noahbachmann/buddy/parts/dispenser/side.png

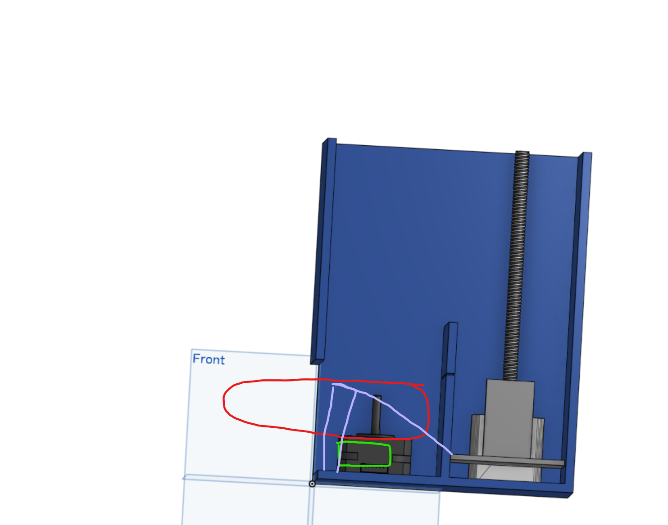
parts/dispenser/side.png
