noahbachmann/buddy/parts/dispenser/up.png

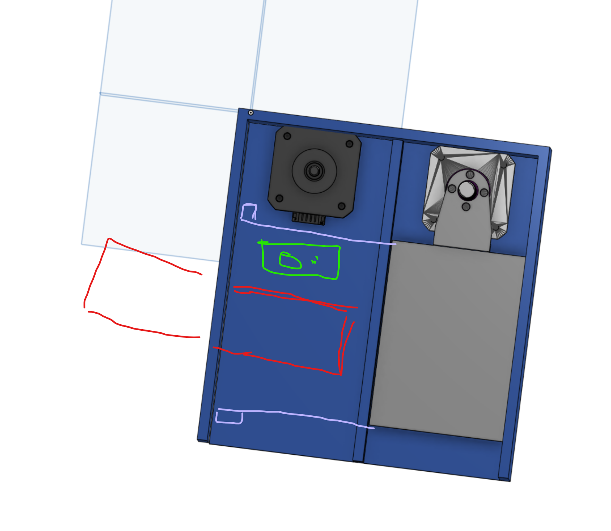
parts/dispenser/up.png
