noahbachmann/buddy/parts/arm/stl/shoulder-mount.stl

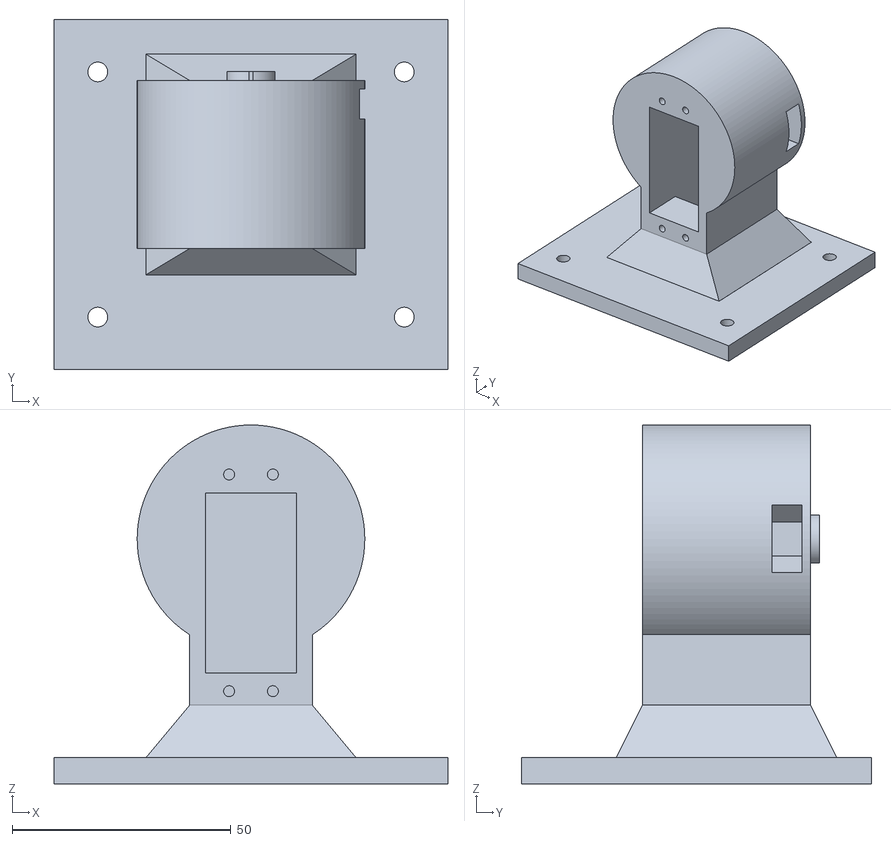
[picture p3: CAD file, 2026-11-06]
parts/arm/stl/shoulder-mount.stl
90.0 x 80.0 x 82.0
