noahbachmann/buddy/parts/dispenser/dispenser-roller.stl

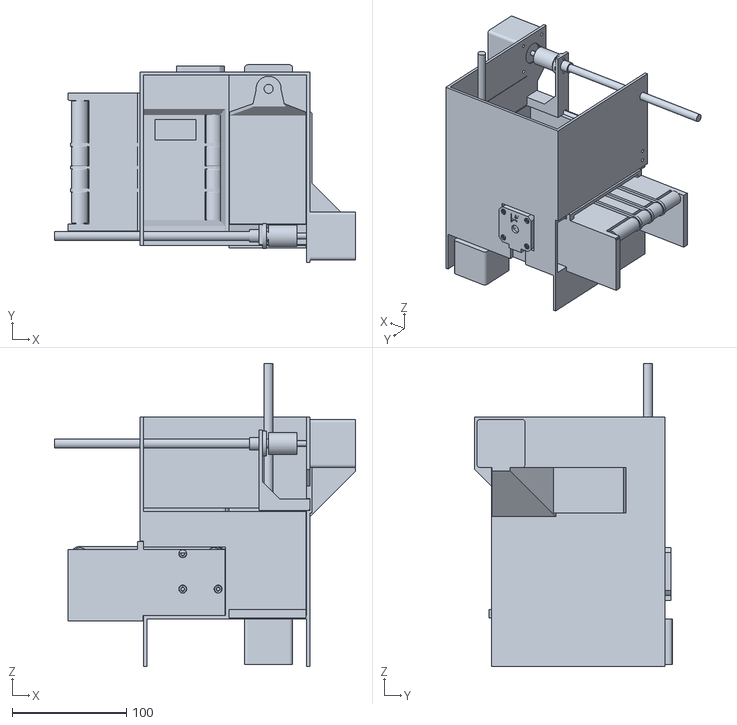
[picture p4: CAD file, 2026-11-11]
parts/dispenser/dispenser-roller.stl
264.0 x 173.3 x 266.0
