noahbachmann/buddy/parts/dispenser/plates/2-petg.stl

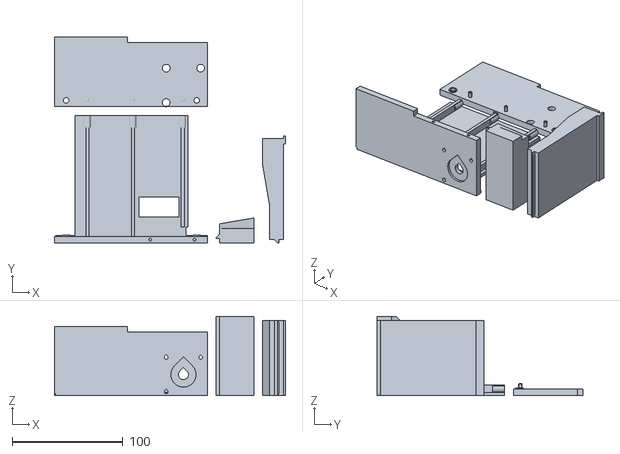
[picture p5: CAD file, 2026-11-11]
parts/dispenser/plates/2-petg.stl
208.1 x 185.5 x 71.6
