noahbachmann/buddy/parts/dispenser/ref/lift.stl

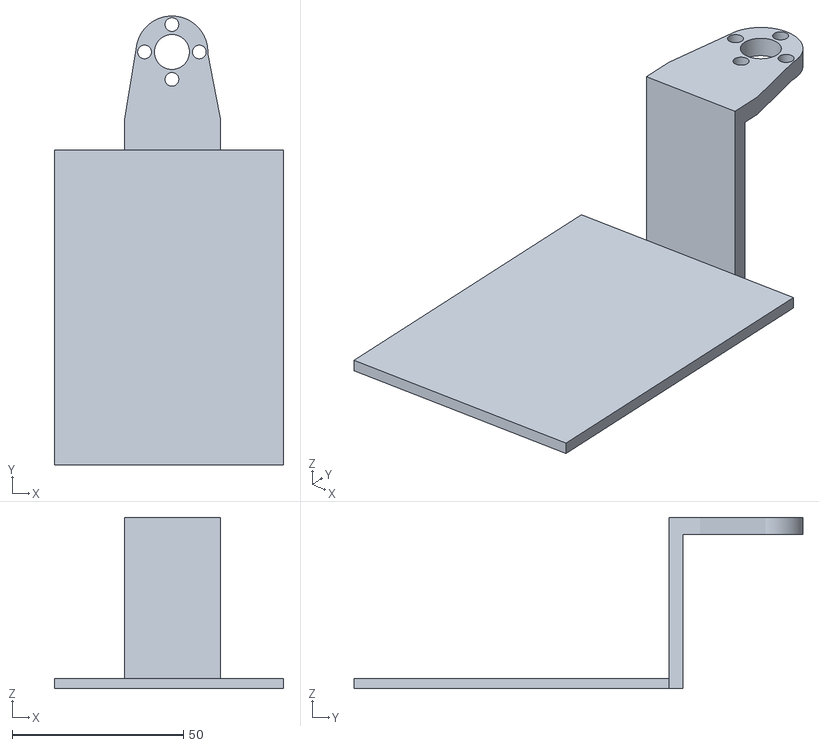
[picture p6: CAD file, 2026-11-07]
parts/dispenser/ref/lift.stl
67.0 x 131.1 x 50.0
