noahbachmann/buddy/parts/dispenser/stl/pusher.stl

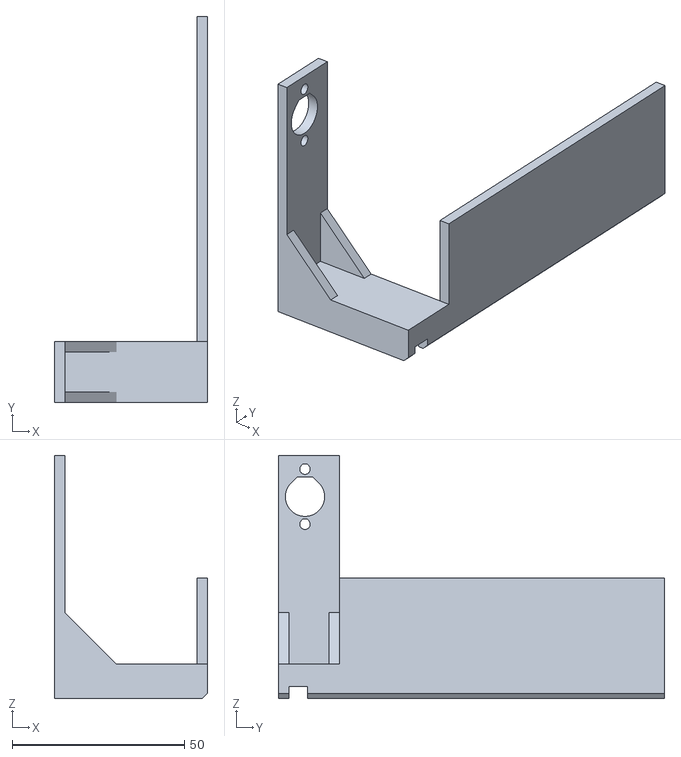
[picture p7: CAD file, 2026-11-11]
parts/dispenser/stl/pusher.stl
44.5 x 112.2 x 70.7
