noahbachmann/buddy/parts/tray/tray.3mf

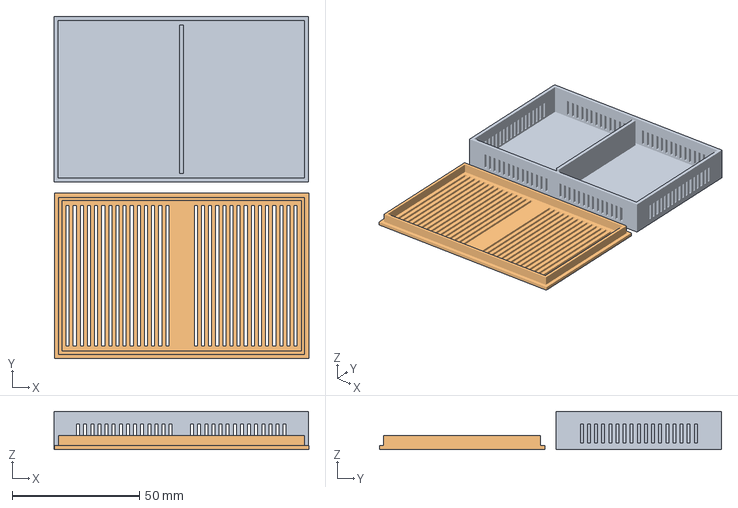
[picture p8: CAD file, 2026-11-09]
parts/tray/tray.3mf
100.1 x 134.4 x 15.0 mm
tray-box.stl
tray-lid.stl
