noahbachmann/buddy/parts/arm/stl/upper-arm-top.stl

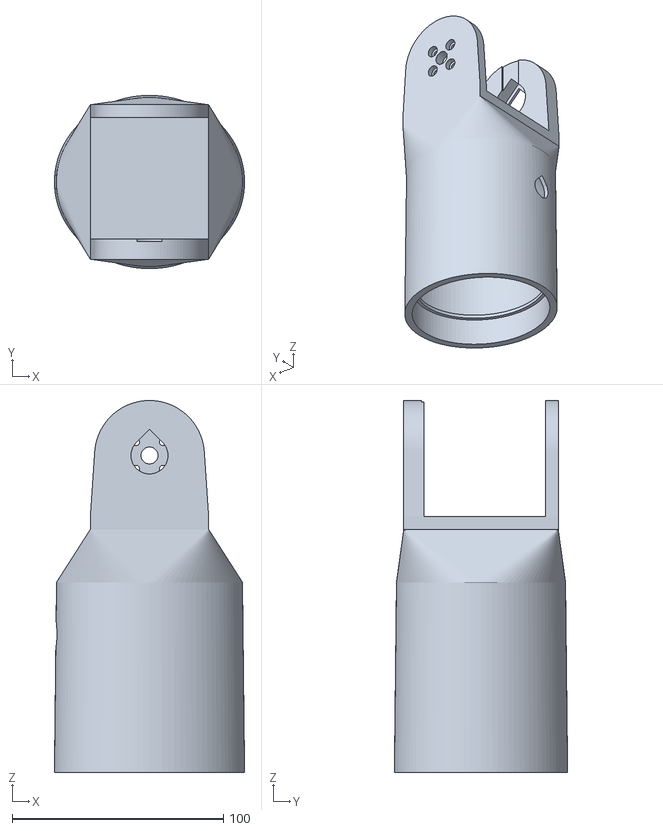
[picture p9: CAD file, 2026-11-06]
parts/arm/stl/upper-arm-top.stl
90.0 x 82.0 x 176.0
