noahbachmann/buddy/parts/dispenser/dispenser.stl

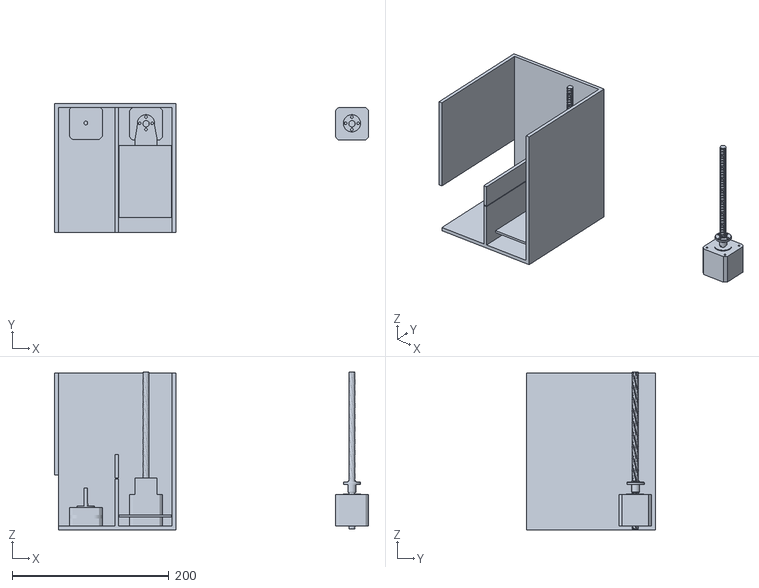
[picture p10: CAD file, 2026-11-07]
parts/dispenser/dispenser.stl
401.0 x 165.0 x 201.2
