noahbachmann/buddy/parts/dispenser/plates/3-pla.stl

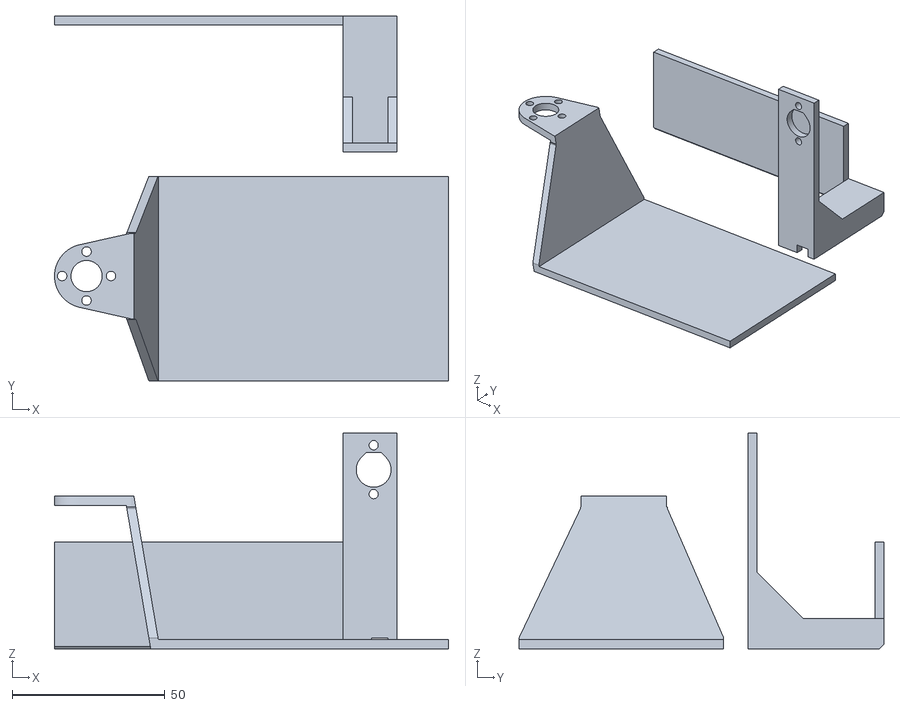
[picture p11: CAD file, 2026-11-10]
parts/dispenser/plates/3-pla.stl
129.0 x 119.5 x 70.7
