noahbachmann/buddy/parts/dispenser/ref/box.stl

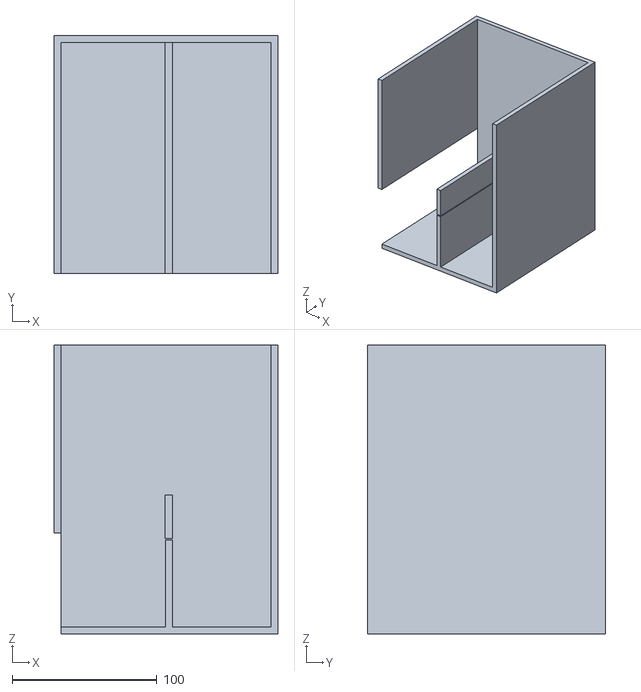
[picture p12: CAD file, 2026-11-07]
parts/dispenser/ref/box.stl
155.0 x 165.0 x 200.0
