noahbachmann/buddy/parts/dispenser/stl/border-h.stl

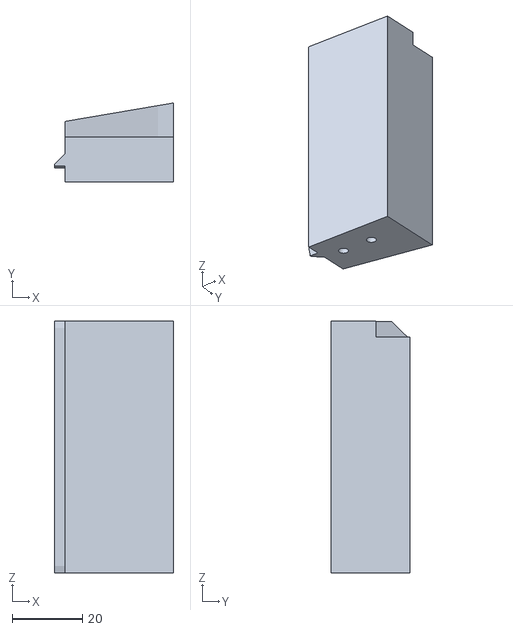
[picture p13: CAD file, 2026-11-11]
parts/dispenser/stl/border-h.stl
34.0 x 22.5 x 71.6
