noahbachmann/buddy/parts/tray/tray-lid.stl

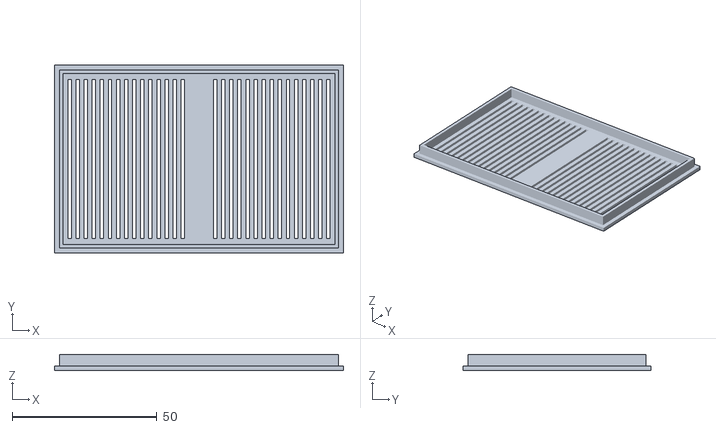
[picture p14: CAD file, 2026-11-07]
parts/tray/tray-lid.stl
100.0 x 65.0 x 5.60
