noahbachmann/buddy/parts/arm/stl/forearm-bottom.stl

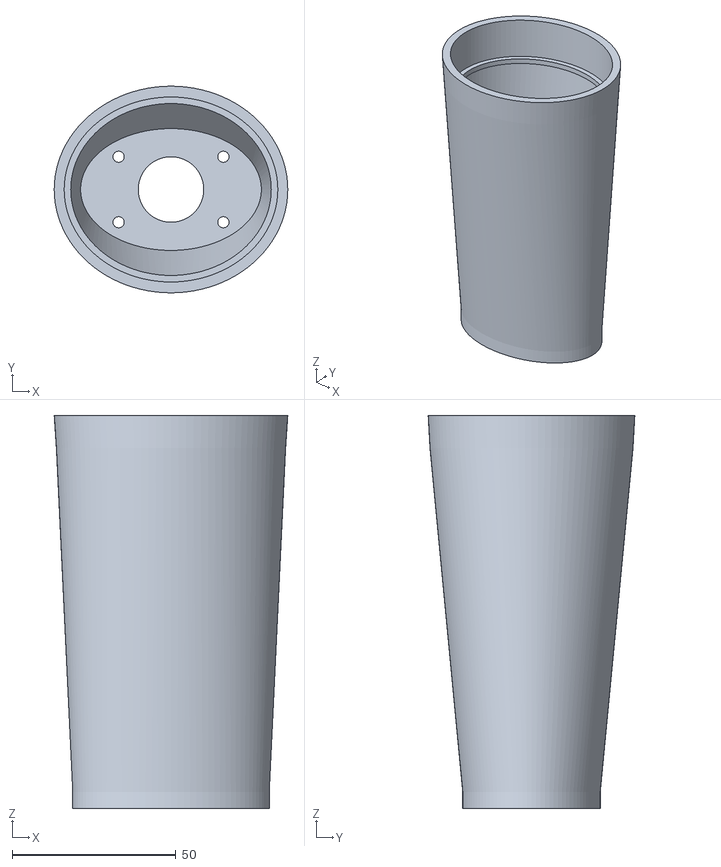
[picture p15: CAD file, 2026-11-06]
parts/arm/stl/forearm-bottom.stl
71.3 x 63.1 x 120.0
