noahbachmann/buddy/parts/dispenser/plates/1-petg-fine.stl

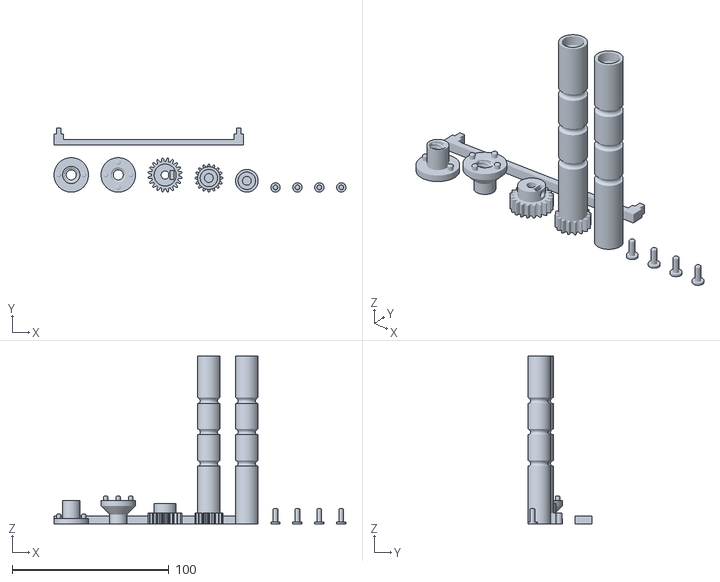
[picture p16: CAD file, 2026-11-09]
parts/dispenser/plates/1-petg-fine.stl
186.3 x 41.0 x 106.9
