noahbachmann/buddy/parts/dispenser/ref/m4023.stl

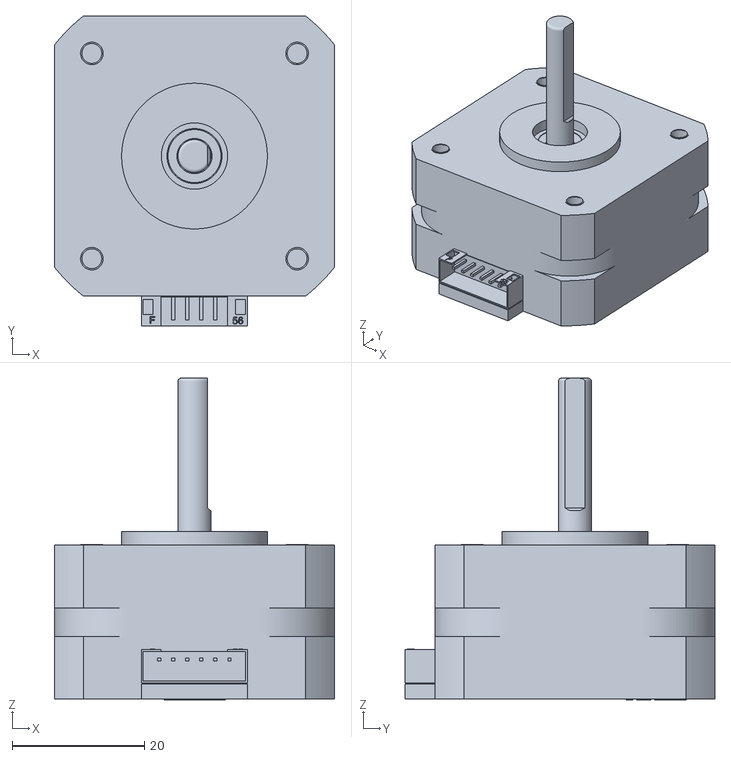
[picture p17: CAD file, 2026-11-07]
parts/dispenser/ref/m4023.stl
42.3 x 46.8 x 48.6
