noahbachmann/buddy/parts/dispenser/stl/roller-frame.stl

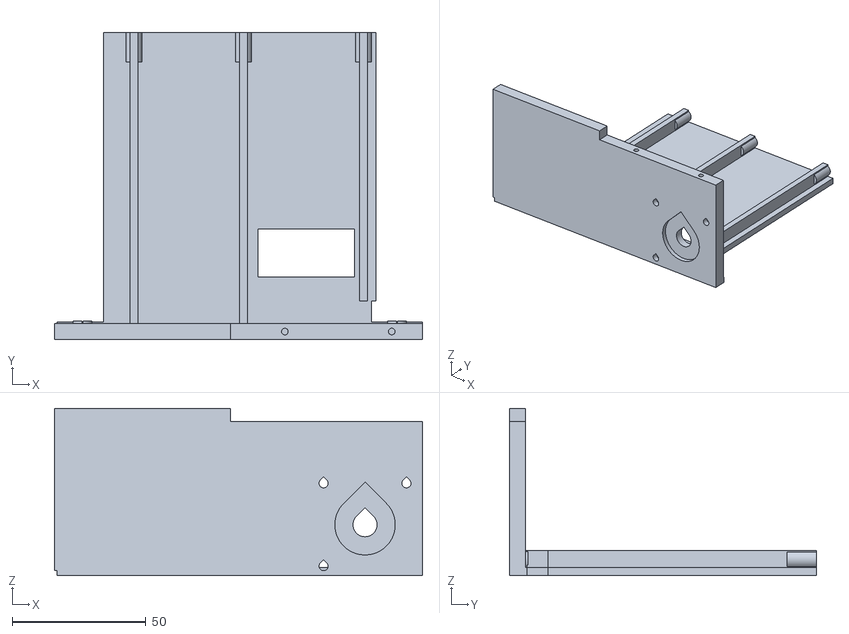
[picture p18: CAD file, 2026-11-11]
parts/dispenser/stl/roller-frame.stl
137.7 x 114.9 x 62.6
