noahbachmann/buddy/parts/tray/tray-box.stl

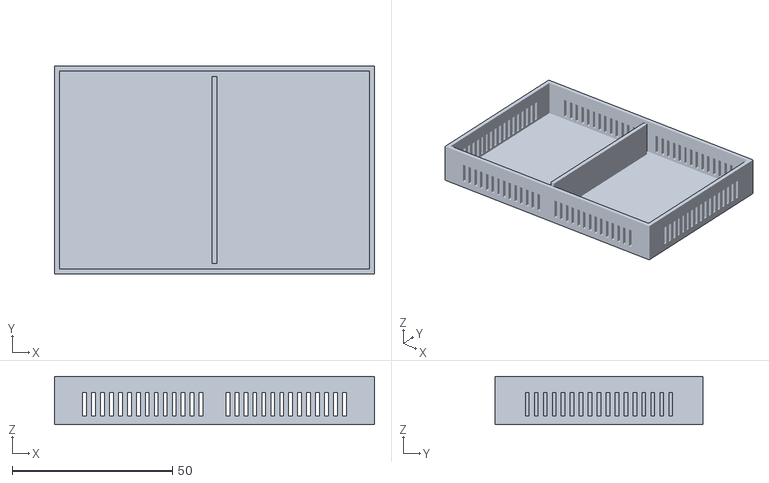
[picture p19: CAD file, 2026-11-06]
parts/tray/tray-box.stl
100.0 x 65.0 x 15.0
