noahbachmann/buddy/parts/arm/stl/forearm-top.stl

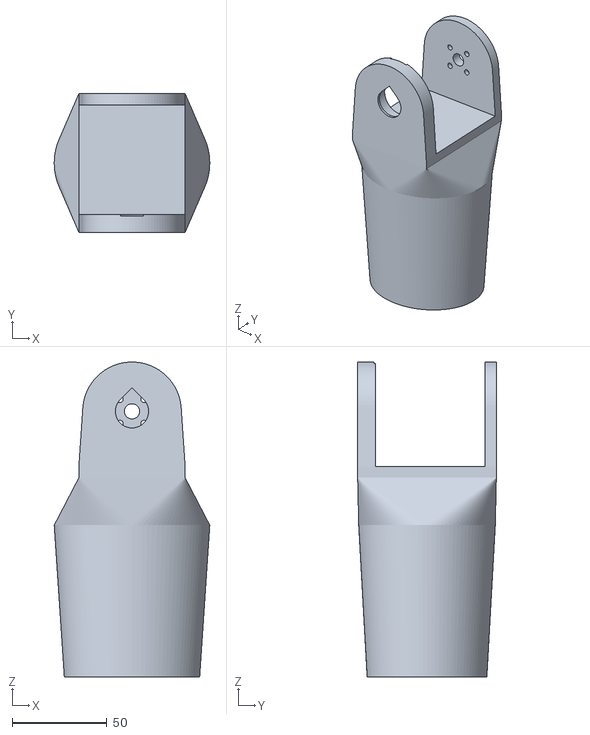
[picture p20: CAD file, 2026-11-06]
parts/arm/stl/forearm-top.stl
82.0 x 73.1 x 166.0
