noahbachmann/buddy/parts/dispenser/plates/0-fit-test.stl

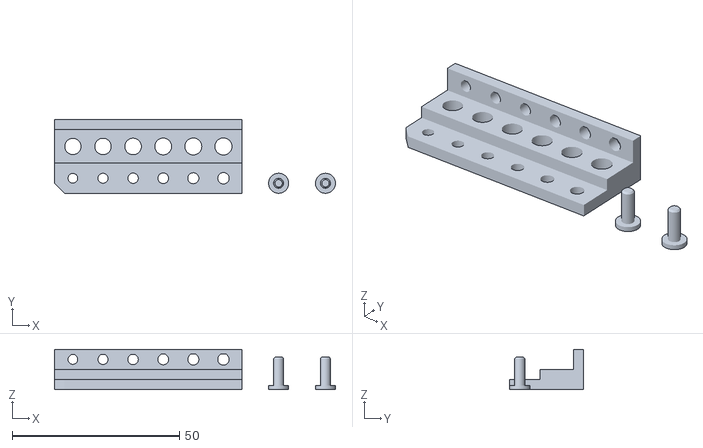
[picture p21: CAD file, 2026-11-09]
parts/dispenser/plates/0-fit-test.stl
84.0 x 22.0 x 12.0
