noahbachmann/buddy/parts/dispenser/stl/border-b.stl

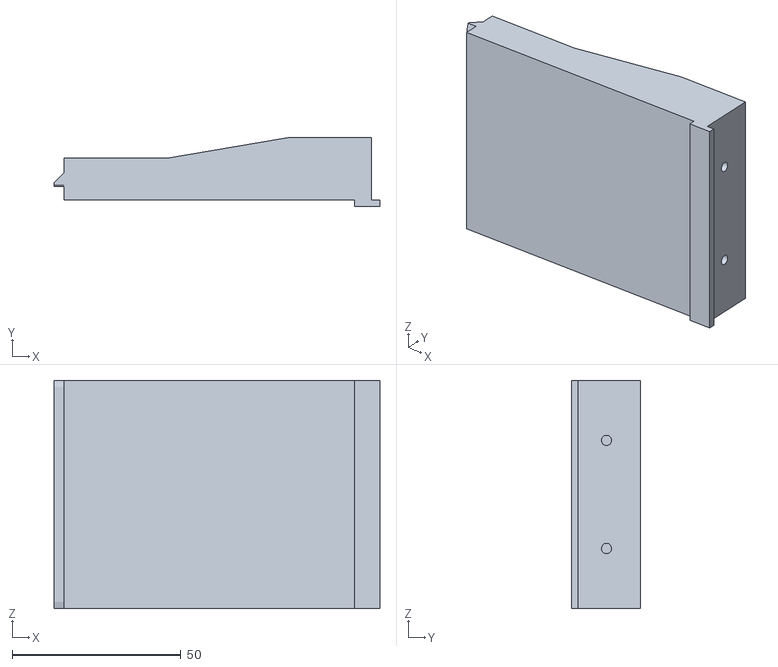
[picture p22: CAD file, 2026-11-11]
parts/dispenser/stl/border-b.stl
96.5 x 20.5 x 67.6
