noahbachmann/buddy/parts/arm/stl/couplers.stl

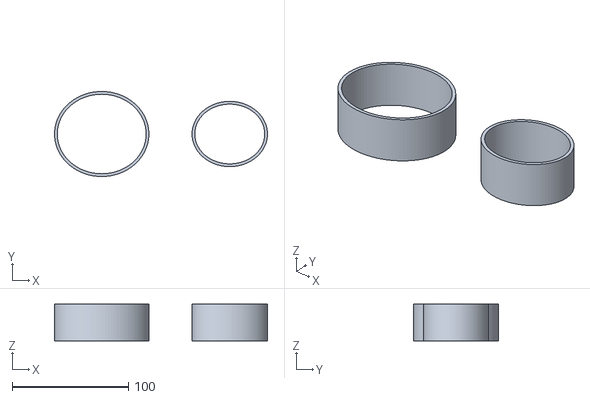
[picture p23: CAD file, 2026-11-06]
parts/arm/stl/couplers.stl
183.0 x 73.1 x 31.5
