noahbachmann/buddy/parts/dispenser/stl/case-spares.stl

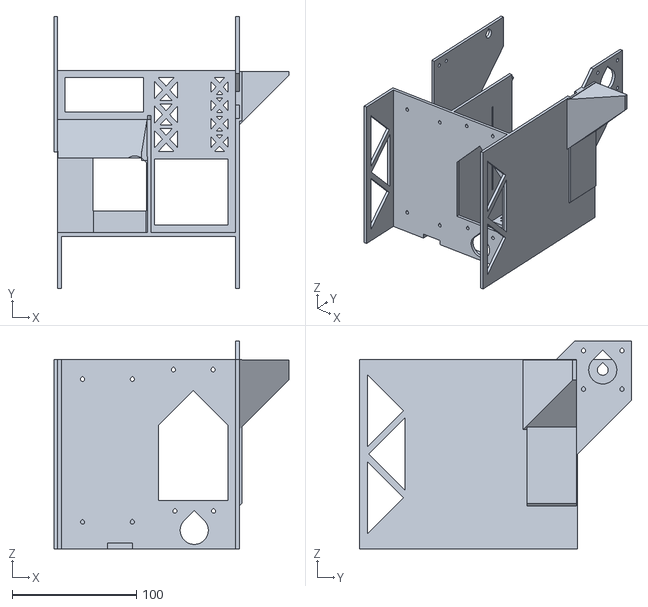
[picture p24: CAD file, 2026-11-10]
parts/dispenser/stl/case-spares.stl
189.0 x 218.8 x 167.1
