noahbachmann/buddy/parts/arm/stl/upper-arm-bottom.stl

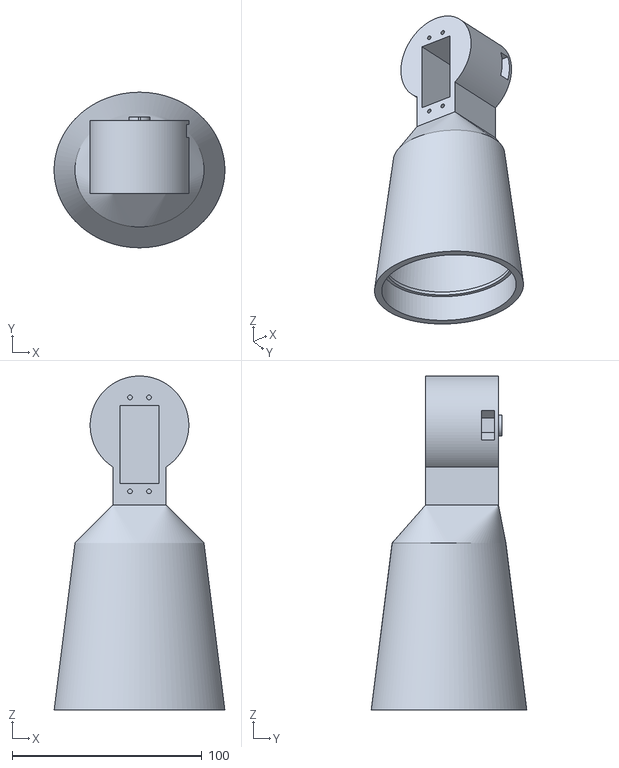
[picture p25: CAD file, 2026-11-06]
parts/arm/stl/upper-arm-bottom.stl
90.0 x 82.0 x 176.0
