noahbachmann/buddy/parts/dispenser/stl/lift.stl

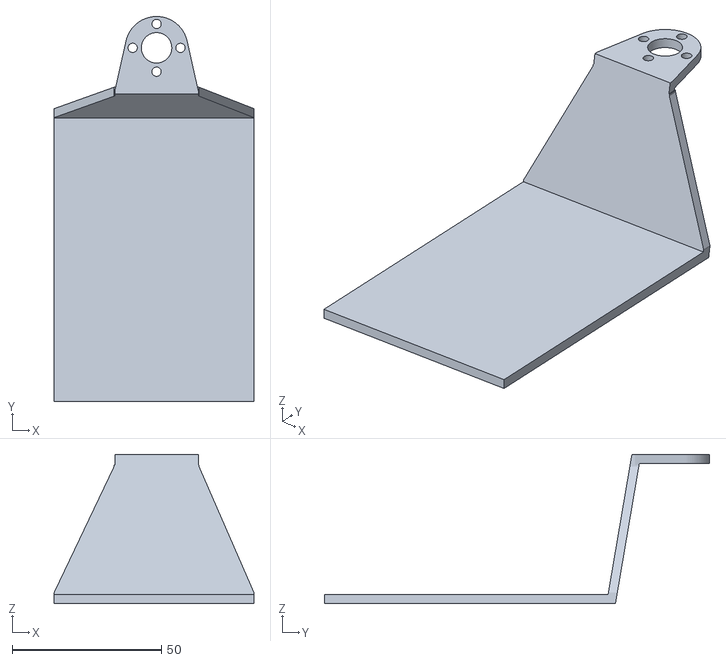
[picture p26: CAD file, 2026-11-10]
parts/dispenser/stl/lift.stl
67.0 x 129.0 x 50.0
