noahbachmann/buddy/parts/dispenser/stl/case.stl

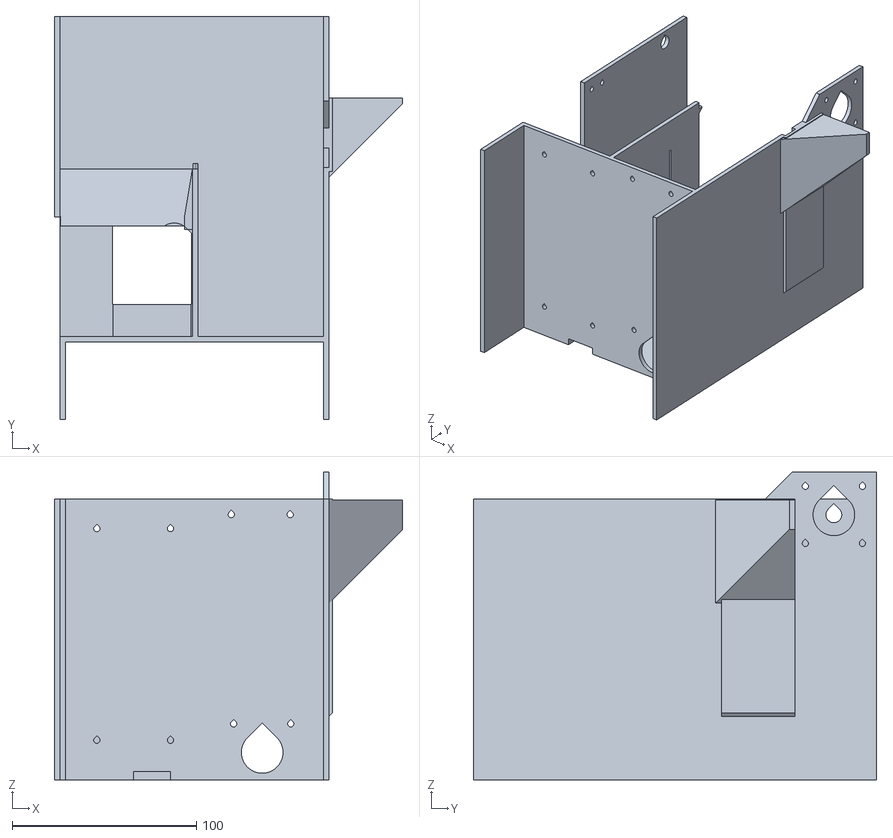
[picture p27: CAD file, 2026-11-09]
parts/dispenser/stl/case.stl
189.0 x 218.8 x 167.1
