noahbachmann/buddy/parts/dispenser/stl/front-plate.stl

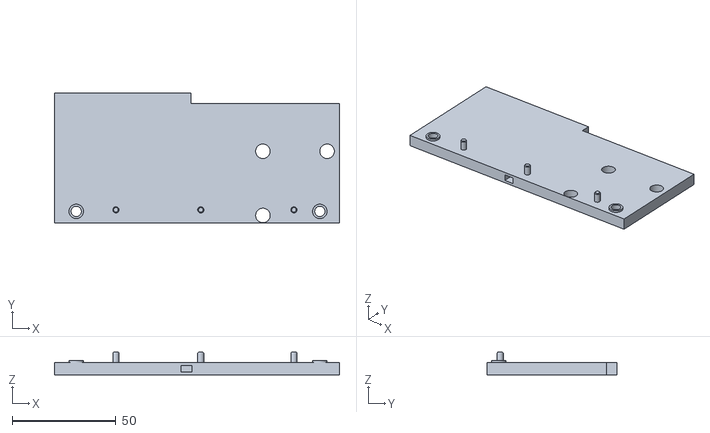
[picture p28: CAD file, 2026-11-09]
parts/dispenser/stl/front-plate.stl
137.7 x 62.6 x 11.0
