noahbachmann/buddy/parts/dispenser/stl/fit-test.stl

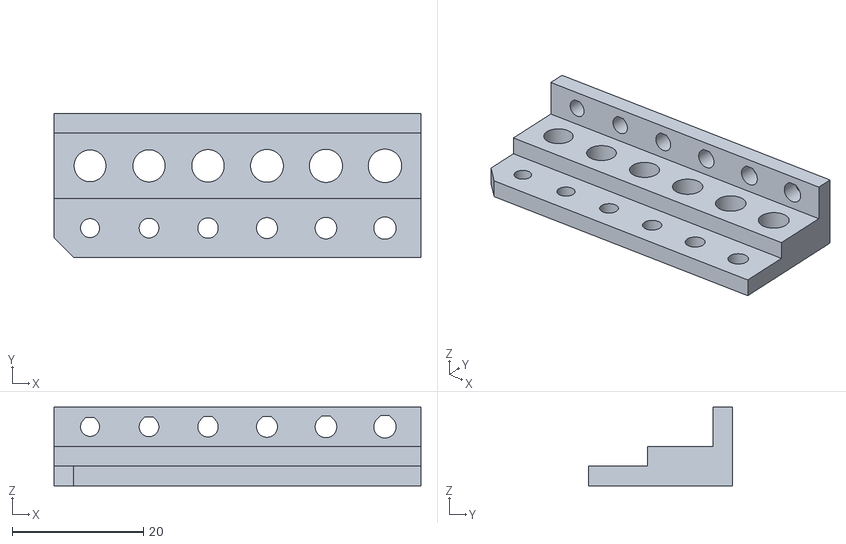
[picture p29: CAD file, 2026-11-09]
parts/dispenser/stl/fit-test.stl
56.0 x 22.0 x 12.0
