noahbachmann/buddy/parts/dispenser/stl/border-pin.stl

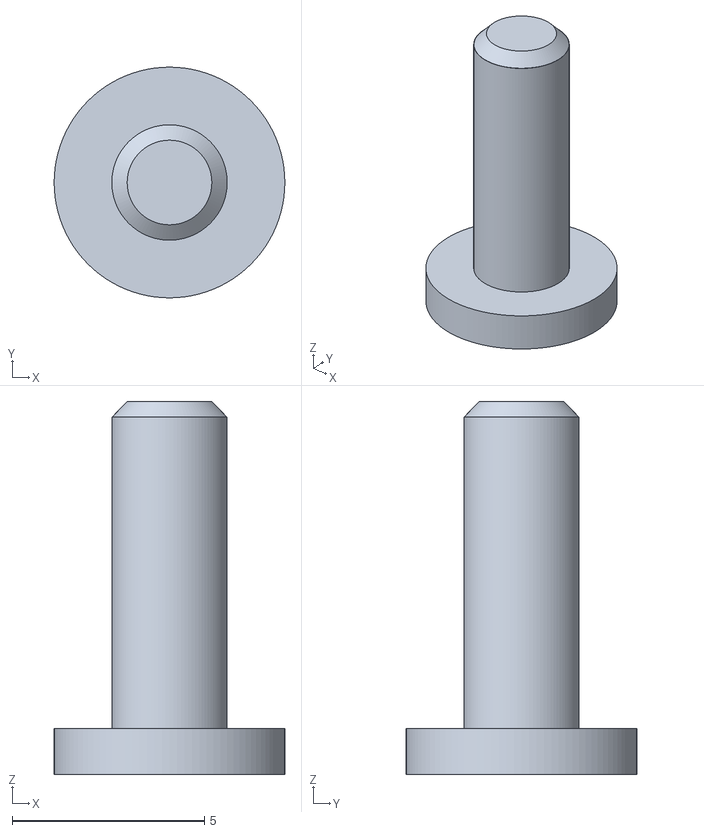
[picture p30: CAD file, 2026-11-09]
parts/dispenser/stl/border-pin.stl
6.00 x 6.00 x 9.70
