noahbachmann/buddy/parts/dispenser/stl/drive-drum.stl

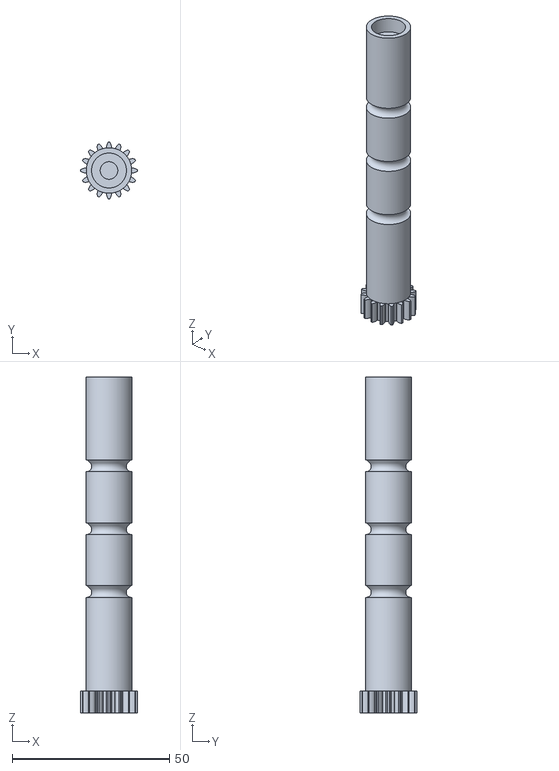
[picture p31: CAD file, 2026-11-09]
parts/dispenser/stl/drive-drum.stl
18.0 x 18.0 x 106.9
