noahbachmann/buddy/parts/dispenser/stl/idler-drum.stl

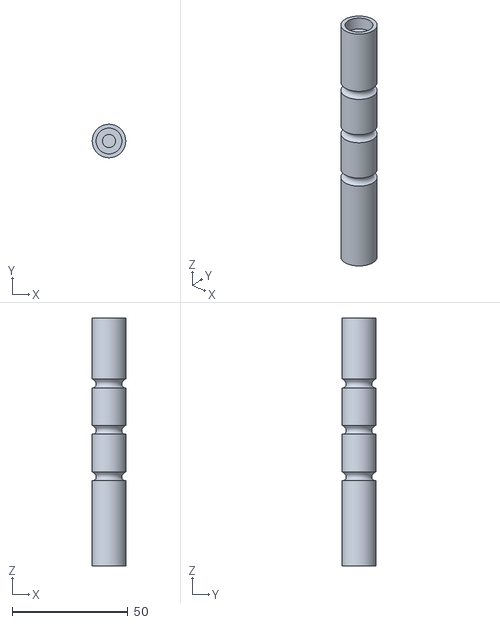
[picture p32: CAD file, 2026-11-09]
parts/dispenser/stl/idler-drum.stl
14.5 x 14.5 x 106.9
