noahbachmann/buddy/parts/dispenser/stl/gate-left.stl

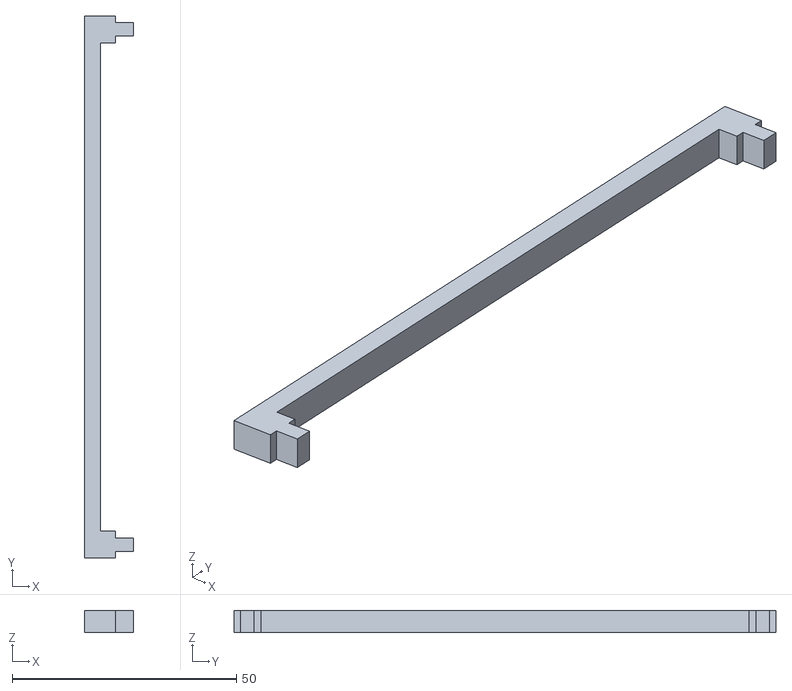
[picture p33: CAD file, 2026-11-09]
parts/dispenser/stl/gate-left.stl
11.0 x 120.9 x 5.00
