noahbachmann/buddy/parts/dispenser/stl/motor-gear.stl

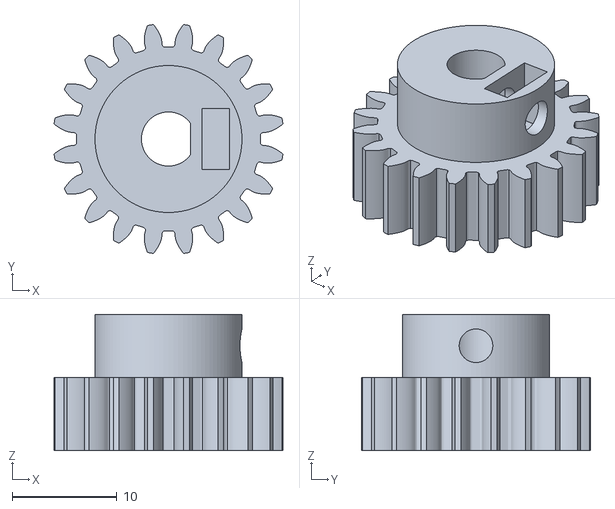
[picture p34: CAD file, 2026-11-07]
parts/dispenser/stl/motor-gear.stl
21.8 x 21.8 x 13.0
