noahbachmann/buddy/parts/dispenser/border-pin.scad

// Printed pin for the borders (4×: 2 through the left wall into border H, 2 from below into border B). Head down.
include <lib.scad>
border_pin();
