noahbachmann/buddy/parts/dispenser/drive-drum.scad

// Drive drum: 16T gear + 3 O-ring grooves, 2x 685ZZ pressed into the ends. Print gear down.
include <lib.scad>
drum(true);
