noahbachmann/buddy/parts/dispenser/motor-gear.scad

// 20T gear on the 4023's D-shaft, M3 set screw onto the flat. Print gear down.
include <lib.scad>
translate([0, 0, -gear_z0]) motor_gear();
