noahbachmann/buddy/parts/dispenser/assembly.scad

// Roller + pusher in the case (Dev's box + changes). Preview only (F5). part = one placed piece for make_copy.py and the checks.
// Poses: push = 0 (home) .. 1 (end of stroke), lift_top = lift plate top (push_lift while pushing).
include <lib.scad>

part = "all";
push = 0;
lift_top = lift_min;

module piece(name) {
  if (name == "frame")           frame();
  else if (name == "front-plate") front_plate();
  else if (name == "drive-drum") drum_tf(drive_x) drum(true);
  else if (name == "idler-drum") drum_tf(idler_x) drum(false);
  else if (name == "motor-gear") motor_tf() motor_gear();
  else if (name == "gate-left")  gate_placed();
  else if (name == "motor")      motor_4023();
  else if (name == "pins")       pins();
  else if (name == "belts")      belts();
  else if (name == "pusher")     pusher(push);
  else if (name == "case-add")   difference() { case_add(); box_cuts(); }
  else if (name == "pusher-motor") m4401();
  else if (name == "pusher-coupling") pu_coupling();
  else if (name == "pusher-screw") pu_screw();
  else if (name == "lift-motor") lift_motor();
  else if (name == "lift-coupling") lift_coupling();
  else if (name == "lift-screw") lift_screw();
  else if (name == "pusher-nut") pu_nut(push);
  else if (name == "case")       case();
  else if (name == "border-h")   h_insert();
  else if (name == "border-b")   b_insert();
  else if (name == "lift")       lift_part(lift_top);
  else if (name == "lift-nut")   lift_nut(lift_top);
}

if (part != "all") piece(part);
else {
  %piece("case");
  color("lightsteelblue") { piece("border-h"); piece("border-b"); }
  color("plum") piece("lift");
  color("goldenrod") piece("lift-nut");
  color("orange") { piece("frame"); piece("front-plate"); }
  color("teal") { piece("drive-drum"); piece("idler-drum"); piece("motor-gear"); }
  color("gold") piece("gate-left");
  color("dimgray") piece("motor");
  color("silver") piece("pins");
  color("black") piece("belts");
  color("tomato") piece("pusher");
  color("lightsteelblue") piece("case-add");   // changes to Dev's box
  color("dimgray") piece("pusher-motor");
  color("silver") { piece("pusher-screw"); piece("pusher-coupling"); piece("lift-screw"); piece("lift-coupling"); }
  color("dimgray") piece("lift-motor");
  color("goldenrod") piece("pusher-nut");
  // card on the belts, centred between the gates
  color("white", 0.6) translate([card_x0, card_yc - card[1] / 2, belt_top]) cube([card[0], card[1], card_t]);
  // pile B on the lift, squared against the right wall, full height
  color("white", 0.6) translate([right_wall[0] - card[0], card_yc - card[1] / 2, lift_top]) cube([card[0], card[1], pile_max]);
}
