noahbachmann/buddy/parts/dispenser/idler-drum.scad

// Idler drum: same grooves as the drive drum, no gear, 2x 685ZZ. Print standing.
include <lib.scad>
drum(false);
