noahbachmann/buddy/parts/dispenser/lift-nut.scad

// TR8x8 nut of the lift, printed. PETG, body down, flange on top (45° cone under it); its 4 pegs press into the tab.
include <lib.scad>
lift_nut_part();
