noahbachmann/buddy/parts/dispenser/pusher-nut.scad

// TR8x8 nut of the pusher, printed (replaces the brass nut). PETG, flange down; its 2 pegs press into the pusher's tab.
include <lib.scad>
pusher_nut();
