noahbachmann/buddy/parts/dispenser/pusher.scad

// Pusher carriage: plate (in the right wall at home) + bar along the front + nut tab. Prints as placed, bottom down.
include <lib.scad>
translate([0, 0, -push_lift]) pusher();
