noahbachmann/buddy/parts/dispenser/fit-test.scad

// Fit test for the printed joints (plate 0): peg holes vertical and horizontal, holes for the Ø5 steel pin.
// Steps in params.scad (fit_steps, pin_steps); step 1 at the chamfered corner.
include <lib.scad>
fit_test();
