noahbachmann/buddy/parts/tools/tests/fixtures/warns.scad

cube(nope);
