noahbachmann/buddy/(list of files, cad)

Other CAD files:
parts/arm/upper-arm-top.scad
parts/dispenser/stl/lift-nut.stl
parts/dispenser/stl/pusher-nut.stl
