noahbachmann/buddy/docs/pico-setup.html

Buddy · Phase 2 · Step 2.2 motion controller

# Pico 2 H servo controller

The Pi 5 sends text commands over USB to a Raspberry Pi Pico 2 H. The Pico drives the servos from its own hardware PWM, keeps every servo inside its limits, and lets go of all of them when the Pi goes quiet. The servos run from a separate 5 V supply.

Firmware flashed, wiring in progress Decision D17 Protocol v1 · /dev/buddy-pico

## Breadboard layout

Top view of a 400-hole half-size breadboard, 30 columns. The Pico takes columns 1–20; resistors, servo headers and the capacitor fit into columns 21–30. Only the bottom rails are used: that is the Pico's pin 1–20 side, which has no power pins. VBUS and VSYS sit on the other side, so servo 5 V never runs near them.

Pico pin / header pin signal jumper 5 V jumper / red lead GND jumper / black lead 330 Ω resistor ✕ leave empty (VBUS, VSYS)

Row letters and the rail order differ between brands. Go by the Pico's pin numbers (pin 1 is next to the USB connector, pins 1–20 face the rails you use) and the rails' printed colours. Each column's holes f–j are one connection, so the resistor end in i25 reaches the header pin in f25. Rail holes don't line up exactly with the columns on every board: "below column 23" means roughly there.

Part | From | To | Note
Pico 2 H | h1–h20 (pins 1–20) | c1–c20 (pins 40–21) | Straddles the gap, USB pointing off the left end
Jumper, black | j3 (pin 3 GND) | bottom − rail | Shared ground
Jumper, orange | j4 (pin 4 GP2) | j21 | ch0 signal
Jumper, orange | j5 (pin 5 GP3) | j22 | ch1 signal
Resistor 330 Ω | i21 | i25 | ch0. 1 %: orange, orange, black, black, brown (5 %: orange, orange, brown). Either way round
Resistor 330 Ω | h22 | h28 | ch1. Lies next to the ch0 resistor; touching is harmless
3-pin header | f25–f27 | f28–f30 | One piece each, broken off the 1 × 40 strip
Jumper, red | j26 · j29 | bottom + rail | Servo 5 V
Jumper, black | j27 · j30 | bottom − rail | Servo GND
Capacitor 1000 µF | − leg (stripe): − rail, below col 21 | + leg: + rail, below col 22 | Reversed it heats up and can burst
DC socket leads (22 AWG) | black: − rail, below col 23 | red: + rail, below col 24 | Supply unplugged while wiring
Servo plugs | ch0 (pan) on f25–f27 | ch1 (tilt) on f28–f30 | Orange on col 25/28, brown on col 27/30
Top rails, a1/b1, a2/b2 | Stay empty. Nothing connects to VBUS (pin 40) or VSYS (pin 39).

Before the first power-up, with the supply unplugged: continuity between the − rail (both ends: some half-size boards split their rails in the middle) and Pico pin 3; no continuity between the + rail and Pico pins 39/40, nor between the + and − rails.

## Circuit

USB signal 3.3 V (orange lead) servo 5 V (red lead) ground (brown lead) must stay unconnected

## Electrical rules

Servo 5 V never meets the Pi

Nothing from the servo rail goes to Pico pin 39 or 40. Two servos starting together pull ~1.5 A, which would brown out the Pi's 1.6 A USB budget.

Grounds are shared

Supply −, servo GND and Pico pin 3 meet on one rail. Without a common reference the servos jitter or ignore the signal.

Capacitor at the servos

1000 µF covers the current spikes the long supply lead can't. It is polarised: the stripe leg goes to GND.

Power order

On: Pico USB first, then the servo supply. Off: servo supply first. Check polarity with the multimeter before the first connect.

## Pinout

Pico pin | Signal | Goes to
3 | GND | Ground rail (shared ground)
4 · GP2 | Servo ch0, head pan | 330 Ω → servo 0 signal
5 · GP3 | Servo ch1, head tilt | 330 Ω → servo 1 signal
6–12 · GP4–GP9 | Servo ch2–ch7 | Reserved for the hand (Phase 3)
14–17, 19–20 · GP10–GP15 | SPI1 | Reserved for the round display (2.4)
39 VSYS · 40 VBUS | — | Nothing. Never servo 5 V.
USB | Power + data | Pi 5, the Pico's only power source

## Firmware behaviour

C++ on Pico SDK 2.3.1 in skeleton/firmware/pico-motion/, a separate CMake project built on the Pi. The protocol header shared/include/buddy/motion_protocol.hpp is shared with the motion service.

Topic | Behaviour
PWM | 150 MHz / 150 = 1 µs tick, wrap 19 999 → 50 Hz. The compare value is the pulse width in µs.
Boot | All channels off. A channel needs LIMIT before it accepts MOVE.
Limits | Per channel, inside a hard 500–2500 µs. Moves outside are clamped and the reply says so.
Ramps | Linear to the target over ms, updated every 20 ms.
Link watchdog | No line for 2 s → all servos relaxed (limp), * RELAXED link.
HW watchdog | 500 ms. A firmware hang reboots the Pico with all channels off.

## Protocol v1

ASCII lines over USB CDC. Every request starts with an id (1–65535) that the reply echoes. Lines starting with * are unsolicited events.

Request | Reply
id HELLO | OK buddy-motion <fw> 1
id LIMIT ch min max | OK, enables, doesn't move
id MOVE ch us ms | OK / OK clamped us
id RELAX ch|* | OK
id PING | OK, every 500 ms from the service
errors | ERR bad-channel|no-limit|bad-args|unknown
events | * DONE ch us · * RELAXED link · * BOOT fw

# ssh -t buddy picocom --echo --omap crlf /dev/buddy-pico
1 HELLO
1 OK buddy-motion 0.1.0 1
2 LIMIT 0 1000 2000
2 OK                 # no movement yet
3 MOVE 0 1500 0
3 OK                 # jumps to centre
4 MOVE 0 1000 1000
4 OK
* DONE 0 1000        # after a 1 s ramp
5 MOVE 0 2400 500
5 OK clamped 2000
# … 2 s silence …
* RELAXED link

## Build order

1. Check the supply
  Multimeter on V⎓: 5.0–5.3 V between the socket's + and − wires. −5 V means swapped polarity.
2. Wire the breadboard
  As in the diagram. Before power: continuity check that servo + and Pico 39/40 are not connected, rail − and Pico pin 3 are.
3. Set up the Pi
  setup.sh pico: arm-none-eabi GCC, picotool 2.3.1 in /opt/picotool, picocom, udev rule for /dev/buddy-pico.
4. Build and flash
  deploy/deploy.sh --firmware. First flash: hold BOOTSEL while plugging in. Later flashes reboot the Pico via picotool load -x -f.
5. Test by hand
  picocom session above, then the load test with vcgencmd get_throttled and the multimeter on the servo rail.

## Done when

- MOVE sweeps a servo, and a move past its limit is clamped, not executed.
- With no input for 2 s, every servo goes limp.
- While both servos move under load, vcgencmd get_throttled stays 0x0 and the servo rail stays ≥ 4.8 V.
- deploy/test.sh --pi -R MotionProtocol passes.

Source: docs/guides/02-02-motion-controller.md. That guide wins if this page and it disagree.
