noahbachmann/buddy/skeleton/services/brain/main.cpp

// brain: transcript → intent → skill command.
//
//   buddy-brain                  live: buddy/ears/transcript in, buddy/<skill>/cmd + buddy/brain/intent out
//   buddy-brain --test "text"…   offline: prints the intent for each argument (no MQTT)
//
// Routing: an intent's skill names the service; the command goes to buddy/<skill>/cmd as
// {"action": <intent>[, "query": …][, "device": …][, "fallback": {"action": …[, "query": …]}]}.
// Not understood → buddy/voice/say "Sorry, …".
#include <chrono>
#include <cstring>
#include <iostream>
#include <optional>
#include <string>

#include <nlohmann/json.hpp>

#include "buddy/config.hpp"
#include "buddy/lifecycle.hpp"
#include "buddy/mqtt.hpp"
#include "buddy/systemd.hpp"
#include "buddy/topics.hpp"
#include "rules.hpp"

namespace {

using namespace buddy;
using namespace buddy::brain;
using json = nlohmann::json;

const char* kNotUnderstood = "Sorry, I didn't catch that.";

std::string_view command_topic(const std::string& skill) {
    if (skill == "spotify") return topic::spotify_cmd;
    if (skill == "hue") return topic::hue_cmd;
    if (skill == "motion") return topic::motion_cmd;
    return {};
}

// query, device and fallback of a command, the fields that skill command and intent event share
void add_arguments(json& msg, const Intent& intent) {
    if (!intent.query.empty()) msg["query"] = intent.query;
    if (!intent.device.empty()) msg["device"] = intent.device;
    if (!intent.fallback_name.empty()) {
        msg["fallback"] = {{"action", intent.fallback_name}};
        if (!intent.fallback_query.empty()) msg["fallback"]["query"] = intent.fallback_query;
    }
}

json intent_event(const std::optional<Intent>& intent, const std::string& text) {
    json msg = {{"intent", intent ? intent->name : "unknown"}, {"text", text}};
    if (intent) msg["skill"] = intent->skill;
    if (intent) add_arguments(msg, *intent);
    return msg;
}

int test(const IntentParser& parser, int argc, char** argv) {
    for (int i = 2; i < argc; ++i) {
        const auto intent = parser.parse(argv[i]);
        std::cout << "\"" << argv[i] << "\" → " << intent_event(intent, argv[i]).dump() << std::endl;
    }
    return 0;
}

} // namespace

int main(int argc, char** argv) {
    install_signal_handlers();
    const RuleParser parser;

    if (argc >= 2 && std::strcmp(argv[1], "--test") == 0) return test(parser, argc, argv);
    if (argc != 1) {
        std::cerr << "usage: " << argv[0] << " [--test \"text\" …]" << std::endl;
        return 2;
    }

    Mqtt mqtt("brain", mqtt_config_from_env());

    mqtt.subscribe(topic::ears_transcript, [&](const std::string&, const std::string& payload) {
        const auto msg = json::parse(payload, nullptr, /*allow_exceptions=*/false);
        if (msg.is_discarded() || !msg.contains("text") || !msg["text"].is_string()) {
            std::cout << "[brain] bad transcript: " << payload << std::endl;
            return;
        }
        const std::string text = msg["text"];
        const auto intent = parser.parse(text);
        const json event = intent_event(intent, text);
        std::cout << "[brain] \"" << text << "\" → " << event["intent"].get<std::string>()
                  << (intent && !intent->query.empty() ? " \"" + intent->query + "\"" : "")
                  << (intent && !intent->device.empty() ? " on \"" + intent->device + "\"" : "") << std::endl;
        mqtt.publish(topic::brain_intent, event.dump());

        if (!intent) {
            mqtt.publish(topic::voice_say, json{{"text", kNotUnderstood}}.dump(), 1);
            return;
        }
        const auto cmd_topic = command_topic(intent->skill);
        if (cmd_topic.empty()) {
            std::cout << "[brain] no route for skill " << intent->skill << std::endl;
            return;
        }
        json cmd = {{"action", intent->name}};
        add_arguments(cmd, *intent);
        mqtt.publish(cmd_topic, cmd.dump(), 1);
    });

    if (!mqtt.start()) return 0;
    while (running()) {
        systemd::notify_watchdog();
        sleep(std::chrono::seconds(5));  // pings go out every WatchdogSec / 4 at most
    }

    mqtt.stop();
    return 0;
}
