noahbachmann/buddy/skeleton/services/brain/rules.cpp

#include "rules.hpp"

#include <cctype>
#include <map>
#include <sstream>

namespace buddy::brain {

namespace {

// Applied to the normalized text, in order.
const std::vector<std::pair<std::regex, std::string>>& rewrites() {
    static const std::vector<std::pair<std::regex, std::string>> r = {
        // whisper spellings of "Spotify"
        {std::regex(R"(\bspot+(y|i)? ?(f(y|i|ie|ai))\b)"), "spotify"},
        {std::regex(R"(\bspot (to|the|a|of) ?(find|fine|fly|five)\b)"), "spotify"},  // seen 2026-10-23: "Play spot to find"
        // politeness and addressing, at either end
        {std::regex(R"(^(hey |ok |okay )?(buddy |jarvis )?(please |can you |could you |would you |will you )*)"), ""},
        {std::regex(R"(( please| for me| buddy| thanks| thank you| right now| now)+$)"), ""},
        // whisper sometimes hears "play" as past tense or third person
        {std::regex(R"(^(played|plays|playing) )"), "play "},
        // ... and "my" as "mode", "ma", "me", … in "play my playlist"
        {std::regex(R"(^play (from )?(mode|ma|mai|me|mi|mine|mike) (playlist|list)\b)"), "play $1my $3"},
        // "put on X" = "play X"
        {std::regex(R"(^put on )"), "play "},
        {std::regex(R"( percent\b)"), ""},
        // Spotify is the only music app: never a speaker name
        {std::regex(R"( on spotify$)"), ""},
    };
    return r;
}

// "fifty" → "50", "twenty five" → "25" (whisper writes most numbers as digits, but not always)
std::string number_words_to_digits(const std::string& text) {
    static const std::map<std::string, int> units = {
        {"zero", 0}, {"one", 1}, {"two", 2}, {"three", 3}, {"four", 4}, {"five", 5}, {"six", 6}, {"seven", 7},
        {"eight", 8}, {"nine", 9}, {"ten", 10}, {"eleven", 11}, {"twelve", 12}, {"thirteen", 13}, {"fourteen", 14},
        {"fifteen", 15}, {"sixteen", 16}, {"seventeen", 17}, {"eighteen", 18}, {"nineteen", 19}};
    static const std::map<std::string, int> tens = {{"twenty", 20}, {"thirty", 30}, {"forty", 40}, {"fifty", 50},
                                                    {"sixty", 60}, {"seventy", 70}, {"eighty", 80}, {"ninety", 90}};
    std::istringstream in(text);
    std::vector<std::string> words;
    for (std::string w; in >> w;) words.push_back(w);
    std::string out;
    for (std::size_t i = 0; i < words.size(); ++i) {
        std::string w = words[i];
        if (const auto t = tens.find(w); t != tens.end()) {
            int n = t->second;
            if (i + 1 < words.size()) {
                if (const auto u = units.find(words[i + 1]); u != units.end() && u->second < 10) {
                    n += u->second;
                    ++i;
                }
            }
            w = std::to_string(n);
        } else if (w == "hundred" || (w == "a" && i + 1 < words.size() && words[i + 1] == "hundred")) {
            if (w == "a") ++i;
            w = "100";
        } else if (const auto u = units.find(w); u != units.end() && u->second >= 10) {
            w = std::to_string(u->second);  // "one", "two" stay words: "skip this one", "bound two"
        }
        out += (out.empty() ? "" : " ") + w;
    }
    return out;
}

// Speaker names: "desktop one" → "desktop 1", "pixel eight" → "pixel 8". Only here: elsewhere "one" stays a word.
std::string device_digits(const std::string& device) {
    static const std::map<std::string, std::string> digits = {{"one", "1"}, {"two", "2"},   {"three", "3"},
                                                              {"four", "4"}, {"five", "5"}, {"six", "6"},
                                                              {"seven", "7"}, {"eight", "8"}, {"nine", "9"}};
    std::istringstream in(device);
    std::string out;
    for (std::string w; in >> w;) {
        if (const auto d = digits.find(w); d != digits.end()) w = d->second;
        out += (out.empty() ? "" : " ") + w;
    }
    return out;
}

// What a light rule's subject names: "the kitchen lights" → "kitchen", "desk lamp" → "desk lamp", "the lights" →
// "" (the default room), "all the lights" → "all", "everything" → "everything" (hue: every light).
std::string light_device(std::string s) {
    for (const char* lead : {"the ", "my "})
        if (s.starts_with(lead)) s.erase(0, std::string(lead).size());
    if (s.starts_with("all ")) return "all";
    for (const char* tail : {"lights", "light"}) {
        const std::string t = tail;
        if (s == t) return "";
        if (s.ends_with(" " + t)) return s.substr(0, s.size() - t.size() - 1);
    }
    if (s.ends_with("lamps")) s.pop_back();
    return s;
}

// "play music" / "play spotify" carry no query: resume instead of searching.
bool generic_query(const std::string& q) {
    static const std::regex generic(R"((some |my |the )?(music|spotify|something|songs?|tunes)( on spotify)?|it|this( song)?)");
    return std::regex_match(q, generic);
}

// Filler that can't be part of a name: "songs by taylor swift" → "taylor swift", "the song party by daughter" →
// "party by daughter", "bound 2 from kanye west" → "bound 2 by kanye west" (spotify searches "<title> by
// <artist>" with field filters). "some strokes" stays: "Some Nights" is a song; spotify ignores the "some".
std::string canonical_query(std::string q) {
    static const std::regex filler(R"(^((songs|music|something|anything|stuff|tracks) by|the song|the track|a song by) )");
    q = std::regex_replace(q, filler, "");
    if (const auto from = q.rfind(" from "); from != std::string::npos && from > 0) q.replace(from, 6, " by ");
    return q;
}

} // namespace

std::string normalize(std::string_view text) {
    std::string out;
    bool space = true;  // drops leading spaces and collapses runs
    for (const char c : text) {
        const auto u = static_cast<unsigned char>(c);
        if (std::isalnum(u)) {
            out += static_cast<char>(std::tolower(u));
            space = false;
        } else if (c != '\'' && !space) {  // "don't" → "dont"
            out += ' ';
            space = true;
        }
    }
    if (!out.empty() && out.back() == ' ') out.pop_back();
    out = number_words_to_digits(out);
    for (const auto& [pattern, replacement] : rewrites()) out = std::regex_replace(out, pattern, replacement);
    return out;
}

RuleParser::RuleParser() {
    // Lights first: they need a light word, so they never take a music phrasing. {L} = what is switched: "(the)
    // (kitchen) lights", "desk lamp", "all the lights", "everything" (one capture group); {R} = a bare room ("dim
    // bedroom to 20"); {N} = a percentage.
    auto light = [this](std::string pattern, const char* name, int device_group, int query_group = 0) {
        static const std::vector<std::pair<std::string, std::string>> parts = {
            {"{L}", R"(((?!play |on |off )(?:the |my |all |all the )?(?:[a-z0-9 ]+? )?(?:lights?|lamps?)|everything))"},
            {"{R}", R"(((?:the |my )?(?!the |my )[a-z0-9 ]+?))"},
            {"{N}", R"(([0-9]{1,3}))"},
        };
        for (const auto& [key, value] : parts)
            for (auto at = pattern.find(key); at != std::string::npos; at = pattern.find(key)) pattern.replace(at, key.size(), value);
        rules_.push_back({std::regex("(?:good night |good morning )?(?:" + pattern + ")"), name, "hue", query_group, "", device_group});
    };
    // groups: the prefix above has none, so {L} in "turn on {L}" is 1
    light(R"((?:are|is) {L} (?:still )?(?:on|off))", "status", 1);
    light(R"((?:activate|start|set|turn on|switch to|use) (?:the )?scene ([a-z0-9 ]+))", "scene", 0, 1);
    light(R"((?:(?:activate|start|set|turn on|switch to|use) )?(?:the )?(?!play )([a-z0-9 ]+?) scene)", "scene", 0, 1);
    light(R"((?:turn|switch|put) on {L}|(?:turn|switch|put) {L} on|{L} on)", "on", 0);  // device: first group that matched
    light(R"((?:turn|switch|put) off {L}|(?:turn|switch|put) {L} off|{L} off)", "off", 0);
    light(R"((?:set|dim|turn|put|change|bring) {L} (?:to|at) {N})", "brightness", 1, 2);
    light(R"({L} (?:to|at) {N})", "brightness", 1, 2);
    light(R"(dim {R} (?:to|at) {N})", "brightness", 1, 2);
    light(R"((?:make )?(?:{L}|it|them) brighter|brighter)", "brighter", 1);
    light(R"(turn up {L}|turn {L} up|brighten (?:up )?{L})", "brighter", 0);
    light(R"((?:make )?(?:{L}|it|them) darker|darker)", "darker", 1);
    light(R"(turn down {L}|turn {L} down|dim {L}|dim {R})", "darker", 0);
    light(R"((?:turn|make|set|change|switch) {L} (?:to )?(?!(?:up|down|on|off)\b)([a-z ]+))", "color", 1, 2);

    // Demo gesture for friends (motion "shake" on the demo servo). Whisper doesn't know "Andi's": live 2026-10-29 it
    // heard "on these", "undies", "undistballs", so any ≤ 2 words (or one glued to "balls") count. Remove in 2.5.
    rules_.push_back({std::regex(R"(cut (off|of) ([a-z]+ ){0,2}[a-z]*balls)"), "gesture", "motion", 0, "shake"});

    auto add = [this](const char* pattern, const char* name, int query_group = 0, const char* fixed_query = "") {
        rules_.push_back({std::regex(pattern), name, "spotify", query_group, fixed_query});
    };
    const char* amount = R"(( (a )?(little|bit|lot)( bit)?)?)";  // "turn it down a little bit"
    // A command word that already decides the intent takes a short tail of words: "next tune", "go back a song",
    // "turn it down a notch", "a lot louder". No digits ("turn it down to 30" isn't a step) and no "to" (a speaker).
    const std::string tail = R"(( (?!to\b)[a-z]+))";

    // Order matters: "play the next song" is "next", not a search for "the next song".
    add(R"((pause|stop)( the)?( music| song| spotify| playback| it| playing| this)?|pause( the| this| my)? [a-z]+)",
        "pause");
    add(R"((stop shuffling|shuffle off|turn off shuffle|turn shuffle off|no shuffle))", "shuffle", 0, "off");
    add(R"((shuffle( on| the music| it| this)?|turn on shuffle|turn shuffle on))", "shuffle", 0, "on");
    add(R"((stop repeating|repeat off|turn off repeat|turn repeat off|no repeat))", "repeat", 0, "off");
    add(R"((repeat( this| the)?( song| track)|(play|put) (this|the) (song|track) on repeat))", "repeat", 0, "track");
    add(R"((repeat( on)?|turn on repeat))", "repeat", 0, "context");
    add(R"((whats|what is) (playing|this song|this|the song|that song|that)|(what|which) song is (this|that|playing))",
        "now_playing");
    add((std::string(R"(((play|go to) )?(the )?(next|skip)( (song|track|it|one|(this|the|that)( song| track| one)?))?)") +
         "|next" + tail)
            .c_str(),
        "next");
    add((std::string(R"(((play|go to) )?(the )?(previous|last) (song|track|one)|previous|go back)") + tail + "{0,2}|back")
            .c_str(),
        "previous");
    add(R"((set |turn )?(the )?(volume|it|the music) (to |at )?([0-9]{1,3}))", "set_volume", 5);
    add((std::string(R"((turn (it|the music|the volume|this) up|turn up (the )?(music|volume|it)))") + tail + "{0,3}|" +
         R"((([a-z]+ ){0,3}louder|volume up))" + amount)
            .c_str(),
        "volume_up");
    add((std::string(R"((turn (it|the music|the volume|this) down|turn down (the )?(music|volume|it)))") + tail +
         "{0,3}|" + R"((([a-z]+ ){0,3}(quieter|softer)|volume down))" + amount)
            .c_str(),
        "volume_down");
    add(R"(shuffle (my )?(liked|favorite|favourite|saved) (songs|tracks|music))", "play_liked", 0, "shuffle");
    add(R"(play (my )?(liked|favorite|favourite|saved) (songs|tracks|music))", "play_liked");
    add(R"((resume|continue|unpause|keep playing)( (the )?(music|spotify|playing|playback|song))?)", "play");
    // Own playlists: "play my playlist chill vibes", "play my chill vibes playlist", "play the focus playlist"
    add(R"(play (from )?my (playlist|list)( on spotify)?)", "play_playlist");
    add(R"(play (from )?my (playlist|list) (.+?)( on spotify)?)", "play_playlist", 3);
    add(R"(play (my|the) (.+?) (playlist|list)( on spotify)?)", "play_playlist", 2);
    add(R"(play (.+?)( on spotify)?)", "play", 1);
    add(R"(play|music)", "play");
}

std::optional<Intent> RuleParser::parse(std::string_view text) const {
    const std::string t = normalize(text);
    if (auto intent = parse_device(t)) return intent;
    if (auto intent = parse_core(t)) return intent;
    return parse_room(t);
}

// "turn on the lights in the kitchen", "lights off in my bedroom": a light command plus where.
std::optional<Intent> RuleParser::parse_room(const std::string& t) const {
    static const std::regex room(R"((.+) in (the |my )?([a-z0-9 ]+))");
    std::smatch m;
    if (!std::regex_match(t, m, room)) return std::nullopt;
    auto intent = parse_core(m[1].str());
    if (!intent || intent->skill != "hue" || !intent->device.empty()) return std::nullopt;
    intent->device = light_device(m[3].str());
    return intent;
}

// "move the music to the tv", "play daft punk on the bathroom speaker", "play my liked songs in the kitchen".
// Splits at the last "on"/"in the"/"in my", or a bare "in" before "… speaker"; the skill matches the name itself.
std::optional<Intent> RuleParser::parse_device(const std::string& t) const {
    static const std::regex transfer(
        R"((move|switch|transfer|send|put)( the music| it| this| the song| playback| the playback| spotify)?( back)? to (the |my )?(.+))");
    static const std::regex suffix(R"((.+) (on|in the|in my|in(?= [a-z0-9 ]*speaker$)) (the |my )?(.+))");  // bare "in": live 2026-11-08
    static const std::regex not_a_device(R"(spotify|repeat|shuffle|loop)");
    std::smatch m;
    if (std::regex_match(t, m, transfer)) {
        Intent intent;
        intent.name = "play";  // empty query + device: keep playing, there
        intent.skill = "spotify";
        intent.device = device_digits(m[5].str());
        return intent;
    }
    if (!std::regex_match(t, m, suffix) || std::regex_match(m[4].str(), not_a_device)) return std::nullopt;
    auto intent = parse_core(m[1].str());
    if (!intent || (intent->name != "play" && intent->name != "play_playlist" && intent->name != "play_liked"))
        return std::nullopt;
    intent->device = device_digits(m[4].str());
    // "play shine" + "on you crazy diamond": maybe a title. "play (it) on X", playlists, liked songs: a speaker.
    if (intent->name == "play" && !intent->query.empty()) {
        if (const auto whole = parse_core(t)) {
            intent->fallback_name = whole->name;
            intent->fallback_query = whole->query;
        }
    }
    return intent;
}

std::optional<Intent> RuleParser::parse_core(const std::string& t) const {
    std::smatch m;
    for (const auto& rule : rules_) {
        if (!std::regex_match(t, m, rule.pattern)) continue;
        Intent intent;
        intent.name = rule.name;
        intent.skill = rule.skill;
        intent.query = rule.fixed_query;
        if (rule.query_group > 0) {
            std::string q = m[rule.query_group].str();
            if (rule.name == "play") q = canonical_query(q);
            if (rule.skill == "hue" || !generic_query(q)) intent.query = q;
        }
        if (rule.skill == "hue") {
            // device_group 0: alternatives, each with its own {L}; the one that matched
            std::size_t g = rule.device_group;
            for (std::size_t i = 1; g == 0 && i < m.size(); ++i)
                if (m[i].matched) g = i;
            if (g > 0 && static_cast<int>(g) != rule.query_group) intent.device = light_device(m[g].str());
        }
        return intent;
    }
    return std::nullopt;
}

} // namespace buddy::brain
