noahbachmann/buddy/skeleton/services/game/riftbound/engine.cpp

#include "engine.hpp"

#include <algorithm>

#include "actions.hpp"
#include "pay.hpp"
#include "rules.hpp"

namespace buddy::riftbound {

namespace {

bool is_basic_rune(const Card& card) {
    if (card.type != CardType::Rune) return false;
    for (const char* name : {"Fury Rune", "Calm Rune", "Mind Rune", "Body Rune", "Chaos Rune", "Order Rune"}) {
        if (card.name == name) return true;
    }
    return false;
}

void check_implemented(const Deck& seat0, const Deck& seat1) {
    std::vector<std::string> missing;
    const auto need = [&](const Card* c) {
        if (!is_implemented(*c) && std::find(missing.begin(), missing.end(), c->name) == missing.end()) {
            missing.push_back(c->name);
        }
    };
    for (const Deck* d : {&seat0, &seat1}) {
        need(d->legend);
        need(d->champion);
        for (const auto& e : d->main) need(e.card);
        for (const auto& e : d->runes) need(e.card);
        for (const Card* b : d->battlefields) need(b);
    }
    if (missing.empty()) return;
    std::string list;
    for (const auto& name : missing) list += (list.empty() ? "" : ", ") + name;
    throw std::runtime_error(std::to_string(missing.size()) + " cards not implemented (D21; vanilla mode is for " +
                             "tests): " + list);
}

// 110–114 + 487.5 for one player.
void setup_player(GameState& s, PlayerId p, const Deck& deck) {
    if (deck.legend == nullptr || deck.champion == nullptr || deck.battlefields.empty()) {
        throw std::invalid_argument("deck without legend, chosen champion or battlefields");
    }
    create(s, deck.legend, p, Zone::LegendZone);       // 111
    create(s, deck.champion, p, Zone::ChampionZone);   // 112
    // 114: shuffled before the objects exist, so ids follow deck order and an id tells nothing about its card (128)
    for (const auto* entries : {&deck.main, &deck.runes}) {
        std::vector<const Card*> cards;
        for (const auto& e : *entries) cards.insert(cards.end(), e.count, e.card);
        s.rng.shuffle(cards);
        const Zone zone = entries == &deck.main ? Zone::MainDeck : Zone::RuneDeck;
        for (const Card* c : cards) create(s, c, p, zone);
    }

    // 113 + 487.5: one battlefield at random, the others leave the game
    const auto chosen = s.rng.below(deck.battlefields.size());
    for (std::size_t i = 0; i < deck.battlefields.size(); ++i) {
        if (i != chosen) {
            create(s, deck.battlefields[i], p, Zone::Removed);
            continue;
        }
        const auto where = static_cast<std::uint8_t>(s.battlefields.size());
        s.battlefields.emplace_back().card = create(s, deck.battlefields[i], p, Zone::Battlefield, where);
    }
}

void push_tasks(GameState& s, std::initializer_list<Task> in_order) {
    for (auto it = std::rbegin(in_order); it != std::rend(in_order); ++it) s.tasks.push_back(*it);
}

void start_turn(GameState& s) {
    const PlayerId p = s.turn_player;
    push_tasks(s, {{TaskKind::Awaken, p}, {TaskKind::Beginning, p}, {TaskKind::Hold, p}, {TaskKind::Channel, p},
                   {TaskKind::Draw, p}, {TaskKind::Main, p}});
}

void enter_phase(GameState& s, Phase phase) {
    s.phase = phase;
    s.cleanup_due = true;  // 319.2
}

void empty_pools(GameState& s) {  // 167
    for (Player& pl : s.players) pl.pool = {};
}

void ask(GameState& s, PlayerId player, Purpose purpose, std::vector<Action> options, int min, int max) {
    s.decision = {};
    s.decision.kind = DecisionKind::Choose;
    s.decision.player = player;
    s.decision.purpose = purpose;
    s.decision.options = std::move(options);
    s.decision.min = static_cast<std::uint8_t>(min);
    s.decision.max = static_cast<std::uint8_t>(max);
}

std::vector<Action> take_answer(GameState& s) {
    auto a = std::move(*s.answer);
    s.answer.reset();
    return a;
}

// ---- Showdowns and combat (341–348, 461–468) ----

bool showdown_at(const GameState& s, std::size_t b) { return s.showdown && s.showdown->where == b; }

// 323.7: a showdown is staged where Contested was applied and the contester still has units; derived, not stored.
bool showdown_staged(const GameState& s, std::uint8_t b) {
    const auto& by = s.battlefields[b].contested;
    return by && !showdown_at(s, b) && has_units_at(s, b, *by);
}

// 323.8–323.9: a combat is staged where Contested was applied and both players have units.
bool combat_staged(const GameState& s, std::uint8_t b) {
    if (!s.battlefields[b].contested || (showdown_at(s, b) && s.showdown->combat)) return false;
    return has_units_at(s, b, 0) && has_units_at(s, b, 1);
}

// 323.11–323.12: where the turn player may begin one: staged showdowns without a combat, else staged combats.
std::vector<std::uint8_t> stage_options(const GameState& s) {
    std::vector<std::uint8_t> showdowns, combats;
    for (std::size_t i = 0; i < s.battlefields.size(); ++i) {
        const auto b = static_cast<std::uint8_t>(i);
        if (combat_staged(s, b)) combats.push_back(b);
        else if (showdown_staged(s, b)) showdowns.push_back(b);
    }
    return showdowns.empty() ? combats : showdowns;
}

std::vector<Action> battlefield_options(const GameState& s, const std::vector<std::uint8_t>& where) {
    std::vector<Action> out;
    for (const std::uint8_t b : where) out.push_back({ActionKind::Pick, s.battlefields[b].card, b});
    return out;
}

// 344–345 and 466: a showdown at `b`, focus to the contester; with `combat` a combat showdown (or the running
// showdown becomes one, focus kept: 466.2.c.1.b), attacker and defender designated, start-of-combat events.
void begin(GameState& s, std::uint8_t b, bool combat) {
    const PlayerId contester = *s.battlefields[b].contested;
    if (!s.showdown) {
        s.showdown = Showdown{};
        s.showdown->where = b;
        s.showdown->focus = contester;
    }
    s.cleanup_due = true;
    if (!combat) return;
    Showdown& sd = *s.showdown;
    sd.combat = true;
    sd.attacker = contester;
    Event start = make_event(EventKind::CombatStart, s.obj(s.battlefields[b].card).ref(s.battlefields[b].card), contester);
    std::vector<Event> events{start};
    for (const ObjId id : s.battlefields[b].here) {
        Object& o = s.obj(id);
        if (o.card->type != CardType::Unit) continue;
        const bool attacks = o.controller == contester;
        o.designation = attacks ? Designation::Attacker : Designation::Defender;
        events.push_back(make_event(attacks ? EventKind::Attack : EventKind::Defend, o.ref(id), o.controller));
    }
    for (const Event& e : events) emit(s, e);
}

// 473: `p` scores battlefield `b` once per turn (472). The final point by Conquer needs every battlefield scored this
// turn, else a card instead (473.1.b); Hold isn't restricted (473.1.a.1).
void score(GameState& s, PlayerId p, std::uint8_t b, EventKind how, int excess = 0) {
    Player& pl = s.player(p);
    const auto bit = static_cast<std::uint8_t>(1u << b);
    if (pl.scored & bit) return;
    pl.scored = static_cast<std::uint8_t>(pl.scored | bit);
    const auto all = static_cast<std::uint8_t>((1u << s.battlefields.size()) - 1);
    if (how == EventKind::Conquer && pl.points >= victory_score - 1 && (pl.scored & all) != all) {
        draw(s, p, 1);
    } else {
        ++pl.points;
    }
    s.cleanup_due = true;
    const ObjId card = s.battlefields[b].card;
    Event e = make_event(how, s.obj(card).ref(card), p);
    e.amount = static_cast<std::int16_t>(excess);
    emit(s, e);
}

// 188, 348.2.a, 468.5: `p` establishes control of `b`; gaining it conquers (471.1).
void establish_control(GameState& s, std::uint8_t b, PlayerId p, int excess) {
    Battlefield& bf = s.battlefields[b];
    bf.contested.reset();
    s.cleanup_due = true;
    if (bf.controller == p) return;
    bf.controller = p;
    score(s, p, b, EventKind::Conquer, excess);
}

// The players with units at `b`, in id order.
std::vector<PlayerId> present(const GameState& s, std::uint8_t b) {
    std::vector<PlayerId> out;
    for (PlayerId p = 0; p < player_count; ++p) {
        if (has_units_at(s, b, p)) out.push_back(p);
    }
    return out;
}

// 347.2: the player with focus passes. Everyone in sequence: the showdown closes and its end runs as tasks (348).
void pass_focus(GameState& s) {
    Showdown& sd = *s.showdown;
    if (++sd.passes < player_count) {
        sd.focus = opponent(sd.focus);
        return;
    }
    sd.window = false;
    const PlayerId p = s.turn_player;
    if (sd.combat) {
        push_tasks(s, {{TaskKind::CombatDamage, p}, {TaskKind::CombatResult, p}, {TaskKind::CombatEnd, p}});
    } else {
        s.tasks.push_back({TaskKind::ShowdownEnd, p});
    }
}

// A play or activation in a showdown's window: the passes in sequence start over, and a chain it opens passes focus
// once it closes (346, 347.1.b). Add abilities don't (346.1).
void note_play(GameState& s, bool add) {
    if (!s.showdown || !s.showdown->window) return;
    s.showdown->passes = 0;
    if (s.chain.empty() && !add) s.showdown->pass_focus = true;
}

// ---- Combat damage (467.2) ----

bool designated(const GameState& s, ObjId id, Designation d) {
    const Object& o = s.obj(id);
    return o.card->type == CardType::Unit && o.designation == d;
}

std::vector<ObjId> combatants(const GameState& s, Designation d) {
    std::vector<ObjId> out;
    for (const ObjId id : s.battlefields[s.showdown->where].here) {
        if (designated(s, id, d)) out.push_back(id);
    }
    return out;
}

Designation side(const Showdown& sd, PlayerId p) {
    return p == sd.attacker ? Designation::Attacker : Designation::Defender;
}

// 467.2.a–b: a player's damage: their designated units' Might (negative counts as 0, 143.2.c); stunned units add
// nothing (424.1.b).
int combat_damage(const GameState& s, PlayerId p) {
    int total = 0;
    for (const ObjId id : combatants(s, side(*s.showdown, p))) {
        if (!s.obj(id).stunned) total += std::max(0, might(s, id));
    }
    return total;
}

// What makes the damage marked on `id` lethal (142.4.b): non-zero, at least its Might.
int lethal_need(const GameState& s, ObjId id) { return std::max(1, std::max(0, might(s, id)) - s.obj(id).damage); }

// Assignment order: Tank units first (815.1.c.2), then by id.
int assign_key(const GameState& s, ObjId id) { return (has(s, id, Keyword::Tank) ? 0 : 0x10000) + id; }

struct Candidate {
    ObjId id;
    int need;
    int key;
    bool tank;
};

// Can `rem` damage still be assigned to `rest` under the canonical order below without getting stuck?
bool assignable(int rem, int last, const std::vector<Candidate>& rest) {
    if (rem == 0 || rest.empty()) return true;
    const bool tanks = std::any_of(rest.begin(), rest.end(), [](const Candidate& c) { return c.tank; });
    for (std::size_t i = 0; i < rest.size(); ++i) {
        const Candidate& c = rest[i];
        if (tanks && !c.tank) continue;
        if (c.need > rem) return true;  // takes the rest, not lethal
        if (c.key > last) {
            std::vector<Candidate> after = rest;
            after.erase(after.begin() + static_cast<std::ptrdiff_t>(i));
            if (assignable(rem - c.need, c.key, after)) return true;
        }
    }
    return false;
}

// The units `p` may assign damage to next (467.2.c.3–4, 815). Every unit gets lethal damage in full before the next
// one, the last gets what's left. Only the set of lethal units and the one left short change the outcome, so picks
// of lethal units go in ascending assign_key order (one path per outcome), and only picks that never get stuck.
std::vector<Action> assign_options(const GameState& s, PlayerId p) {
    const Showdown& sd = *s.showdown;
    int last = -1;
    std::vector<ObjId> done;
    for (const Assigned& a : sd.assigned) {
        if (s.obj(a.unit).controller == p) continue;  // the other player's assignment
        done.push_back(a.unit);
        last = assign_key(s, a.unit);
    }
    std::vector<Candidate> rest;
    for (const ObjId id : combatants(s, side(sd, opponent(p)))) {
        if (std::find(done.begin(), done.end(), id) == done.end()) {
            rest.push_back({id, lethal_need(s, id), assign_key(s, id), has(s, id, Keyword::Tank)});
        }
    }
    const bool tanks = std::any_of(rest.begin(), rest.end(), [](const Candidate& c) { return c.tank; });
    std::vector<Action> out;
    for (std::size_t i = 0; i < rest.size(); ++i) {
        const Candidate& c = rest[i];
        if (tanks && !c.tank) continue;
        bool ok = c.need > sd.left;
        if (!ok && c.key > last) {
            std::vector<Candidate> after = rest;
            after.erase(after.begin() + static_cast<std::ptrdiff_t>(i));
            ok = assignable(sd.left - c.need, c.key, after);
        }
        if (ok) out.push_back({ActionKind::Pick, c.id});
    }
    std::sort(out.begin(), out.end(), [](const Action& a, const Action& b) { return a.obj < b.obj; });
    return out;
}

void assign_to(GameState& s, ObjId id) {
    Showdown& sd = *s.showdown;
    const int amount = std::min<int>(lethal_need(s, id), sd.left);
    sd.assigned.push_back({id, static_cast<std::int16_t>(amount)});
    sd.left = static_cast<std::int16_t>(sd.left - amount);
}

// ---- Movement (144) ----

// `id` can make a Standard Move to `where` for `p` (144.4): ready, base → battlefield, battlefield → base, and with
// Ganking battlefield → battlefield (810).
bool can_move(const GameState& s, PlayerId p, ObjId id, std::uint8_t where) {
    const Object& o = s.obj(id);
    if (o.card->type != CardType::Unit || !on_board(o.zone) || o.controller != p || o.exhausted) return false;
    if (o.zone == Zone::Base) return where != to_base;
    if (o.zone != Zone::Battlefield) return false;
    return where == to_base || (where != o.where && has(s, id, Keyword::Ganking));
}

std::vector<Action> movers(const GameState& s, PlayerId p, std::uint8_t where) {
    std::vector<Action> out;
    for (const ObjId id : s.active) {
        if (can_move(s, p, id, where)) out.push_back({ActionKind::Pick, id});
    }
    return out;
}

enum class CleanupKind : std::uint8_t {
    Normal,
    Ending,  // 317.2: + heal, "this turn" expiry, stuns, pools
    Combat,  // 468.1.a: + heal, recall the attackers if defenders remain
};

// A cleanup (323), in the rule's order, with the Ending and Combat Special Cleanups' steps (317.2, 468.1). Whatever
// changes re-arms cleanup_due (322; move_to does so for cards leaving the board), so the engine repeats cleanups
// until one changes nothing.
void cleanup(GameState& s, CleanupKind kind = CleanupKind::Normal) {
    s.cleanup_due = false;
    for (PlayerId p = 0; p < player_count; ++p) {  // 323.1
        const int points = s.player(p).points;
        if (points >= victory_score && points > s.player(opponent(p)).points) {  // 194.2
            s.winner = p;
            return;
        }
    }
    if (s.showdown && s.showdown->combat) {  // 323.2: designations follow who is at the combat's battlefield
        const Showdown& sd = *s.showdown;
        for (const ObjId id : s.active) {
            Object& o = s.obj(id);
            if (o.card->type != CardType::Unit || !on_board(o.zone)) continue;
            const bool here = o.zone == Zone::Battlefield && o.where == sd.where;
            const Designation want = here ? side(sd, o.controller) : Designation::None;
            if (o.designation != want) {
                o.designation = want;
                s.cleanup_due = true;
            }
        }
    }

    // 323.4 (3a): lethal damage kills (429.1.a.2), simultaneously; death triggers queue
    std::vector<ObjId> dead;
    for (const ObjId id : s.active) {
        const Object& o = s.obj(id);
        if (on_board(o.zone) && o.card->type == CardType::Unit && lethal_damage(s, id)) dead.push_back(id);
    }
    if (!dead.empty()) kill_all(s, dead, {});
    if (kind != CleanupKind::Normal) {
        for (Object& o : s.objects) {
            if (on_board(o.zone)) o.damage = 0;  // 317.2.b, 468.1.a.1 (3c): heal all units
        }
    }
    if (kind == CleanupKind::Ending) {
        expire(s, Duration::Turn);  // 317.2.c (3d)
        for (Object& o : s.objects) o.stunned = false;  // 424.1.a.2
        for (Player& pl : s.players) pl.scored = 0;
        empty_pools(s);  // 317.2.d (3e)
    }
    if (kind == CleanupKind::Combat) {  // 468.1.a.2 (3d): attackers go home if defenders held
        const auto attackers = combatants(s, Designation::Attacker);
        if (!combatants(s, Designation::Defender).empty()) {
            for (const ObjId id : attackers) recall(s, id);
        }
    }
    prune(s);  // effects and delayed abilities whose objects are gone

    // 323.5 (4): a controlled battlefield without its controller's units, in an open state without a showdown there
    if (!closed(s)) {
        for (std::size_t b = 0; b < s.battlefields.size(); ++b) {
            Battlefield& bf = s.battlefields[b];
            if (!bf.controller || showdown_at(s, b)) continue;
            const bool held = std::any_of(bf.here.begin(), bf.here.end(), [&](ObjId id) {
                return s.obj(id).controller == *bf.controller && s.obj(id).card->type == CardType::Unit;
            });
            if (!held) {
                bf.controller.reset();
                s.cleanup_due = true;  // 319.7
            }
        }
    }
    // 323.6 (5): recall gear and runes at battlefields, not attached gear (719.3). A card in another player's base
    // can't happen here: a base list is its controller's.
    for (std::size_t b = 0; b < s.battlefields.size(); ++b) {
        const std::vector<ObjId> here = s.battlefields[b].here;
        for (const ObjId id : here) {
            const Object& o = s.obj(id);
            if (o.card->type == CardType::Unit || o.attached != no_obj) continue;
            move_to(s, id, Zone::Base, o.controller);
            s.cleanup_due = true;  // 319.8
        }
        // 323.6.a: hidden cards at a battlefield their controller doesn't control
        const std::vector<ObjId> facedown = s.battlefields[b].facedown;
        for (const ObjId id : facedown) {
            if (s.battlefields[b].controller != s.obj(id).controller) move_to(s, id, Zone::Trash, s.obj(id).owner);
        }
    }
    // 323.10 (8): Contested ends without the contester's units and without a showdown there; 323.10.a: units at a
    // battlefield their controller doesn't control contest it (turn player first). Staging (323.7–323.9) follows
    // from Contested: showdown_staged, combat_staged.
    for (std::size_t i = 0; i < s.battlefields.size(); ++i) {
        const auto b = static_cast<std::uint8_t>(i);
        Battlefield& bf = s.battlefields[b];
        if (showdown_at(s, b)) continue;
        if (bf.contested && !has_units_at(s, b, *bf.contested)) {
            bf.contested.reset();
            s.cleanup_due = true;
        }
        for (int k = 0; k < player_count && !bf.contested; ++k) {
            const auto p = static_cast<PlayerId>((s.turn_player + k) % player_count);
            if (has_units_at(s, b, p)) contest(s, b, p);
        }
    }
    if (closed(s)) return;
    if (!s.showdown) {  // 323.11–323.12 (9–10): Neutral Open
        const auto where = stage_options(s);
        if (where.size() == 1) {
            begin(s, where.front(), combat_staged(s, where.front()));
        } else if (where.size() > 1 && (s.tasks.empty() || s.tasks.back().kind != TaskKind::Stage)) {
            s.tasks.push_back({TaskKind::Stage, s.turn_player});
        }
    } else if (!s.showdown->combat && s.showdown->window && combat_staged(s, s.showdown->where)) {
        begin(s, s.showdown->where, true);  // 323.13 (10a)
    }
}

void phase_start(GameState& s, Phase phase) {  // "at the start of …" (315.2.a, 316) and "at end of turn" (317.1.a)
    Event e = make_event(EventKind::PhaseStart, {}, s.turn_player);
    e.amount = static_cast<std::int16_t>(phase);
    emit(s, e);
}

void run_task(GameState& s, const Task& task) {
    const PlayerId p = task.player;
    switch (task.kind) {
        case TaskKind::Mulligan:  // 117
            s.decision = decide(DecisionKind::Mulligan, p);
            return;
        case TaskKind::Awaken:  // 315.1.b: ready every object p controls (416.3.a), the legend too (191.1)
            ++s.turn;
            s.uses.clear();  // "each turn" counts (386)
            s.deaths_this_turn = 0;
            enter_phase(s, Phase::Awaken);
            for (Object& o : s.objects) {
                const bool mine =
                    (on_board(o.zone) && o.controller == p) || (o.zone == Zone::LegendZone && o.owner == p);
                if (mine && o.card->type != CardType::Battlefield) o.exhausted = false;
            }
            return;
        case TaskKind::Beginning:  // 315.2.a
            enter_phase(s, Phase::Beginning);
            phase_start(s, Phase::Beginning);
            return;
        case TaskKind::Hold:  // 315.2.b: after the beginning step's triggers resolved
            for (std::size_t b = 0; b < s.battlefields.size(); ++b) {
                if (s.battlefields[b].controller == p) score(s, p, static_cast<std::uint8_t>(b), EventKind::Hold);
            }
            return;
        case TaskKind::Channel:  // 315.3, 487.7: the second player's first turn channels one more
            enter_phase(s, Phase::Channel);
            channel(s, p, channel_per_turn + (s.turn == 2 ? 1 : 0));
            return;
        case TaskKind::Draw:  // 315.4, Burn Out inside
            enter_phase(s, Phase::Draw);
            draw(s, p, 1);
            return;
        case TaskKind::Main:  // 316.3. Priority follows from 335 in run()
            enter_phase(s, Phase::Main);
            empty_pools(s);
            phase_start(s, Phase::Main);
            return;
        case TaskKind::Ending:  // 317.1: ending step effects
            enter_phase(s, Phase::Ending);
            phase_start(s, Phase::Ending);
            s.tasks.push_back({TaskKind::Expiration, p});
            return;
        case TaskKind::Expiration:  // 317.2
            cleanup(s, CleanupKind::Ending);
            if (s.winner) return;
            if (!s.triggered.empty() || !s.chain.empty()) {  // 317.2.f: after the chain, start the step over
                s.tasks.push_back({TaskKind::Expiration, p});
                return;
            }
            s.turn_player = opponent(p);  // 317.3
            start_turn(s);
            return;
        case TaskKind::StandardMove: {  // 144
            std::vector<Action> picks;
            if (s.answer) {
                picks = take_answer(s);
            } else {
                picks = movers(s, p, task.where);
                int n = static_cast<int>(picks.size());  // as many as p can pay the move tax for
                while (n > 1 && !can_pay(s, p, move_tax(s, p, task.where, n))) --n;
                if (picks.size() > 1) {
                    ask(s, p, Purpose::Move, std::move(picks), 1, n);
                    s.tasks.push_back(task);
                    return;
                }
            }
            std::vector<ObjId> ids;
            for (const Action& a : picks) {
                ids.push_back(a.obj);
                exhaust(s, a.obj);  // 144.2, paid simultaneously (144.3.c)
            }
            if (const Cost tax = move_tax(s, p, task.where, static_cast<int>(ids.size())); tax != Cost{}) {
                // the engine picks the runes to recycle (pay.hpp's order; Dev's ruling): no Recycle decision outside the chain
                std::vector<ObjId> recycled;
                for (auto options = recycle_options(s, p, tax, recycled); !options.empty();
                     options = recycle_options(s, p, tax, recycled)) {
                    recycled.push_back(options.front());
                }
                pay(s, p, tax, recycled);
            }
            move(s, ids, task.where, {{}, p});
            return;
        }
        case TaskKind::Stage: {  // 323.11–323.12, if still Neutral Open
            if (closed(s) || s.showdown) return;
            std::uint8_t b = 0;
            if (s.answer) {
                b = take_answer(s).front().n;
            } else {
                const auto where = stage_options(s);
                if (where.empty()) return;
                if (where.size() > 1) {
                    ask(s, p, Purpose::Stage, battlefield_options(s, where), 1, 1);
                    s.tasks.push_back(task);
                    return;
                }
                b = where.front();
            }
            begin(s, b, combat_staged(s, b));
            return;
        }
        case TaskKind::ShowdownEnd: {  // 348.2.a: the only player here establishes control (190.3.b: Contested ends)
            const std::uint8_t b = s.showdown->where;
            s.showdown.reset();
            s.cleanup_due = true;
            const auto here = present(s, b);
            if (here.size() == 1) establish_control(s, b, here.front(), 0);
            if (here.empty()) s.battlefields[b].contested.reset();
            return;
        }
        case TaskKind::CombatDamage: {  // 467
            Showdown& sd = *s.showdown;
            const bool fight = !combatants(s, Designation::Attacker).empty() &&
                               !combatants(s, Designation::Defender).empty();
            while (fight && sd.assigners < player_count) {  // 467.2.c: the attacker first
                const PlayerId by = sd.assigners == 0 ? sd.attacker : opponent(sd.attacker);
                if (sd.left < 0) sd.left = static_cast<std::int16_t>(combat_damage(s, by));
                if (s.answer) assign_to(s, take_answer(s).front().obj);
                while (sd.left > 0) {
                    auto options = assign_options(s, by);
                    if (options.empty()) {  // everyone has lethal damage: the rest is excess (467.2.c.4)
                        sd.excess[by] = sd.left;
                        break;
                    }
                    if (options.size() > 1) {
                        ask(s, by, Purpose::Assign, std::move(options), 1, 1);
                        s.tasks.push_back(task);
                        return;
                    }
                    assign_to(s, options.front().obj);
                }
                ++sd.assigners;
                sd.left = -1;
            }
            const std::vector<Assigned> assigned = sd.assigned;
            for (const Assigned& a : assigned) {  // 467.2.d: dealt simultaneously
                deal(s, a.unit, a.amount, {{}, opponent(s.obj(a.unit).controller)});
            }
            cleanup(s, CleanupKind::Combat);  // 467.3, 468.1: no FEPR in between
            return;
        }
        case TaskKind::CombatResult: {  // 468.3–468.5
            Showdown& sd = *s.showdown;
            // both still here: "No Result", Contested stays, so a showdown and combat are staged again once this
            // one ends (468.3.d.1)
            const auto here = present(s, sd.where);
            if (here.size() == 1) establish_control(s, sd.where, here.front(), sd.excess[here.front()]);
            if (here.empty()) {  // 468.5.b
                s.battlefields[sd.where].controller.reset();
                s.battlefields[sd.where].contested.reset();
                s.cleanup_due = true;
            }
            return;
        }
        case TaskKind::CombatEnd:  // 468.7
            for (Object& o : s.objects) o.designation = Designation::None;
            expire(s, Duration::Combat);
            s.showdown.reset();
            s.cleanup_due = true;
            return;
    }
}

std::size_t pending_index(const GameState& s) {
    const auto it = std::find_if(s.chain.begin(), s.chain.end(), [](const ChainItem& c) { return !c.finalized; });
    return static_cast<std::size_t>(it - s.chain.begin());
}

std::size_t resolving_index(const GameState& s) {
    const auto it = std::find_if(s.chain.begin(), s.chain.end(), [](const ChainItem& c) { return c.resolving; });
    return static_cast<std::size_t>(it - s.chain.begin());
}

// Takes item i off the chain without it ever being finalized (383.3.a.2, 403.4, 405.2): not countered.
void remove_item(GameState& s, std::size_t i) {
    s.chain.erase(s.chain.begin() + static_cast<std::ptrdiff_t>(i));
    s.cleanup_due = true;
}

// Finalize steps of a pending item (355–359, 402–406), in ChainItem::step: 355's order, optional costs (355.1.a)
// before the location (355.2) and targets (355.5).
enum FinStep : std::uint8_t {
    FinMay, FinOptional, FinLocation, FinTargets, FinCost, FinDiscard, FinRecycleTrash, FinRunes
};

// 355.2: where a unit may enter: the base and battlefields its controller controls, plus with Ambush battlefields
// where they have units (822.1.b); played only by Ambush's permission, just those (822.1.b: the Reaction is tied
// to them).
std::vector<Action> locations(const GameState& s, const ChainItem& item) {
    const PlayerId p = item.controller;
    const bool ambush = has(s, item.card, Keyword::Ambush);
    const bool only_ambush = (item.play & played::ambush) != 0;
    std::vector<std::uint8_t> where;
    for (std::size_t i = 0; i < s.battlefields.size(); ++i) {
        const auto b = static_cast<std::uint8_t>(i);
        const bool normal = !only_ambush && s.battlefields[b].controller == p;
        if (normal || (ambush && has_units_at(s, b, p))) where.push_back(b);
    }
    auto options = battlefield_options(s, where);
    if (!only_ambush) options.push_back({ActionKind::Pick, no_obj, to_base});
    return options;
}

// 359: finished. Targeting effects trigger, permanents enter the board, spells and abilities wait for the passes.
void finished(GameState& s, std::size_t i) {
    ChainItem& item = s.chain[i];
    item.finalized = true;  // 359.1
    item.step = 0;
    item.sub = 0;
    s.cleanup_due = true;   // 319.4
    s.passes = 0;
    const ChainItem done = item;
    emit_targeted(s, done);  // 383.4.b
    if (done.kind != ItemKind::Card) {
        const AbilitySpec* spec = ability_of(s, done);
        if (done.kind == ItemKind::Activated && spec && spec->per_turn > 0) use(s, done.source, done.ability);
        if (spec && spec->add) s.chain[i].resolving = true;  // 401.2: resolves at once
        return;
    }
    const Object& card = s.obj(done.card);
    const Event played = make_event(EventKind::Played, done.source, done.controller);
    if (card.card->type == CardType::Spell) {  // 359.3: waits on the chain
        emit(s, played);
        return;
    }
    // 337.2, 359.2: a permanent resolves at once, a unit at its chosen location (355.2), gear in the base. Units
    // enter exhausted unless they enter ready (369.3), gear ready.
    const bool unit = card.card->type == CardType::Unit;
    s.chain.erase(s.chain.begin() + static_cast<std::ptrdiff_t>(i));
    if (unit && done.to != to_base) {
        move_to(s, done.card, Zone::Battlefield, done.controller, done.to);
    } else {
        move_to(s, done.card, Zone::Base, done.controller);
    }
    const CardRules* rules = rules_of(s, done.card);
    const bool ready = rules != nullptr && (rules->enters_ready(s, done.card, done) || accelerated(s, done));
    s.obj(done.card).exhausted = unit ? !ready : (done.play & played::exhausted) != 0;  // 184.1
    Event e = make_event(EventKind::Played, s.obj(done.card).ref(done.card), done.controller);
    e.place = place_of(s, done.card);
    e.amount = done.paid;  // "if you paid the additional cost" (Zed, From the Shadows; Gust Monk)
    emit(s, e);
    if (unit && done.to != to_base) contest(s, done.to, done.controller);  // 190.3.a.1
}

// 337.1, 355–359 for the pending item at `i`: "may", targets, optional costs, total cost, non-standard costs,
// runes, then finished. Stops at each decision; the answer (GameState::answer, or a Recycle pick) calls it again.
void finalize(GameState& s, std::size_t i) {
    for (;;) {
        ChainItem& item = s.chain[i];
        const PlayerId p = item.controller;
        switch (item.step) {
            case FinMay: {  // 383.3.a, 403.1
                const AbilitySpec* spec = ability_of(s, item);
                if (item.kind == ItemKind::Triggered && spec && spec->may) {
                    if (!s.answer) {
                        ask(s, p, Purpose::May, {{ActionKind::Pick, item.source.id}}, 0, 1);
                        return;
                    }
                    if (take_answer(s).empty()) {
                        if (spec->per_turn > 0) use(s, item.source, item.ability, -1);  // 386.2.b: not performed
                        remove_item(s, i);
                        return;
                    }
                }
                item.step = FinOptional;
                item.sub = 0;
                continue;
            }
            case FinOptional: {  // 355.1.a: only ones the play can still be completed and paid with (355.16)
                const auto optional = optional_costs(s, item);
                if (item.sub >= optional.size()) {
                    item.step = FinLocation;
                    item.sub = 0;
                    continue;
                }
                if (s.answer) {
                    if (!take_answer(s).empty()) item.paid = static_cast<std::uint8_t>(item.paid | (1u << item.sub));
                    ++item.sub;
                    continue;
                }
                ChainItem with = item;
                with.paid = static_cast<std::uint8_t>(with.paid | (1u << item.sub));
                if (!completable(s, with)) {
                    ++item.sub;
                    continue;
                }
                ask(s, p, Purpose::OptionalCost, {{ActionKind::Pick, item.card, item.sub}}, 0, 1);
                return;
            }
            case FinLocation: {  // 355.2
                const bool unit = item.kind == ItemKind::Card && s.obj(item.card).card->type == CardType::Unit;
                if (unit && s.answer) {
                    item.to = take_answer(s).front().n;
                } else if (unit && !(item.play & played::to_base)) {
                    auto options = locations(s, item);
                    if (options.size() > 1) {
                        ask(s, p, Purpose::Location, std::move(options), 1, 1);
                        return;
                    }
                    item.to = options.front().n;
                }
                item.step = FinTargets;
                item.sub = 0;
                continue;
            }
            case FinTargets: {  // 355.5–355.13, 403.2; only picks the play can still be completed and paid with
                if (item.sub >= target_slots(s, item)) {
                    item.step = FinCost;
                    continue;
                }
                if (s.answer) {
                    for (const Action& a : take_answer(s)) {
                        Target t{{}, a.n, item.sub};
                        if (a.obj != no_obj) t = {s.obj(a.obj).ref(a.obj), 0, item.sub};
                        item.targets.push_back(t);
                    }
                    ++item.sub;
                    continue;
                }
                const TargetSpec& spec = target_spec(s, item, item.sub);
                std::vector<Action> options;
                for (const Action& a : candidates(s, item, item.sub)) {
                    ChainItem with = item;
                    with.targets.push_back(a.obj == no_obj ? Target{{}, a.n, item.sub}
                                                           : Target{s.obj(a.obj).ref(a.obj), 0, item.sub});
                    if (completable(s, with, item.sub + 1u)) options.push_back(a);
                }
                if (options.size() < spec.min) {
                    // 403.4: a trigger without legal choices leaves; a play or activation was offered only with them
                    if (item.kind != ItemKind::Triggered) throw std::logic_error("finalize: no legal targets");
                    remove_item(s, i);
                    return;
                }
                const int max = std::min<int>(spec.max, static_cast<int>(options.size()));
                if (max == 0 || static_cast<int>(options.size()) == spec.min) {  // nothing to decide
                    s.answer = max == 0 ? std::vector<Action>{} : options;
                    continue;
                }
                ask(s, p, Purpose::Target, std::move(options), spec.min, max);
                return;
            }
            case FinCost:  // 356, 404
                item.cost = total_cost(s, item);
                if (!payable(s, item, item.cost)) {
                    if (item.kind != ItemKind::Triggered) throw std::logic_error("finalize: cost not payable");
                    remove_item(s, i);  // 405.2: a trigger whose cost can't be paid
                    return;
                }
                item.step = FinDiscard;
                continue;
            case FinDiscard:
            case FinRecycleTrash: {  // 357.2: costs with a choice of cards
                const bool disc = item.step == FinDiscard;
                const int n = disc ? item.cost.discard : item.cost.recycle_trash;
                const FinStep next = disc ? FinRecycleTrash : FinRunes;
                if (n == 0) {
                    item.step = next;
                    continue;
                }
                std::vector<ObjId> cards;
                if (s.answer) {
                    for (const Action& a : take_answer(s)) cards.push_back(a.obj);
                } else {
                    std::vector<Action> options;
                    for (const ObjId id : disc ? s.player(p).hand : s.player(p).trash) {
                        const bool spell_only = disc && item.cost.discard_spell;
                        if (id != item.card && (!spell_only || s.obj(id).card->type == CardType::Spell)) {
                            options.push_back({ActionKind::Pick, id});
                        }
                    }
                    std::sort(options.begin(), options.end(), [](const Action& a, const Action& b) { return a.obj < b.obj; });
                    if (static_cast<int>(options.size()) > n) {
                        ask(s, p, disc ? Purpose::Discard : Purpose::RecycleTrash, std::move(options), n, n);
                        return;
                    }
                    for (const Action& a : options) cards.push_back(a.obj);
                }
                const ObjRef by = item.source;  // the item may move in memory: events can't touch the chain
                if (disc) {
                    for (const ObjId id : cards) discard(s, id, {by, p});
                } else {
                    recycle(s, cards);
                }
                s.chain[i].step = next;
                continue;
            }
            case FinRunes: {  // 357, 405
                const Cost cost = item.cost;
                if (s.decision.kind != DecisionKind::Recycle) s.decision = decide(DecisionKind::Recycle, p);
                auto& picked = s.decision.picked;
                for (;;) {
                    const auto options = recycle_options(s, p, cost, picked);
                    if (options.empty()) break;
                    if (options.size() > 1) return;
                    picked.push_back(options.front());
                }
                const std::vector<ObjId> recycled = picked;
                s.decision = {};
                pay(s, p, cost, recycled);
                const ObjRef src = item.source;
                if (cost.exhaust_self) exhaust(s, src.id);
                if (cost.disempower_self) disempower(s, src.id);
                if (cost.burn > 0) burn(s, p, cost.burn);  // 441.3.a
                if (cost.banish_self && s.alive(src)) banish(s, src.id, {src, p});
                if (cost.kill_self) kill(s, src.id, {src, p});  // paid even if replaced (357.2.a)
                // 358: legal_actions only offers legal plays, so the check holds and nothing is ever undone (358.5)
                finished(s, i);
                return;
            }
        }
    }
}

// 340.1: the newest item starts resolving.
void start_resolving(GameState& s) {
    s.chain.back().resolving = true;
    s.chain.back().step = 0;
    s.passes = 0;
}

// 359.3.d, 402–406: one step of the resolving item's effect. Done → once more per paid Repeat (820.1.d), then it
// leaves the chain (a spell to its owner's trash, banished if played for Flow: 829.1.b.1), unless the effect already
// took it off (359.3.e.15). A spell with nothing it can do still resolves (055.1).
void resolve_step(GameState& s) {
    const ChainItem& item = s.chain[resolving_index(s)];
    const CardRules* rules = rules_of(s, item);
    Resolution r(s);
    Status status = Status::Done;
    if (builtin(s, item)) {
        status = resolve_builtin(r);
    } else if (rules != nullptr) {
        status = rules->resolve(r);
    }
    if (status == Status::Wait) {
        if (s.decision.kind == DecisionKind::None) throw std::logic_error("resolve: waits without a decision");
        return;
    }
    if (s.answer) throw std::logic_error("resolve: answer left over");
    const std::size_t i = resolving_index(s);
    if (i < s.chain.size() && s.chain[i].rep < repeats(s, s.chain[i])) {
        ++s.chain[i].rep;
        s.chain[i].step = 0;
        return;
    }
    s.cleanup_due = true;  // 319.5
    s.passes = 0;          // 340.4: the newest item's controller next
    if (i == s.chain.size()) return;
    const ChainItem done = s.chain[i];
    s.chain.erase(s.chain.begin() + static_cast<std::ptrdiff_t>(i));
    if (done.card != no_obj && s.obj(done.card).zone == Zone::Chain) {
        if (done.play & played::flow) {
            banish(s, done.card, {done.source, done.controller});
        } else {
            move_to(s, done.card, Zone::Trash, s.obj(done.card).owner);
        }
    }
    if (done.kind == ItemKind::Activated) {  // 377.2.a
        Event e = make_event(EventKind::Activated, done.source, done.controller);
        e.amount = done.ability;
        emit(s, e);
    }
}

// 383.3, 383.3.d: queued triggers onto the chain as pending items, the turn player's first (they resolve last),
// each player ordering their own: one decision per placement while they have more than one.
void place_triggers(GameState& s) {
    for (int k = 0; k < player_count && !s.triggered.empty(); ++k) {
        const auto p = static_cast<PlayerId>((s.turn_player + k) % player_count);
        for (;;) {
            std::vector<std::size_t> mine;
            for (std::size_t i = 0; i < s.triggered.size(); ++i) {
                if (s.triggered[i].controller == p) mine.push_back(i);
            }
            if (mine.empty()) break;
            std::size_t next = mine.front();
            if (s.answer) {
                next = take_answer(s).front().n;
            } else if (mine.size() > 1) {
                std::vector<Action> options;
                for (const std::size_t i : mine) {
                    options.push_back({ActionKind::Pick, s.triggered[i].source.id, static_cast<std::uint8_t>(i)});
                }
                ask(s, p, Purpose::TriggerOrder, std::move(options), 1, 1);
                return;
            }
            const Trigger t = s.triggered.at(next);
            s.triggered.erase(s.triggered.begin() + static_cast<std::ptrdiff_t>(next));
            ChainItem item;
            item.source = t.source;
            item.controller = t.controller;
            item.kind = ItemKind::Triggered;
            item.ability = t.ability;
            item.event = t.event;
            s.chain.push_back(item);
            s.cleanup_due = true;  // 319.3
            s.passes = 0;
        }
    }
}

// HOT FEPR (334): a due cleanup first (319; never inside a resolution, 321), then the resolving item's next step,
// Finalize the oldest pending item, put queued triggers on the chain (402.2: after a resolution), Execute
// (priority), Pass, Resolve; then tasks; with no chain, the turn player's main-phase priority (335). Stops at a
// decision, the game's end or when nothing is left.
void run(GameState& s) {
    while (!s.winner) {
        const bool resolving = resolving_index(s) < s.chain.size();
        if (s.cleanup_due && !resolving) {
            cleanup(s);
            continue;
        }
        if (s.decision.kind != DecisionKind::None) break;
        if (resolving) {
            resolve_step(s);
            continue;
        }
        if (const auto i = pending_index(s); i < s.chain.size()) {
            finalize(s, i);
            continue;
        }
        if (!s.triggered.empty()) {
            place_triggers(s);
            continue;
        }
        if (!s.chain.empty()) {
            if (s.passes >= player_count) {  // 339.1
                start_resolving(s);
                continue;
            }
            s.decision = decide(DecisionKind::Priority, chain_priority(s));  // 337.4, 339.2, 340.4
            break;
        }
        if (s.showdown && s.showdown->window) {  // 346, 347: the player with focus
            Showdown& sd = *s.showdown;
            if (sd.pass_focus) {
                sd.pass_focus = false;
                sd.focus = opponent(sd.focus);
            }
            s.decision = decide(DecisionKind::Priority, sd.focus);
            break;
        }
        if (!s.tasks.empty()) {
            const Task task = s.tasks.back();
            s.tasks.pop_back();
            run_task(s, task);
            continue;
        }
        if (s.phase == Phase::Main && !s.showdown) s.decision = decide(DecisionKind::Priority, s.turn_player);
        break;
    }
    if (s.winner) {
        s.decision = {};
        s.tasks.clear();
    }
}

bool timing_allows(const GameState& s, Timing timing);

// 354: a card from hand (or the trash, for its Flow cost) to the chain as a pending item; run() finalizes it.
void play(GameState& s, ObjId id) {
    const PlayerId p = s.decision.player;
    s.decision = {};
    note_play(s, false);
    ChainItem item;
    item.card = id;
    item.controller = p;
    if (s.obj(id).zone == Zone::Trash) item.play |= played::flow;
    if (!timing_allows(s, s.obj(id).card->timing)) item.play |= played::ambush;
    move_to(s, id, Zone::Chain, p);
    item.source = s.obj(id).ref(id);
    s.chain.push_back(item);
    s.cleanup_due = true;  // 319.3
    s.passes = 0;          // 339.1: an item was added
}

// 377.3, 402.1: an activated ability onto the chain as a pending item.
void activate(GameState& s, ObjId source, std::uint8_t ability) {
    const PlayerId p = s.decision.player;
    s.decision = {};
    note_play(s, rules_of(s, source)->abilities()[ability].add);
    ChainItem item;
    item.source = s.obj(source).ref(source);
    item.controller = p;
    item.kind = ItemKind::Activated;
    item.ability = ability;
    s.chain.push_back(item);
    s.cleanup_due = true;
    s.passes = 0;
}

// 308.1.a, 309.1.a, 310.1.a: what the turn's state lets a card or ability be used with. Neutral Open only reaches
// here with the turn player's main-phase priority (381.1 for activated abilities).
bool timing_allows(const GameState& s, Timing timing) {
    switch (turn_state(s)) {
        case TurnState::NeutralOpen: return true;
        case TurnState::ShowdownOpen: return timing != Timing::Normal;
        case TurnState::NeutralClosed:
        case TurnState::ShowdownClosed: return timing == Timing::Reaction;
    }
    return false;
}

// 376–381: `p` may activate ability `a` of `source` now.
bool activatable(const GameState& s, PlayerId p, ObjId source, std::uint8_t a) {
    const CardRules* rules = rules_of(s, source);
    const AbilitySpec& spec = rules->abilities()[a];
    if (spec.kind != AbilityKind::Activated || controller_of(s, source) != p) return false;
    if (!timing_allows(s, spec.timing)) return false;
    if (spec.usable != nullptr && !spec.usable(s, source)) return false;  // 377.2.b
    if (spec.builtin == Builtin::Empower && s.obj(source).empowered) return false;  // 827.1.c.1
    const ObjRef ref = s.obj(source).ref(source);
    if (spec.per_turn > 0 && uses(s, ref, a) >= spec.per_turn) return false;
    ChainItem item;
    item.source = ref;
    item.controller = p;
    item.kind = ItemKind::Activated;
    item.ability = a;
    return completable(s, item);
}

std::size_t hand_index(const GameState& s, PlayerId p, ObjId id) {
    const auto& hand = s.player(p).hand;
    return static_cast<std::size_t>(std::find(hand.begin(), hand.end(), id) - hand.begin());
}

// 117: set aside, draw as many, recycle the set-aside cards.
void finish_mulligan(GameState& s) {
    const Decision d = s.decision;
    s.decision = {};
    for (const ObjId id : d.picked) move_to(s, id, Zone::Removed, d.player);  // set aside: in no zone for a moment
    draw(s, d.player, static_cast<int>(d.picked.size()));
    recycle(s, d.picked);
}

// Choose: picks in option order, and only ones after which `min` stays reachable, so each set has one path.
std::vector<Action> choose_options(const Decision& d) {
    std::vector<Action> out;
    if (d.chosen.size() < d.max) {
        const std::size_t from = d.chosen.empty() ? 0 : d.chosen.back() + 1u;
        const std::size_t still = d.min > d.chosen.size() ? d.min - d.chosen.size() : 0;
        for (std::size_t i = from; i < d.options.size(); ++i) {
            if (d.options.size() - i - 1 + 1 >= still) out.push_back(d.options[i]);
        }
    }
    if (d.chosen.size() >= d.min) out.push_back({ActionKind::Done});
    return out;
}

} // namespace

bool is_implemented(const Card& card) { return is_basic_rune(card) || card.rules != nullptr; }

GameState new_game(const Deck& seat0, const Deck& seat1, const GameOptions& options) {
    if (!options.vanilla) check_implemented(seat0, seat1);
    GameState s;
    s.rng = Rng(options.seed);
    s.vanilla = options.vanilla;
    setup_player(s, 0, seat0);
    setup_player(s, 1, seat1);
    s.first_player = static_cast<PlayerId>(s.rng.below(player_count));  // 115
    s.turn_player = s.first_player;
    const PlayerId second = opponent(s.first_player);
    draw(s, s.first_player, opening_hand);  // 116
    draw(s, second, opening_hand);
    start_turn(s);  // after the mulligans: the stack runs back first
    push_tasks(s, {{TaskKind::Mulligan, s.first_player}, {TaskKind::Mulligan, second}});
    run(s);
    return s;
}

std::vector<Action> legal_actions(const GameState& s) {
    std::vector<Action> actions;
    const Decision& d = s.decision;
    switch (d.kind) {
        case DecisionKind::None: break;
        case DecisionKind::Mulligan: {
            if (d.picked.size() < max_mulligan) {
                const auto& hand = s.player(d.player).hand;
                const std::size_t from = d.picked.empty() ? 0 : hand_index(s, d.player, d.picked.back()) + 1;
                for (std::size_t i = from; i < hand.size(); ++i) actions.push_back({ActionKind::Pick, hand[i]});
            }
            actions.push_back({ActionKind::Done});
            break;
        }
        case DecisionKind::Priority:
            for (const ObjId id : s.player(d.player).hand) {
                if (playable(s, d.player, id)) actions.push_back({ActionKind::Play, id});
            }
            for (const ObjId id : s.player(d.player).trash) {  // 829: Flow
                if (playable(s, d.player, id)) actions.push_back({ActionKind::Play, id});
            }
            for (const ObjId id : s.active) {  // 380: on the board, and legends; not attached (721.2)
                const CardRules* rules = active_rules(s, id);
                if (rules == nullptr) continue;
                for (std::size_t a = 0; a < rules->abilities().size(); ++a) {
                    const auto ab = static_cast<std::uint8_t>(a);
                    if (activatable(s, d.player, id, ab)) actions.push_back({ActionKind::Activate, id, ab});
                }
            }
            if (turn_state(s) == TurnState::NeutralOpen && s.phase == Phase::Main) {  // 144.1
                for (std::size_t b = 0; b <= s.battlefields.size(); ++b) {
                    const bool base = b == s.battlefields.size();
                    const auto where = base ? to_base : static_cast<std::uint8_t>(b);
                    if (!movers(s, d.player, where).empty()) {
                        actions.push_back({ActionKind::Move, base ? no_obj : s.battlefields[b].card, where});
                    }
                }
            }
            actions.push_back({closed(s) || s.showdown ? ActionKind::Pass : ActionKind::EndTurn});
            break;
        case DecisionKind::Recycle: {
            const Cost& cost = s.chain.at(pending_index(s)).cost;
            for (const ObjId id : recycle_options(s, d.player, cost, d.picked)) {
                actions.push_back({ActionKind::Pick, id});
            }
            break;
        }
        case DecisionKind::Choose:
            actions = choose_options(d);
            break;
    }
    return actions;
}

namespace {

// Whether legal_actions(s) contains `a`, without building the list: Priority asks only about `a` (playable,
// activatable and movers are the expensive part of legal_actions).
bool is_legal(const GameState& s, const Action& a) {
    const Decision& d = s.decision;
    if (d.kind != DecisionKind::Priority) {
        const auto legal = legal_actions(s);
        return std::find(legal.begin(), legal.end(), a) != legal.end();
    }
    const auto contains = [](const std::vector<ObjId>& ids, ObjId id) {
        return std::find(ids.begin(), ids.end(), id) != ids.end();
    };
    switch (a.kind) {
        case ActionKind::Play:
            return a.n == 0 && (contains(s.player(d.player).hand, a.obj) || contains(s.player(d.player).trash, a.obj)) &&
                   playable(s, d.player, a.obj);
        case ActionKind::Activate: {
            if (a.obj >= s.objects.size()) return false;
            const CardRules* rules = active_rules(s, a.obj);
            return rules != nullptr && a.n < rules->abilities().size() && activatable(s, d.player, a.obj, a.n);
        }
        case ActionKind::Move: {
            if (turn_state(s) != TurnState::NeutralOpen || s.phase != Phase::Main) return false;
            const bool base = a.n == to_base;
            if (!base && a.n >= s.battlefields.size()) return false;
            return a.obj == (base ? no_obj : s.battlefields[a.n].card) && !movers(s, d.player, a.n).empty();
        }
        case ActionKind::Pass:
        case ActionKind::EndTurn:
            return a.obj == no_obj && a.n == 0 &&
                   a.kind == (closed(s) || s.showdown ? ActionKind::Pass : ActionKind::EndTurn);
        default: return false;
    }
}

} // namespace

void apply(GameState& s, const Action& action) {
    if (!is_legal(s, action)) {
        throw IllegalAction("not legal now (" + std::string(to_string(s.decision.kind)) + "): " +
                            describe(s, action));
    }
    switch (s.decision.kind) {
        case DecisionKind::None: break;
        case DecisionKind::Mulligan:
            if (action.kind == ActionKind::Pick) {
                s.decision.picked.push_back(action.obj);
                return;
            }
            finish_mulligan(s);
            break;
        case DecisionKind::Priority:
            if (action.kind == ActionKind::Play) {
                play(s, action.obj);
            } else if (action.kind == ActionKind::Activate) {
                activate(s, action.obj, action.n);
            } else if (action.kind == ActionKind::Move) {
                s.tasks.push_back({TaskKind::StandardMove, s.decision.player, action.n});
                s.decision = {};
            } else if (action.kind == ActionKind::Pass) {
                s.decision = {};
                if (closed(s)) {
                    ++s.passes;  // 338.1.b
                } else {
                    pass_focus(s);
                }
            } else {
                s.decision = {};
                s.tasks.push_back({TaskKind::Ending, s.turn_player});  // 316.9
            }
            break;
        case DecisionKind::Recycle:
            s.decision.picked.push_back(action.obj);
            finalize(s, pending_index(s));
            break;
        case DecisionKind::Choose: {
            Decision& d = s.decision;
            if (action.kind == ActionKind::Pick) {
                const auto it = std::find(d.options.begin(), d.options.end(), action);
                d.chosen.push_back(static_cast<std::uint8_t>(it - d.options.begin()));
                if (d.chosen.size() < d.max) return;  // more to pick
            }
            std::vector<Action> picks;
            for (const std::uint8_t i : d.chosen) picks.push_back(d.options[i]);
            s.answer = std::move(picks);
            s.decision = {};
            break;
        }
    }
    run(s);
}

void concede(GameState& s, PlayerId p) {
    if (s.winner) return;
    s.winner = opponent(p);  // 651.1
    s.decision = {};
    s.tasks.clear();
}

bool playable(const GameState& s, PlayerId p, ObjId id) {
    const Object& o = s.obj(id);
    const Card& card = *o.card;
    const bool kind = card.type == CardType::Unit || card.type == CardType::Gear || card.type == CardType::Spell;
    if (!kind || o.owner != p) return false;
    const CardRules* rules = rules_of(s, id);
    ChainItem item;  // as it would be on the chain, no optional costs yet
    item.card = id;
    item.source = o.ref(id);
    item.controller = p;
    if (o.zone == Zone::Trash) {  // 829.1.b
        if (rules == nullptr || !rules->flow_cost()) return false;
        item.play |= played::flow;
    } else if (o.zone != Zone::Hand) {
        return false;
    }
    if (!timing_allows(s, card.timing)) {  // 822.1.b: Ambush is a Reaction to a battlefield where p has units
        if (card.type != CardType::Unit || !has(s, id, Keyword::Ambush) || !timing_allows(s, Timing::Reaction)) {
            return false;
        }
        item.play |= played::ambush;
        if (locations(s, item).empty()) return false;
    }
    if (rules != nullptr && !rules->can_play(s, id, p)) return false;
    return completable(s, item);
}

std::string describe(const GameState& s, const Action& action) {
    const std::string name = action.obj < s.objects.size() ? s.obj(action.obj).card->name : "?";
    switch (action.kind) {
        case ActionKind::Pick:
            if (s.decision.kind == DecisionKind::Mulligan) return "set aside " + name;
            if (s.decision.kind == DecisionKind::Recycle) return "recycle " + name;
            if (s.decision.purpose == Purpose::Location) return action.obj == no_obj ? "to base" : "to " + name;
            if (action.obj == no_obj) {
                return action.n == to_base ? "to base" : "pick player " + std::to_string(action.n);
            }
            switch (s.decision.purpose) {
                case Purpose::May: return "use " + name + "'s ability";
                case Purpose::OptionalCost: return "pay " + name + "'s optional cost " + std::to_string(action.n);
                case Purpose::Discard: return "discard " + name;
                case Purpose::RecycleTrash: return "recycle " + name;
                case Purpose::TriggerOrder: return "next on the chain: " + name + "'s ability";
                case Purpose::Target: return "choose " + name;
                case Purpose::Move: return "move " + name;
                case Purpose::Stage: return "begin at " + name;
                case Purpose::Assign: return "assign damage to " + name;
                default: return "pick " + name;
            }
        case ActionKind::Play: return "play " + name;
        case ActionKind::Activate: return "use " + name + "'s ability " + std::to_string(action.n);
        case ActionKind::Move: return "move to " + (action.n == to_base ? std::string("base") : name);
        case ActionKind::EndTurn: return "end turn";
        case ActionKind::Pass: return "pass";
        case ActionKind::Done:
            if (s.decision.kind == DecisionKind::Mulligan && s.decision.picked.empty()) return "keep";
            if (s.decision.kind == DecisionKind::Choose && s.decision.chosen.empty() &&
                (s.decision.purpose == Purpose::May || s.decision.purpose == Purpose::OptionalCost)) {
                return "decline";
            }
            return "done";
    }
    return "?";
}

} // namespace buddy::riftbound
