noahbachmann/buddy/skeleton/services/spotify/player.cpp

#include "player.hpp"

#include "buddy/names.hpp"

#include <algorithm>
#include <cctype>
#include <cstdint>
#include <cstdio>
#include <cstdlib>
#include <fstream>
#include <iostream>
#include <random>
#include <sstream>
#include <utility>
#include <vector>

namespace buddy::spotify {

namespace {

using json = nlohmann::json;
using names::lower;
using names::match_score;
using names::squash;

const char* kApi = "https://api.spotify.com/v1";

// squash() without a leading "the"/"some": "some strokes" and "The Strokes" are the same artist
std::string core_name(const std::string& s) {
    const std::string l = lower(s);
    for (const char* lead : {"the ", "some "})
        if (l.starts_with(lead)) return squash(l.substr(std::string(lead).size()));
    return squash(l);
}

std::string error_reason(const HttpResponse& r) {
    const auto j = json::parse(r.body, nullptr, /*allow_exceptions=*/false);
    if (j.is_discarded() || !j.contains("error") || !j["error"].is_object()) return r.body;
    return j["error"].value("reason", j["error"].value("message", r.body));
}

// Among the first non-null items of list `type`, the first whose name equals `name` (ignoring case,
// punctuation and a leading "the"/"some"), else the first one, else null. Spotify's top hit is often a related song or artist.
json best_item(const json& results, const char* type, const std::string& name) {
    if (!results.contains(type) || !results[type].contains("items")) return nullptr;
    json first = nullptr;
    for (const auto& item : results[type]["items"]) {
        if (!item.is_object()) continue;
        if (core_name(item.value("name", "")) == core_name(name)) return item;
        if (first.is_null()) first = item;
    }
    return first;
}

Result failed(std::string say) {
    Result r;
    r.ok = false;
    r.say = std::move(say);
    return r;
}

Result playing(bool on, std::string say = "") {
    Result r;
    r.say = std::move(say);
    r.playing = on;
    return r;
}

Result said(std::string say) {
    Result r;
    r.say = std::move(say);
    return r;
}

Result volume_set(int volume) {
    Result r;
    r.volume = volume;
    return r;
}

// d[key] for a const json: its operator[] asserts on a missing key instead of returning null
const json& field(const json& d, const char* key) {
    static const json null;
    const auto it = d.find(key);
    return it == d.end() ? null : *it;
}

// "42" → 42; anything else (sign, fraction, trailing text) → nullopt
std::optional<long> whole_number(const std::string& s) {
    if (s.empty() || s.find_first_not_of("0123456789") != std::string::npos || s.size() > 9) return std::nullopt;
    return std::stol(s);
}

// Smallest image at least 64 px wide (a thumbnail for the panel), else the first; empty if none.
std::string thumbnail(const json& images) {
    std::string url;
    int best = 0;
    if (!images.is_array()) return url;
    for (const auto& i : images) {
        if (!field(i, "url").is_string()) continue;
        const int w = field(i, "width").is_number() ? field(i, "width").get<int>() : 0;
        if (url.empty() || (w >= 64 && (best < 64 || w < best))) {
            url = i["url"];
            best = w;
        }
    }
    return url;
}

std::int64_t epoch_ms() {
    return std::chrono::duration_cast<std::chrono::milliseconds>(std::chrono::system_clock::now().time_since_epoch()).count();
}

bool starts_playback(const std::string& action) {
    return action == "play" || action == "play_playlist" || action == "play_liked";
}

} // namespace

Player::Player(PlayerConfig cfg, Auth& auth, Http& http) : cfg_(std::move(cfg)), auth_(auth), http_(http) {}

Result Player::run(const Command& c) {
    try {
        return dispatch(c);
    } catch (const Failure& e) {
        std::cout << "[spotify] " << c.action << ": " << e.what() << std::endl;
        return failed(e.say);
    } catch (const AuthError& e) {
        std::cout << "[spotify] " << c.action << ": " << e.what() << std::endl;
        return failed("Spotify isn't logged in.");
    } catch (const HttpError& e) {
        std::cout << "[spotify] " << c.action << ": " << e.what() << std::endl;
        return failed("I can't reach Spotify.");
    } catch (const std::exception& e) {
        std::cout << "[spotify] " << c.action << ": " << e.what() << std::endl;
        return failed("Something went wrong with Spotify.");
    }
}

void Player::duck() {
    if (duck_) return;
    if (cfg_.duck_percent >= 100 || duck_disallowed_) return warm_up();
    try {
        // The active device and whether it plays, in one request. 204 = nothing active.
        const auto r = api("GET", "/me/player");
        if (r.status != 204) expect_ok(r, "player");
        const json p = r.status == 204 ? json::object() : json::parse(r.body);
        const json d = p.value("device", json());
        if (!d.is_object() || !field(d, "id").is_string() || !in_room(d.value("name", "")) || !p.value("is_playing", false))
            return warm_up();  // nothing playing in the room: nothing to duck
        const std::string id = field(d, "id");
        const std::string name = d.value("name", "");
        const int volume = field(d, "volume_percent").is_number() ? field(d, "volume_percent").get<int>() : 50;
        if (volume > 0) {
            const int to = volume * cfg_.duck_percent / 100;
            const auto v = api("PUT", "/me/player/volume?volume_percent=" + std::to_string(to) + "&device_id=" + id);
            if (v.status == 403) {  // VOLUME_CONTROL_DISALLOW: some speakers only take volume from their own app
                duck_disallowed_ = true;
                std::cout << "[spotify] " << name << " refuses remote volume (" << error_reason(v) << "): ducking off"
                          << std::endl;
            } else {
                expect_ok(v, "duck");
                duck_ = Duck{.device_id = id, .restore_to = volume, .ducked_to = to};
                save_duck();
            }
        }
    } catch (const std::exception& e) {
        std::cout << "[spotify] duck: " << e.what() << std::endl;
    }
    warm_up();  // the user is still talking: time for the device list the command needs
}

void Player::restore() {
    if (!duck_) return;
    try {
        const json list = fetch_devices();
        // Duck files from before the device id was saved: the box
        const std::string id = duck_->device_id.empty() ? box(list).id : duck_->device_id;
        const auto d = std::find_if(list.begin(), list.end(), [&](const json& x) { return x.value("id", "") == id; });
        if (d == list.end()) throw std::runtime_error("the ducked device left the device list");
        const int volume = field((*d), "volume_percent").is_number() ? field((*d), "volume_percent").get<int>() : 50;
        // Speakers with coarse volume steps report a rounded value: a few percent off is still "unchanged".
        if (std::abs(volume - duck_->ducked_to) > 5) {
            std::cout << "[spotify] volume changed to " << volume << " while ducked, leaving it" << std::endl;
        } else {
            expect_ok(api("PUT", "/me/player/volume?volume_percent=" + std::to_string(duck_->restore_to) +
                                     "&device_id=" + id),
                      "restore");
        }
        duck_.reset();
    } catch (const std::exception& e) {
        std::cout << "[spotify] restore: " << e.what() << std::endl;
        if (++duck_->attempts >= 3) {
            std::cout << "[spotify] giving up restoring the volume to " << duck_->restore_to << std::endl;
            duck_.reset();
        }
    }
    save_duck();
}

void Player::recover() {
    if (cfg_.duck_file.empty()) return;
    std::ifstream f(cfg_.duck_file);
    if (!f) return;
    const auto j = json::parse(f, nullptr, /*allow_exceptions=*/false);
    if (j.is_object() && field(j, "restore_to").is_number_integer() && field(j, "ducked_to").is_number_integer()) {
        std::cout << "[spotify] restoring the volume a restart left ducked" << std::endl;
        duck_ = Duck{.device_id = j.value("device_id", ""), .restore_to = j["restore_to"], .ducked_to = j["ducked_to"]};
        restore();
    }
    std::remove(cfg_.duck_file.c_str());
    duck_.reset();
}

// A file in tmpfs ($XDG_RUNTIME_DIR): survives a service restart, not a reboot, and never touches the microSD.
void Player::save_duck() const {
    if (cfg_.duck_file.empty()) return;
    if (!duck_) {
        std::remove(cfg_.duck_file.c_str());
        return;
    }
    std::ofstream(cfg_.duck_file) << json{{"device_id", duck_->device_id},
                                          {"restore_to", duck_->restore_to},
                                          {"ducked_to", duck_->ducked_to}}
                                         .dump();
}

void Player::warm_up() {
    try {
        warm_list_ = fetch_devices();
        warmed_at_ = std::chrono::steady_clock::now();
    } catch (const std::exception& e) {
        warm_list_.reset();
        std::cout << "[spotify] warm-up: " << e.what() << std::endl;
    }
}

Result Player::dispatch(const Command& c) {
    if (c.action == "now_playing") return now_playing();
    // A warmed-up list is used once: volumes and "active" flags are only seconds old.
    const bool warm = warm_list_ && std::chrono::steady_clock::now() - warmed_at_ < std::chrono::seconds(15);
    const std::optional<json> cached = std::exchange(warm_list_, std::nullopt);
    if (!warm) return dispatch(fetch_devices(), c);
    try {
        return dispatch(*cached, c);
    } catch (const Failure& e) {
        if (e.status != 404) throw;  // 404 = device id gone (restarted since the warm-up): look it up again
        std::cout << "[spotify] " << c.action << ": " << e.what() << ", retrying with a fresh device list" << std::endl;
        return dispatch(fetch_devices(), c);
    }
}

Result Player::dispatch(const json& list, const Command& c) {
    if (!c.device_id.empty()) {
        const auto d = std::find_if(list.begin(), list.end(), [&](const json& x) { return field(x, "id") == c.device_id; });
        if (d != list.end()) return dispatch(device_of(*d), c.action, c.query);
        if (c.device_id == last_id_) return dispatch(box(list), c.action, c.query);  // box in standby (snapshot lists it)
        throw Failure("device id " + c.device_id + " not in the device list", "That speaker isn't available any more.");
    }
    if (c.device.empty()) return dispatch(starts_playback(c.action) ? box(list) : active(list), c.action, c.query);

    const auto d = speaker(list, c.device);
    if (!d) {
        std::string names;
        for (const auto& x : list) names += (names.empty() ? "" : ", ") + x.value("name", "?");
        const std::string detail = "no speaker matches \"" + c.device + "\" (Spotify sees: " +
                                   (names.empty() ? "none" : names) + "; phones and PCs only while their app is open)";
        if (c.fallback_action.empty()) throw Failure(detail, "I can't find a speaker called " + c.device + ".");
        std::cout << "[spotify] " << detail << ", doing " << c.fallback_action << " \"" << c.fallback_query << "\""
                  << std::endl;
        return dispatch(list, Command{.action = c.fallback_action, .query = c.fallback_query});
    }
    Result r = dispatch(*d, c.action, c.query);
    if (lower(d->name) == lower(cfg_.device_name)) return r;
    // Name the speaker when it isn't the box: "Playing Daft Punk on Bathroom speaker."
    if (r.say.empty()) r.say = (c.action == "play" && c.query.empty() ? "Moving the music to " : "Playing on ") + d->name + ".";
    else if (r.say.ends_with(".")) r.say.insert(r.say.size() - 1, " on " + d->name);
    return r;
}

Result Player::dispatch(const Device& d, const std::string& action, const std::string& query) {
    if (!starts_playback(action)) return dispatch_on(d, action, query);  // "pause the bathroom speaker" moves nothing
    const json here = {{"id", d.output.empty() ? d.id : d.output}, {"name", d.name}, {"type", d.type}};
    if (!d.output.empty() && on_output_) on_output_(d.output);  // speakers connects while Spotify starts
    if (action == "play" && query.empty() && !d.output.empty() && d.local_active) {
        // Soloist already plays (maybe on another Nest): moving the music is speakers' job. A transfer to the same
        // device would only pause Soloist for a moment. Resume in case it's paused; 403 = already playing.
        const auto r = api("PUT", "/me/player/play?device_id=" + d.id);
        if (r.status != 403) expect_ok(r, "resume");
        Result moved = playing(true);
        moved.device = here;
        return moved;
    }
    Result r = dispatch_on(d, action, query);
    r.device = here;
    return r;
}

Result Player::dispatch_on(const Device& d, const std::string& action, const std::string& query) {
    const std::string on = "?device_id=" + d.id;

    if (action == "play") return play(d, query);
    if (action == "play_playlist") return play_playlist(d, query);
    if (action == "set_volume") return set_volume(d, query);
    if (action == "pause") {
        const auto r = api("PUT", "/me/player/pause" + on);
        if (r.status != 403) expect_ok(r, "pause");  // 403 = already paused
        return playing(false);
    }
    if (action == "next" || action == "previous") {
        expect_ok(api("POST", "/me/player/" + action + on), action);
        return playing(true);
    }
    if (action == "volume_up" || action == "volume_down") {
        const int step = action == "volume_up" ? cfg_.volume_step : -cfg_.volume_step;
        if (duck_ && duck_->device_id == d.id) {  // louder than before the duck: applied by restore()
            duck_->restore_to = std::clamp(duck_->restore_to + step, 0, 100);
            save_duck();
            return volume_set(duck_->restore_to);
        }
        const int volume = std::clamp(d.volume + step, 0, 100);
        expect_ok(api("PUT", "/me/player/volume?volume_percent=" + std::to_string(volume) + "&device_id=" + d.id),
                  "volume");
        return volume_set(volume);
    }
    if (action == "shuffle") {
        const bool on = query != "off";
        expect_ok(api("PUT", std::string("/me/player/shuffle?state=") + (on ? "true" : "false") + "&device_id=" + d.id),
                  "shuffle");
        return said(on ? "Shuffle is on." : "Shuffle is off.");
    }
    if (action == "repeat") {
        const std::string state = query == "track" || query == "off" ? query : "context";
        expect_ok(api("PUT", "/me/player/repeat?state=" + state + "&device_id=" + d.id), "repeat");
        return said(state == "track" ? "Repeating this song." : state == "off" ? "Repeat is off." : "Repeat is on.");
    }
    if (action == "play_liked") return play_liked(d, query == "shuffle");
    if (action == "seek") {
        const auto ms = whole_number(query);
        if (!ms) throw Failure("seek position \"" + query + "\" is not a number of ms", "I can't skip there.");
        expect_ok(api("PUT", "/me/player/seek?position_ms=" + std::to_string(*ms) + "&device_id=" + d.id), "seek");
        return {};
    }
    throw Failure("unknown action \"" + action + "\"", "I can't do that with Spotify.");
}

Result Player::play(const Device& d, const std::string& query) {
    const std::string on = "?device_id=" + d.id;

    if (!query.empty()) {
        // "… playlist" searches playlists only. "<song> by <artist>" searches with field filters, which
        // matches far better than the plain text. Otherwise an exact artist name wins, then the best track.
        std::string q = lower(query);
        const bool want_playlist = q.size() > 9 && q.ends_with(" playlist");
        if (want_playlist) q.resize(q.size() - 9);
        // "play the ones" when "The Ones" is your playlist: yours wins over a search (exact or contained name)
        if (!want_playlist) {
            if (const json own = best_own_playlist(q, 500); !own.is_null()) {
                expect_ok(api("PUT", "/me/player/play" + on, {{"context_uri", own["uri"]}}), "play");
                return playing(true, "Playing your playlist " + own["name"].get<std::string>() + ".");
            }
        }
        std::string title = q;  // the name a track result should have
        std::string search = q;
        std::string types = want_playlist ? "playlist" : "artist,track,playlist";
        if (const auto by = q.rfind(" by "); !want_playlist && by != std::string::npos && by > 0) {
            title = q.substr(0, by);
            search = "track:" + title + " artist:" + q.substr(by + 4);
            types = "track";
        }
        auto search_for = [&](const std::string& text, const std::string& type) {
            const auto r = api("GET", "/search?q=" + url_encode(text) + "&type=" + type + "&limit=5");
            expect_ok(r, "search");
            return json::parse(r.body);
        };
        json results = search_for(search, types);
        if (types == "track" && best_item(results, "tracks", title).is_null()) {
            // Filters too strict (e.g. misheard artist): fall back to the plain text.
            std::cout << "[spotify] no result for " << search << ", retrying as plain text" << std::endl;
            results = search_for(q, "artist,track,playlist");
        }

        json body;
        std::string say;
        const json artist = best_item(results, "artists", q);
        const json track = best_item(results, "tracks", title);
        const json playlist = best_item(results, "playlists", q);
        if (!artist.is_null() && !want_playlist && core_name(artist["name"]) == core_name(q)) {
            body = {{"context_uri", artist["uri"]}};
            say = "Playing " + artist["name"].get<std::string>() + ".";
        } else if (!track.is_null() && !want_playlist) {
            body = {{"uris", {track["uri"]}}};
            say = "Playing " + track["name"].get<std::string>();
            if (!track["artists"].empty()) say += " by " + track["artists"][0]["name"].get<std::string>();
            say += ".";
        } else if (!playlist.is_null()) {
            body = {{"context_uri", playlist["uri"]}};
            say = "Playing the playlist " + playlist["name"].get<std::string>() + ".";
        } else {
            throw Failure("no search result for \"" + q + "\"", "I couldn't find " + query + " on Spotify.");
        }
        expect_ok(api("PUT", "/me/player/play" + on, body), "play");
        return playing(true, say);
    }

    // Resume. If the box isn't the active device yet, transfer playback to it (continues where the
    // phone/PC left off). With nothing to resume, fall back to BUDDY_SPOTIFY_DEFAULT_URI.
    const auto r = d.active ? api("PUT", "/me/player/play" + on)
                            : api("PUT", "/me/player", {{"device_ids", {d.id}}, {"play", true}});
    if (r.status / 100 != 2 && !cfg_.default_uri.empty()) {
        std::cout << "[spotify] nothing to resume (" << r.status << " " << error_reason(r) << "), playing "
                  << cfg_.default_uri << std::endl;
        expect_ok(api("PUT", "/me/player/play" + on, {{"context_uri", cfg_.default_uri}}), "play default");
    } else {
        expect_ok(r, "resume");
    }
    return playing(true);
}

Result Player::play_playlist(const Device& d, const std::string& name) {
    if (name.empty()) {
        if (cfg_.default_uri.empty())
            throw Failure("\"play my playlist\" without a name, but BUDDY_SPOTIFY_DEFAULT_URI is not set",
                          "Which playlist? You haven't set a default one.");
        expect_ok(api("PUT", "/me/player/play?device_id=" + d.id, {{"context_uri", cfg_.default_uri}}), "play");
        return playing(true);
    }

    const json best = best_own_playlist(name, 1);
    if (best.is_null()) {  // not one of yours: a public playlist of that name
        std::cout << "[spotify] no own playlist matches \"" << name << "\", searching public ones" << std::endl;
        return play(d, name + " playlist");
    }
    expect_ok(api("PUT", "/me/player/play?device_id=" + d.id, {{"context_uri", best["uri"]}}), "play");
    return playing(true, "Playing your playlist " + best["name"].get<std::string>() + ".");
}

// All playlists you own or follow, 50 per page; 200 is plenty for voice selection. Cached for 10 minutes: plain
// "play X" checks them on every command.
const json& Player::own_playlists() {
    const auto now = std::chrono::steady_clock::now();
    if (!playlists_.is_null() && now - playlists_at_ < std::chrono::minutes(10)) return playlists_;
    json all = json::array();
    for (int offset = 0; offset < 200; offset += 50) {
        const auto r = api("GET", "/me/playlists?limit=50&offset=" + std::to_string(offset));
        if (r.status == 401 || r.status == 403)  // login from before playlist scopes were requested
            throw Failure("playlists: HTTP " + std::to_string(r.status) + " " + error_reason(r) +
                              " (run buddy-spotify --login again for the playlist permission)",
                          "I'm not allowed to read your playlists yet. Please log in to Spotify again.");
        expect_ok(r, "playlists");
        const json page = json::parse(r.body);
        for (const auto& p : page["items"])
            if (p.is_object() && p["name"].is_string() && p["uri"].is_string()) all.push_back(p);
        if (page["items"].size() < 50) break;
    }
    playlists_ = std::move(all);
    playlists_at_ = now;
    return playlists_;
}

// Best-matching own playlist with at least min_score (see match_score), else null.
json Player::best_own_playlist(const std::string& name, int min_score) {
    json best = nullptr;
    int best_score = min_score - 1;
    for (const auto& p : own_playlists()) {
        const int score = match_score(p["name"], name);
        if (score > best_score) {
            best_score = score;
            best = p;
        }
    }
    return best;
}

Result Player::set_volume(const Device& d, const std::string& query) {
    const int volume = static_cast<int>(whole_number(query).value_or(-1));
    if (volume < 0 || volume > 100)
        throw Failure("volume \"" + query + "\" out of range", "The volume goes from 0 to 100.");
    if (duck_ && duck_->device_id == d.id) {  // applied by restore(), like "louder"
        duck_->restore_to = volume;
        save_duck();
        return volume_set(volume);
    }
    expect_ok(api("PUT", "/me/player/volume?volume_percent=" + std::to_string(volume) + "&device_id=" + d.id), "volume");
    return volume_set(volume);
}

Result Player::now_playing() {
    const auto r = api("GET", "/me/player");
    if (r.status != 204) expect_ok(r, "player");
    const json p = r.status == 204 ? json::object() : json::parse(r.body);
    const json item = p.value("item", json());
    if (!item.is_object() || !item["name"].is_string()) return said("Nothing is playing.");
    std::string say = "This is " + item["name"].get<std::string>();
    if (item.contains("artists") && !item["artists"].empty() && item["artists"][0]["name"].is_string())
        say += " by " + item["artists"][0]["name"].get<std::string>();
    else if (item.contains("show") && item["show"]["name"].is_string())  // podcast episode
        say += " from " + item["show"]["name"].get<std::string>();
    return said(say + ".");
}

// Liked songs aren't an official play context (only albums, artists and playlists are). The undocumented
// "spotify:user:<id>:collection" plays the whole library ⚠️; if Spotify refuses it, the 50 newest liked songs
// are played as a track list (needs the user-library-read scope).
Result Player::play_liked(const Device& d, bool shuffle) {
    const auto me = api("GET", "/me");
    expect_ok(me, "me");
    const std::string user = json::parse(me.body).value("id", "");
    auto r = api("PUT", "/me/player/play?device_id=" + d.id, {{"context_uri", "spotify:user:" + user + ":collection"}});
    if (r.status / 100 != 2) {
        std::cout << "[spotify] collection context refused (" << r.status << " " << error_reason(r)
                  << "), playing the newest liked songs" << std::endl;
        const auto t = api("GET", "/me/tracks?limit=50");
        if (t.status == 401 || t.status == 403)
            throw Failure("liked songs: HTTP " + std::to_string(t.status) + " (run buddy-spotify --login again)",
                          "I'm not allowed to read your liked songs yet. Please log in to Spotify again.");
        expect_ok(t, "liked songs");
        json uris = json::array();
        const json liked = json::parse(t.body);  // named: a temporary dies before the loop body (C++20)
        for (const auto& i : liked["items"])
            if (const json& t = field(i, "track"); t.is_object() && field(t, "uri").is_string()) uris.push_back(t["uri"]);
        if (uris.empty()) throw Failure("no liked songs", "You don't have any liked songs yet.");
        if (shuffle) std::shuffle(uris.begin(), uris.end(), std::mt19937(std::random_device{}()));
        r = api("PUT", "/me/player/play?device_id=" + d.id, {{"uris", uris}});
    }
    expect_ok(r, "play liked");
    if (shuffle) expect_ok(api("PUT", "/me/player/shuffle?state=true&device_id=" + d.id), "shuffle");
    return playing(true, shuffle ? "Shuffling your liked songs." : "Playing your liked songs.");
}

std::optional<json> Player::snapshot() {
    try {
        const auto r = api("GET", "/me/player");
        if (r.status != 204) expect_ok(r, "player");
        const json p = r.status == 204 || r.body.empty() ? json::object() : json::parse(r.body);
        const json list = fetch_devices();

        json out = {{"playing", p.value("is_playing", false)}, {"volume", nullptr}, {"device", nullptr},
                    {"track", nullptr}, {"progress", nullptr}, {"devices", json::array()}};
        const json& d = field(p, "device");
        if (d.is_object() && field(d, "id").is_string()) {
            out["device"] = {{"id", d["id"]}, {"name", d.value("name", "")}, {"type", d.value("type", "")}};
            for (const auto& x : list)  // Soloist plays: show the Nest it plays on
                if (field(x, "local_id") == d["id"] && x.value("is_active", false))
                    out["device"] = {{"id", x["id"]}, {"name", x["name"]}, {"type", x["type"]}};
            if (duck_ && d["id"] == duck_->device_id) out["volume"] = duck_->restore_to;
            else if (field(d, "volume_percent").is_number() && d.value("supports_volume", true)) out["volume"] = d["volume_percent"];
        }
        const json& item = field(p, "item");
        if (item.is_object() && field(item, "name").is_string()) {
            // track: artists + album; podcast episode: show
            std::string artist;
            if (field(item, "artists").is_array())
                for (const auto& a : item["artists"])
                    if (field(a, "name").is_string()) artist += (artist.empty() ? "" : ", ") + a["name"].get<std::string>();
            const json& album = field(item, "album");
            const json& show = field(item, "show");
            if (artist.empty() && show.is_object()) artist = show.value("name", "");
            const json& images = album.is_object() ? field(album, "images") : show.is_object() ? field(show, "images") : field(item, "images");
            out["track"] = {{"name", item["name"]}, {"artist", artist},
                            {"album", album.is_object() ? album.value("name", "") : ""}, {"image", thumbnail(images)}};
            if (field(p, "progress_ms").is_number() && field(item, "duration_ms").is_number())
                out["progress"] = {{"ms", p["progress_ms"]}, {"duration_ms", item["duration_ms"]}, {"at", epoch_ms()}};
        }
        bool box_listed = false;
        for (const auto& x : list) {
            if (!field(x, "id").is_string()) continue;
            const bool volume = field(x, "volume_percent").is_number() && x.value("supports_volume", true);
            out["devices"].push_back({{"id", x["id"]}, {"name", x.value("name", "")}, {"type", x.value("type", "")},
                                      {"active", x.value("is_active", false)},
                                      {"volume", volume ? x["volume_percent"] : json(nullptr)}});
            box_listed = box_listed || lower(x.value("name", "")) == lower(cfg_.device_name);
        }
        // The box in standby leaves the list but may still take playback on its last id ⚠️
        if (!box_listed && !last_id_.empty())
            out["devices"].push_back({{"id", last_id_}, {"name", cfg_.device_name}, {"type", "Speaker"},
                                      {"active", false}, {"volume", nullptr}});
        if (snapshot_failing_) std::cout << "[spotify] player state is back" << std::endl;
        snapshot_failing_ = false;
        return out;
    } catch (const std::exception& e) {
        if (!snapshot_failing_) std::cout << "[spotify] player state: " << e.what() << std::endl;
        snapshot_failing_ = true;
        return std::nullopt;
    }
}

json progress_to_publish(const json& old, const json& fresh) {
    const json& was = field(old, "progress");
    const json& now = field(fresh, "progress");
    if (!was.is_object() || !now.is_object() || field(old, "track") != field(fresh, "track") ||
        field(old, "playing") != field(fresh, "playing") || was["duration_ms"] != now["duration_ms"])
        return now;
    const std::int64_t expected = was["ms"].get<std::int64_t>() +
                                  (fresh.value("playing", false) ? now["at"].get<std::int64_t>() - was["at"].get<std::int64_t>() : 0);
    return std::abs(expected - now["ms"].get<std::int64_t>()) <= 2000 ? was : now;
}

std::vector<std::string> Player::devices() {
    std::vector<std::string> out;
    for (const auto& d : fetch_devices()) {
        std::string line = "\"" + d.value("name", "?") + "\" (" + d.value("type", "?");
        if (d.value("is_active", false)) line += ", active";
        if (field(d, "volume_percent").is_number()) line += ", volume " + std::to_string(field(d, "volume_percent").get<int>()) + " %";
        if (lower(d.value("name", "")) == lower(cfg_.device_name)) line += ", the box";
        else if (in_room(d.value("name", ""))) line += ", ducked";
        out.push_back(line + ")");
    }
    return out;
}

json Player::fetch_devices() {
    const auto r = api("GET", "/me/player/devices");
    expect_ok(r, "devices");
    json list = json::parse(r.body).value("devices", json::array());
    for (const auto& d : list)
        if (lower(d.value("name", "")) == lower(cfg_.device_name) && field(d, "id").is_string()) last_id_ = field(d, "id");
    return with_nests(std::move(list));
}

void Player::set_speakers(const json& state) {
    nests_ = json::array();
    if (state.is_object() && field(state, "speakers").is_array())
        for (const auto& s : state["speakers"])
            if (field(s, "id").is_string() && field(s, "name").is_string()) nests_->push_back({{"id", s["id"]}, {"name", s["name"]}});
    selected_nest_ = state.is_object() && field(state, "selected").is_string() ? state["selected"].get<std::string>() : "";
}

json Player::with_nests(json list) const {
    if (!nests_) return list;
    json local;
    json out = json::array();
    for (auto& d : list) {
        if (lower(d.value("name", "")) == lower(cfg_.local_device)) local = std::move(d);
        else out.push_back(std::move(d));
    }
    if (!local.is_object() || !field(local, "id").is_string()) return out;  // Soloist not running: no Nest playable
    for (const auto& n : *nests_) {
        const std::string name = n["name"];
        // A phone casting straight to the Nest lists it under the same name: shown instead while it plays
        const auto twin = std::find_if(out.begin(), out.end(), [&](const json& x) { return lower(x.value("name", "")) == lower(name); });
        if (twin != out.end()) {
            if (twin->value("is_active", false)) continue;
            out.erase(twin);
        }
        json e = local;
        e["id"] = n["id"];
        e["name"] = name;
        e["type"] = "Speaker";
        e["is_active"] = local.value("is_active", false) && n["id"] == selected_nest_;
        e["local_id"] = local["id"];
        e["local_active"] = local.value("is_active", false);
        out.push_back(std::move(e));
    }
    return out;
}

Player::Device Player::device_of(const json& d) {
    const bool nest = field(d, "local_id").is_string();
    return {.id = nest ? d["local_id"].get<std::string>() : d.value("id", ""), .name = d.value("name", ""),
            .active = d.value("is_active", false),
            .volume = field(d, "volume_percent").is_number() ? field(d, "volume_percent").get<int>() : 50,
            .type = d.value("type", ""), .output = nest ? d.value("id", "") : "",
            .local_active = d.value("local_active", false)};
}

Player::Device Player::box(const json& list) const {
    for (const auto& d : list)
        if (lower(d.value("name", "")) == lower(cfg_.device_name) && field(d, "id").is_string()) return device_of(d);
    // Some Connect speakers leave the list in standby but still accept playback on their old id ⚠️
    if (!last_id_.empty()) {
        std::cout << "[spotify] " << cfg_.device_name << " not in the device list, trying its last id" << std::endl;
        return {.id = last_id_, .name = cfg_.device_name};
    }
    throw Failure("device \"" + cfg_.device_name + "\" not found (off, or not on the network?)",
                  cfg_.device_name + " isn't available.");
}

Player::Device Player::active(const json& list) const {
    for (const auto& d : list)
        if (d.value("is_active", false) && field(d, "id").is_string()) return device_of(d);
    return box(list);
}

// Best match for the spoken name (names::best_matches); "the box" / "music box" is always the box.
std::optional<Player::Device> Player::speaker(const json& list, const std::string& spoken) const {
    const std::string want = names::spoken_name(spoken);
    if (want == "box" || want == "music box") return box(list);
    std::vector<const json*> devices;
    std::vector<std::string> device_names;
    for (const auto& d : list) {
        if (!field(d, "id").is_string()) continue;
        devices.push_back(&d);
        device_names.push_back(d.value("name", ""));
    }
    const auto best = names::best_matches(device_names, want);
    if (best.empty()) return std::nullopt;
    if (best.size() > 1) {
        const std::string& a = device_names[best[0]];
        const std::string& b = device_names[best[1]];
        throw Failure("\"" + spoken + "\" matches " + a + " and " + b, "Which speaker, " + a + " or " + b + "?");
    }
    return device_of(*devices[best[0]]);
}

bool Player::in_room(const std::string& name) const {
    if (lower(name) == lower(cfg_.device_name)) return true;
    return std::any_of(cfg_.duck_devices.begin(), cfg_.duck_devices.end(),
                       [&](const std::string& d) { return lower(d) == lower(name); });
}

HttpResponse Player::api(const std::string& method, const std::string& path, const json& body) {
    for (int attempt = 0;; ++attempt) {
        std::vector<std::string> headers = {"Authorization: Bearer " + auth_.access_token()};
        if (!body.is_null()) headers.emplace_back("Content-Type: application/json");
        auto r = http_.request(method, kApi + path, headers, body.is_null() ? "" : body.dump());
        if (r.status == 401 && attempt == 0) {  // access token expired early or revoked: refresh once
            auth_.invalidate();
            continue;
        }
        return r;
    }
}

void Player::expect_ok(const HttpResponse& r, const std::string& what) {
    if (r.status / 100 == 2) return;
    const std::string reason = error_reason(r);
    const std::string detail = what + ": HTTP " + std::to_string(r.status) + " " + reason;
    if (reason == "PREMIUM_REQUIRED") throw Failure(detail, "Spotify Premium is required for that.", r.status);
    if (r.status == 429) throw Failure(detail, "Spotify is busy, try again in a minute.", r.status);
    if (r.status == 404) throw Failure(detail, "There's nothing to play on " + cfg_.device_name + ".", r.status);
    throw Failure(detail, "Spotify didn't accept that.", r.status);
}

} // namespace buddy::spotify
