noahbachmann/buddy/(commit log)

2026-10-22 shared: typed env helpers, ears_state topic
    - env_string/env_int/env_float for BUDDY_* config; bad numbers throw
    with the variable name instead of a bare std::stoi error.
    - buddy/ears/state (retained): idle | listening | transcribing, for the
    eyes in phase 2. Payload docs for ears_wake and ears_transcript.
    [config.hpp]
2026-10-22 build: ONNX Runtime and whisper.cpp, model download
    - ONNX Runtime 1.30.0: Microsoft's prebuilt aarch64 release in
    /opt/onnxruntime (setup-pi.sh, checksum-verified). Debian's
    libonnxruntime-dev 1.21 prints ~570 "Schema error" lines per start.
    - whisper.cpp v1.9.5 via FetchContent (pinned tarball + SHA256), static,
    GGML_NATIVE; -O2 even in Debug builds.
    - deploy/fetch-models.sh: openWakeWord + Silero VAD (checksummed) and
    whisper GGML models into ~/buddy/models.
    - CMake 3.28 minimum (FetchContent EXCLUDE_FROM_ALL), C enabled for ggml.
2026-10-22 ears: wake word, end-of-speech detection, speech-to-text
    New service buddy-ears (steps 1.6 + 1.7):
    ALSA "default" (PipeWire) 16 kHz mono → openWakeWord (3 ONNX models,
    80 ms chunks) → Silero VAD endpointing → whisper.cpp → MQTT.
    - Publishes buddy/ears/wake, buddy/ears/state, buddy/ears/transcript.
    - Capture runs on its own thread; audio queues while whisper is busy.
    - Retries the audio device every 2 s (Jabra/PipeWire late after boot).
    - `buddy-ears --wav file.wav`: offline test, prints instead of MQTT.
    - deploy.sh deploys only ears now; ping/pong stay as templates.
    Tested in a Debian 13 container: synthesized "Hey Jarvis … play
    Spotify" triggers (score 0.98) and endpoints 0.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
2026-10-23 brain: rule-based intent router (1.8)
    Transcript → normalized text → regex rules → buddy/brain/intent and
    buddy/spotify/cmd. Unknown commands ask voice to say sorry. The rules sit
    behind IntentParser so an LLM can replace them later. --test prints the
    intent for given texts without MQTT.
    [intent.hpp, main.cpp, rules.cpp, rules.hpp]
2026-10-23 spotify: Web API skill for librespot (1.9)
    buddy/spotify/cmd → Spotify Web API on the "Buddy" Connect device:
    play (resume, transfer, or search "play <artist|track|… playlist>"),
    pause, next, previous, volume up/down. Replies and errors go to
    buddy/voice/say; buddy/spotify/state carries playing/volume.
    Login is OAuth PKCE (no client secret on the Pi): --login prints the URL,
    you paste back the redirect; the refresh token lives in
    ~/buddy/config/spotify-token.json (600) and is rotated on refresh.
    --cmd runs one command without MQTT. HTTP via libcurl.
    [auth.cpp, auth.hpp, http.cpp, http.hpp, main.cpp, player.cpp, player.hpp]
2026-10-23 shared: BlockingQueue for MQTT callback → main thread hand-off
    Moved out of spotify; voice needs the same.
2026-10-23 voice: Piper text-to-speech service (1.10)
    buddy/voice/say {"text"} → libpiper → ALSA default (PipeWire), sentence
    by sentence so the first one plays while the next is synthesized.
    buddy/voice/state is idle/speaking (retained) for ducking in 1.11.
    --say "…" [--wav f.wav] tests without MQTT.
2026-10-23 docs: 1.8–1.10 in progress, decisions D10–D12
2026-10-23 deploy: Spotify Soloist instead of librespot
    Spotify refuses audio keys to librespot on many accounts ("error audio
    key 0 1", librespot issue #1649): the device connects but every track is
    skipped. Soloist is Spotify's official headless Connect client (Aug 2026)
    and appears as the same "Buddy" device, so buddy-spotify is unchanged.
    - soloist-update.sh fetches the current arm64 build from Spotify (builds
    expire after 90 days; a weekly user timer refreshes it)
    - buddy-soloist.service: needs BUDDY_SOLOIST_API_KEY, waits for DNS at
    boot (Soloist restores its login only once), WebSocket API on loopback
    - setup-pi.sh removes the librespot unit, its credentials and raspotify
    [main.cpp, player.cpp, player.hpp]
2026-10-23 deploy: run Spotify Soloist in a systemd sandbox
    Soloist is closed source. buddy-soloist.service now hides the home
    directory (tmpfs) except the binary and Soloist's own data/cache folders,
    makes the system read-only and blocks privilege gain, exotic syscalls and
    non-IP/UNIX sockets.
    Its API key moves from buddy.env to its own soloist.env, so the process
    gets no other settings; setup-pi.sh migrates an existing key. The update
    script compares checksums instead of running the new binary unsandboxed.
2026-10-23 fix(shared): strip whitespace and \r from BUDDY_* values
    A buddy.env saved with Windows line endings or a stray space made
    BUDDY_SPOTIFY_CLIENT_ID invalid ("INVALID_CLIENT" at login) and numbers
    unparsable, with nothing visible in the editor.
    [config.hpp]
2026-10-23 fix(spotify): warn when the client ID doesn't look like one
    [main.cpp]
2026-10-23 fix(deploy): give sandboxed Soloist the PulseAudio socket
    ProtectHome=tmpfs also hides /run/user/<uid>, so Soloist couldn't reach
    pipewire-pulse ("Failed to create secure directory
    (/run/user/1000/pulse)") and paused right after every play.
2026-10-23 docs(1.9): troubleshooting for Soloist pausing without the audio socket
2026-10-23 fix(spotify): better search for "<song> by <artist>"
    "play peach by kevin abstract" played Encino by Brockhampton: the whole
    sentence went to Spotify as free text and the top hit was used.
    Now "X by Y" searches with track:/artist: filters (plain text as
    fallback), and the best of 5 results whose name matches wins over the
    top hit.
    [player.cpp]
2026-10-23 fix(brain): accept "played"/"plays"/"playing" as "play"
    whisper transcribed "play city lights …" as "played city lights …",
    which matched no rule.
    [rules.cpp]
2026-10-23 feat(brain): "play my playlist <name>" intent
    "play my playlist X", "play my X playlist", "play from my list X"
    → play_playlist with query X; "play my playlist" without a name → the
    default playlist. Routed to spotify like the other music intents.
2026-10-23 feat(spotify): play your own playlists by name
    play_playlist searches GET /me/playlists (own and followed, up to 200):
    exact name > name contains it > most spoken words in the name, so a
    slightly misheard name still works. Without a name it plays
    BUDDY_SPOTIFY_DEFAULT_URI.
    Login now also asks for playlist-read-private and
    playlist-read-collaborative; existing tokens need --login again, and
    the reply says so when the permission is missing.
    [auth.cpp, player.cpp, player.hpp]
2026-10-23 fix(brain): "play mode playlist …" means "play my playlist …"
    whisper heard "play my playlist hype" as "play mode playlist type".
    Common mishearings of "my" are mapped back, but only before
    "playlist"/"list", so artists like Mode Selektor still work.
    [rules.cpp]
2026-10-23 fix(spotify): match playlist names with close spellings
    "play my playlist hype" arrived as "type": no word matched, nothing
    played. A spoken word now also scores if a word of the playlist name is
    1 letter off (2 for words of 7+ letters); exact words still score more.
    [player.cpp]
2026-10-23 feat(arm): parametric two-joint arm at adult size
    OpenSCAD models for a shoulder + elbow arm (300 / 260 mm segments),
    split to fit the P2S, support-free, servo knuckles with a 608 idler
    bearing on the opposite side. STLs in arm/stl, rendered by build.sh.
    [assembly.scad, couplers.scad, couplers.stl, forearm-bottom.scad, forearm-bottom.stl, forearm-top.scad, forearm-top.stl, lib.scad]
2026-10-23 create parts folder
    [assembly.scad, couplers.scad, couplers.stl, forearm-bottom.scad, forearm-bottom.stl, forearm-top.scad, forearm-top.stl, lib.scad]
2026-10-23 feat(ears): --transcribe runs speech-to-text on WAV files
    Only loads whisper; prints file, time and text per line, for comparing models.
2026-10-23 feat: systemd readiness, watchdog and restart backoff (1.12)
    - shared/systemd: READY/WATCHDOG/STATUS via $NOTIFY_SOCKET, no libsystemd; no-op outside systemd
    - Mqtt::start sends READY, keeps the watchdog fed while waiting for the broker, retries 0.25 s → 5 s
    and logs only every 30 s; handler and publish exceptions are logged instead of terminating
    - every service loop pings the watchdog; ears per processed chunk and while waiting for the device
    - buddy@.service: Type=notify, WatchdogSec=60, restart backoff 1 → 30 s that never gives up,
    ordered after PipeWire, UMask=0077, MemoryMax=1G
    - deploy.sh builds only the deployed targets and fails if a service doesn't become active
    - deploy/st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
    [audio_source.cpp, main.cpp, mqtt.hpp, systemd.hpp]
2026-10-23 perf(spotify): warm up token, connection and device on the wake word
    The device lookup, token refresh and TLS handshake now happen while the user is still talking.
    A command within 15 s reuses the device; a 404 falls back to a fresh lookup.
    Refs #1
2026-10-23 fix(spotify): don't crash on a token file without a refresh token
    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
    [auth.cpp]
2026-10-23 fix(voice): skip replies that waited longer than 10 s
    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
    [main.cpp]
2026-10-23 fix(deploy): start Soloist only after the clock is synced
    At boot the clock is hours behind until NTP syncs (~35 s). A login with the wrong clock is the suspected cause of the Buddy device vanishing hours later.
    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
2026-10-23 docs(guides): condense 1.2–1.6 into one summary, add 1.12 boot & hardening guide
    Six guides (1243 lines) → 01-02-06-summary.md (159 lines) with every decision, command, value and troubleshooting entry that still applies. The five newest guides stay in full.
    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
2026-10-23 docs: progress, D14, deferred work and code quick reference
    1.2–1.10 done, 1.11 (Dev) and 1.12 (power-cycle test) open. Shorter Phase 1 table. Work that needs voice recordings is listed under Deferred with what to measure.
    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
2026-10-23 fix(brain): treat "spot to find" as Spotify
    whisper heard "Play Spotify" as "Play spot to find" in the 1.12 power-cycle test; brain searched for it and played a random track.
    [rules.cpp]
2026-10-23 docs: 1.12 done (power-cycle test passed)
    Closes #1
2026-10-23 perf(voice): synthesize with 3 threads instead of 1
    libpiper hard-codes one ONNX thread. setup-pi.sh now patches it to read PIPER_INTRA_OP_THREADS
    (installed as /opt/libpiper-1.8.0-buddy1, so existing Pis rebuild), and buddy-voice sets it from
    BUDDY_VOICE_THREADS (default 3, one core left for ears).
    Measured on the Pi 5 for "Playing Acid Raindrops by People Under The Stairs.": first audio
    829 → 442 ms. A start-up warm-up wouldn't help: Piper has no cold-start penalty.
    Until setup-pi.sh runs, the stock library ignores the variable (no change).
2026-10-24 fix(1.11): bigger USB ALSA buffers so the speaker survives echo cancellation
    Echo cancellation links the Jabra mic (16 kHz only) and speaker (48 kHz) into one graph with one
    clock. With WirePlumber's default 128-frame periods the speaker XRUNs on its first cycle and never
    recovers ("snd_pcm_avail after recover: Broken pipe"): no sound at all, while every node shows
    RUNNING. A WirePlumber rule raises period-size/headroom for USB ALSA nodes; setup-pi.sh installs it
    next to buddy-audio.conf. Verified on the Pi: without the rule XRUN, with it playback runs.
2026-10-25 feat(spotify): play on the Connect music box and duck it while Buddy listens or speaks
    Music now plays on a separate Spotify Connect speaker (BUDDY_SPOTIFY_DEVICE, required).
    spotify follows buddy/ears/state and buddy/voice/state: on activity it turns the box down to
    BUDDY_SPOTIFY_DUCK_PERCENT of its volume and restores it BUDDY_SPOTIFY_DUCK_HOLD_MS after both are
    idle. Volume commands while ducked change the volume that comes back; a volume changed elsewhere
    (phone app) is left alone. The duck survives a crash in $XDG_RUNTIME_DIR. The device lookup on
    the wake word now happens as part of the duck. --cmd duck|restore test it without MQTT.
    [main.cpp, player.cpp, player.hpp]
2026-10-25 chore: remove Spotify Soloist, the mixer service and the music sink
    Music plays on the Connect box, not through the Jabra, so Soloist (units, update timer,
    soloist.env), buddy-mixer, the buddy_music loopback sink, the mixer_state topic and
    pulseaudio-utils have nothing left to do. Echo cancellation stays for Buddy's own voice.
2026-10-25 refactor(deploy): split PC and Pi scripts, setup in named steps
    deploy/ holds what runs on the PC, deploy/pi/ what runs on the Pi, deploy/config/ the files they
    install. setup.sh: pinned versions on top, one function per step, `setup.sh <step>` runs one,
    done migrations replaced by a cleanup step (Soloist, mixer, librespot leftovers), and a check
    step that warns about buddy.env keys no service reads. fetch-models.sh fetches what buddy.env
    names and says which of your own models to copy from the PC. Defaults now match the real setup:
    voice en_GB-alan-medium, ears on the echo-cancelled source (D8). Root .gitignore keeps voice
    recordings out of this public repo.
    [main.cpp]
2026-10-25 feat(brain): understand every phrasing in the command corpus, new Spotify intents
    tools/voice/commands.tsv lists what Buddy must understand (sentence, intent, query); ctest
    brain_corpus checks all of it, ctest topics the generated header. brain learns put on, keep
    playing, go back one song, a bit louder, a little quieter, skip this one, play the X playlist,
    number words, set_volume, shuffle, repeat, now_playing and play_liked; queries lose filler that
    can't be part of a name (songs by, the song, from → by).
    spotify: plain "play X" prefers your own playlist with that name, play_playlist falls back to
    public playlists, artist matches ignore a leading the/some, new actions for the intents ab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
    [commands.tsv]
2026-10-25 feat(voice): record and train speech-to-text from the PC
    deploy/record.sh shows prompts from tools/voice/commands.tsv on the PC while the Pi records raw and
    echo-cancelled audio at the same time (numbering by highest clip, redo, resume, level warnings).
    deploy/train.sh runs tools/voice (uv, buddy-voice): pull, check (levels, missing files, Silero VAD
    trimming), fine-tune on CUDA with a sentence-level validation split and a short audio context,
    convert with whisper.cpp's pinned converter (+ q8_0), score on the Pi (exact, intent via brain,
    WER, time, per session) and install. Also import (repairs old record-voice.sh data) and label
    (live commands saved by BUDDY_EARS_SAVE_DIR).
    ears: BUDDY_STT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
    [audio_source.cpp, audio_source.hpp]
2026-10-25 docs: improve commands.tsv
    [commands.tsv]
2026-10-27 fix(spotify): device list and liked songs looped over a destroyed temporary
    Range-for over json::parse(...)["key"] binds a reference into a temporary
    that dies before the loop body in C++20, so --cmd devices listed nothing
    and liked songs always looked empty in the Release build.
    [player.cpp]
2026-10-27 feat(brain): split off the speaker in "play … on the bathroom speaker"
    Commands that start playback (play, play_playlist, play_liked) carry the
    spoken speaker as "device"; "move the music to X" is play without a query.
    When the speaker might be part of a title ("Shine On You Crazy Diamond"),
    brain adds the unsplit reading as "fallback"; spotify knows the speakers.
    The corpus gets a device column and sentences for the speakers.
    [commands.tsv]
2026-10-27 feat(spotify): play on any Connect speaker by name
    A command's "device" picks the speaker (exact, contained or close name;
    "the box" = BUDDY_SPOTIFY_DEVICE; ambiguous names ask which). Without one,
    play goes to the box as before, while pause, next, volume, shuffle and
    repeat now go to the device that is playing. A name that matches no speaker
    runs brain's fallback reading, else says so.
    Ducking covers the box plus BUDDY_SPOTIFY_DUCK_DEVICES and restores by
    device id. Device fields of const JSON are read without operator[], which
    asserts on a missing key.
    [main.cpp, player.cpp, player.hpp]
2026-10-27 refactor: one whisper.cpp pin, audio_ctx cases instead of source greps
    third_party/whisper.json is read by CMake and tools/voice convert.py. auto_audio_ctx is checked
    against shared/tests/cases/audio_ctx.json (C++ side with the ears tests).
    Refs #4
2026-10-27 fix(spotify): broken duck file or liked-songs item no longer crash
    - recover(): const json's operator[] asserted on a duck file without restore_to/ducked_to
    (abort at start, every restart).
    - play_liked(): an item with a null or missing track failed the whole command.
    Both found by the new player tests.
    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
    [player.cpp]
2026-10-27 test(spotify): Http interface with a fake, auth and player tests
    CurlHttp implements the Http interface; spotify_core (auth, player, url_encode) links without
    libcurl. Tests cover speaker matching, device choice, search, liked songs, token refresh/retry,
    duck/restore/recover and the warm device list.
    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
2026-10-27 test(ears): endpointer and level gate without ONNX, audio_ctx cases
    endpoint.{hpp,cpp}: level_db, LevelHistory/LevelGate and Endpointer moved out of vad.cpp; the
    Endpointer takes a SpeechModel interface (SileroVad implements it), so ears_core links without
    ONNX Runtime. Tests: Done/NoSpeech/TooLong timing, click filter, hysteresis, level gate, history
    window, and auto_audio_ctx against shared/tests/cases/audio_ctx.json.
    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
2026-10-27 test(shared): queue, systemd notify and MQTT round trip in C++
    Same coverage as the Python side: BlockingQueue order/timeout/wake-up, READY + rate-limited
    WATCHDOG + STATUS on an abstract socket (own executable: process-wide watchdog state), and the
    MQTT status/event round trip with a throwing handler against the localhost broker.
    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
2026-10-27 test(voice): short_context() matches the stock encoder of the pinned transformers
    Random-weight tiny WhisperEncoder, no download; skipped without PyTorch.
    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
2026-10-27 docs: deploy/test.sh, test layout and conventions
    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
    [commands.tsv]
2026-10-28 docs: visual overview of the Pico motion controller setup (2.2)
2026-10-28 docs: hole-by-hole breadboard layout for the Pico motion controller
2026-10-28 docs: 330 Ω colour code for the 1 % resistor kit
2026-10-28 fix(brain): accept "skip the song", spoken digits in speaker names
    "Skip the song." was unknown, "desktop one" didn't match "desktop 1".
    Both cost intents in the 2026-10-28 eval. Refs #5
    [rules.cpp]
2026-10-28 fix(ears): cap whisper output by audio length, drop repeated sentences
    A short-context run repeated a command 40 times. max_tokens bounds
    output and decode time; a repeated first sentence is kept once. Refs #5
    [stt.cpp, transcript.cpp, transcript.hpp]
2026-10-28 fix(ears): detect repeated phrases by words, not sentences
    Stock models repeat without punctuation ("skip the song skip the song
    …"), which the sentence split missed. Refs #5
    [transcript.cpp, transcript.hpp]
2026-10-28 feat(hue): Hue lights skill over the bridge's local API
    buddy/hue/cmd (on, off, toggle, brightness, brighter, darker, color,
    temperature, scene, status) → CLIP v2 PUTs; the eventstream keeps the
    retained buddy/hue/state current. TLS is verified against Hue's root CA
    with the bridge id as host name. Requests per resource are throttled and
    merged. Pairing via --pair, offline tests via --cmd.
    Refs #6
2026-10-28 feat(brain): light commands routed to hue
    Light rules (on, off, brightness, brighter, darker, color, scene, status)
    need a light word, so music phrasings stay spotify; the room or lamp goes
    into device, also from a trailing "in the kitchen". The corpus light
    lines get their intents, plus phrasings for every action.
    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
    [commands.tsv]
2026-10-28 fix(brain): accept a short tail after next, go back, pause, louder/quieter
    Commands whose first word already decides the intent take a few more
    words: "next tune", "go back a song", "pause the radio", "a lot louder",
    "turn it down a notch". No digits (a level) and no "to" (a speaker).
    Eval 2026-10-28: recovers 4 of 19 intent failures of the fine-tuned model.
    [rules.cpp]
2026-10-29 feat(setup): pico step: ARM GCC, picotool 2.3.1, udev rules (D17)
2026-10-29 feat(motion): Pico firmware pico-motion, protocol v1, deploy --firmware (D17)
    - shared/include/buddy/motion_protocol.hpp: constexpr parse/format for both sides, MotionProtocol tests
    - firmware/pico-motion: 50 Hz PWM (level = µs), limits, ramps with DONE, link + hardware watchdog
    - deploy.sh --firmware: build on the Pi, flash with picotool
    - docs: guide 2.2, D17, repo tree, progress
    Closes #8
2026-10-29 feat(motion): motion service: joints, serial link, gestures (2.3)
    - services/motion: joint table (demo on ch0 until 2.5, head_tilt), speed cap,
    protocol v1 link with handshake, reconnect, PING, gesture player
    - gesture "shake" speaks "As you wish." and swings the demo servo
    - topics: motion_cmd/motion_state; "web": false keeps motion off the panel (D19)
    - deploy: motion in SERVICES, BUDDY_MOTION_* env keys
    Refs #9
2026-10-29 feat(brain): demo gesture "cut off Andi's balls" → motion shake
    - rule routes to buddy/motion/cmd {action: gesture, query: shake}
    - commands.tsv set extra: brain test only, never recorded or scored
    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
    [commands.tsv]
2026-10-29 fix(brain): demo gesture matches whisper's guesses for "Andi's"
    Live transcripts: "on these balls", "undies balls", "undistballs". Any ≤ 2 words
    (or one glued to "balls") between "cut off" and "balls" now count.
    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
    [rules.cpp]
2026-10-29 feat(web): light cards and switches take the lights' current colour
2026-10-29 feat(web): arrange rooms: reorder, hide and add back via ⚙
2026-10-29 feat(hue): create, overwrite and delete scenes
    scene_save snapshots a room's or zone's lights into a scene (POST), or
    overwrites the scene of that name in the group (PUT). scene_delete by
    scene id (web panel) or by name in a room (CLI). Bridge::put becomes
    send() with a method; POST/DELETE skip the throttle.
    Refs #10
    [bridge.cpp, bridge.hpp, home.cpp, home.hpp, lights.cpp, lights.hpp, main.cpp]
2026-10-29 perf(shared): idle main loops sleep until work or a stop signal
    brain, web and hue woke 5 times a second only to re-check running().
    The signal handler now writes to an eventfd; a stop thread runs on_stop()
    callbacks and wakes sleep(), whichever thread the signal landed on.
    BlockingQueue::close() ends pop() for good, so hue waits up to 5 s idle.
    Refs #11
2026-10-29 perf(web): encode each state change once, as a JSON Patch where possible
    Every open tab used to parse and re-encode each payload itself. StateStore
    now builds the SSE frames once and shares them; a stream that already has
    the previous payload gets an RFC 6902 patch (json::diff) when it's smaller.
    One Hue brightness change: 2996 → 274 bytes per tab.
    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
2026-10-29 perf(web): apply patch events and rebuild only cards that changed
    The page rebuilt every card on any update. keyed() reuses a child's DOM
    while the JSON of its inputs is unchanged; patch events are applied in
    place, a patch that doesn't fit reconnects for the full state. A failed
    command drops the cache so optimistic switches snap back.
    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
2026-10-29 perf(voice,spotify): idle main loops sleep until work or a stop signal
    Both woke 5 times a second only to check running() and ping the watchdog;
    neither polls anything while idle. pop() now waits up to 5 s (a push still
    wakes it at once, spotify's restore deadline still shortens it) and
    on_stop() closes the queue.
    Refs #12
    [main.cpp]
2026-10-29 feat(spotify): live player state for the panel, commands by device id, seek
    While a panel sends {"action":"watch"} (every 20 s), poll GET /me/player and
    /me/player/devices every BUDDY_SPOTIFY_POLL_S and publish device, track,
    progress and the device list in buddy/spotify/state. Progress is re-published
    only when it jumps. Commands take an exact device id; play + id moves the
    music there. New panel-only seek action.
    Refs #14
2026-10-29 feat(web): music card shows any Spotify device, speaker switching, progress bar
    Closes #14
2026-10-29 fix(spotify): keep a commanded volume or play state until Spotify reports it
    Spotify shows a new volume 0.7-2.6 s after the command, so the re-poll 1.5 s
    later often still saw the old one and the panel's slider jumped back until the
    next poll. Values a command set now win over lagging polls for up to 8 s.
    [main.cpp, player.hpp]
2026-10-29 docs: README with everyday commands, open-work list, deploy/run.sh, web panel notes
    - README.md: what Buddy is, where to read what, copy-paste commands for the PC and the Pi
    - deploy/run.sh <svc> [flags]: a service's offline mode on the Pi with buddy.env loaded
    (replaces the env-loading one-liner in the guides)
    - CLAUDE.md: Open work (Dev's checks, Claude's next steps), progress row 2 matches the Pi
    (motion deployed, waits for the Pico), new-service checklist incl. logs.sh and panel chips
    - skeleton/CLAUDE.md: deploy scripts table, spotify live state; web details moved to
    services/web/CLAUDE.md
    - buddy-hardware.md: Hue lights from the bridge, Motion section
    - Guides: 2.3 steps marked d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
2026-10-30 docs(hardware): motion parts as bought (servos, breadboard, supply, multimeter, 2nd Pico)
2026-10-30 docs(motion): breadboard layout for the 400-hole board, XL830L ranges, parts as bought
2026-10-30 docs: plain PETG for every printed part (no PLA, no PETG HF)
2026-10-30 docs(hardware): music box is a Nest Audio, Nest Mini in the bathroom (Cast devices)
2026-10-30 feat(deploy): Soloist back, music and voice sinks, Bluetooth for the Nests
    Soloist plays as the Connect device "Buddy" into buddy_music; buddy_voice carries Buddy's voice. The
    speakers service (next) routes both: music only ever to a Nest over Bluetooth, voice to that Nest while
    music plays there, else the Jabra.
    - buddy_music.output has node.autoconnect = false: WirePlumber never links it, speakers does with pw-link,
    and the link disappears with the Nest, so music can't fall back to the Jabra. A missing target.object
    with node.dont-fallback or node.dont-reconnect made WirePlumber destroy the stream and the sink with it.
    - WirePlumber: Bluetooth monitor without a logind seat (headless),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
2026-10-30 feat(spotify,voice,web): Nests as Spotify speakers, voice through buddy_voice
    spotify: the device list shows one entry per Nest (buddy/speakers/state, id "bt:<mac>") in place of
    Soloist (BUDDY_SPOTIFY_LOCAL_DEVICE, "Buddy"), merged in fetch_devices(), so speaker names, the box,
    panel ids and the snapshot all work on Nests. Commands to a Nest go to Soloist's id; starting playback
    on one publishes buddy/speakers/cmd {output}. A phone casting straight to a Nest keeps its own entry
    while it plays. Without speakers state (CLI runs) Soloist is listed as itself.
    voice: plays into buddy_voice (BUDDY_VOICE_DEVICE default), which speakers routes; falls back to the
    ALSA default once if that sink is mi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
2026-10-30 perf(speakers,spotify): faster Nest switching, quieter voice on a Nest, fresher panel
    Measured on the Pi (2026-10-30): a full Bluetooth disconnect takes 2.5–2.8 s and the next Nest waited for
    it; bluetoothctl itself costs 11 ms. Now:
    - speakers releases only the old Nest's A2DP profile (15 ms), connects the new one, and finishes the
    disconnect in the background (doing it in parallel slowed the connect to 6.4 s).
    - spotify sends the output to speakers before its Web API call, so the Nest connects while Spotify starts;
    Nest to Nest while Soloist is active is only an output change (the transfer to the same device paused
    Soloist for a moment and moved the voice away and back).
    - A gap i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
2026-10-30 docs: Nest speakers over Bluetooth (D20, 1.15)
    CLAUDE.md: D20, D10 and D13 updated, architecture, progress row 1.15, recheck in the open work.
    01-setup-summary.md: section 1.15 (why Bluetooth, Soloist, speakers, one Nest at a time, pairing,
    measurements, troubleshooting), rebuild step 6c, ducking and panel notes. buddy-hardware.md: Nests over
    Bluetooth, alias, signal. README: run.sh speakers. skeleton/CLAUDE.md: speakers and spotify rows,
    deploy files, PipeWire/WirePlumber and Nest gotchas, config defaults rule.
    Refs #17
2026-10-30 fix(hue): a room named "Home" is reachable by voice, "its white" for one light
    [home.cpp, home.hpp, lights.cpp]
2026-10-30 test(hue): Dev's bridge as a fixture, corpus light lines use its real names
    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
    [commands.tsv]
2026-10-30 docs: plans for 2.5 head pan/tilt and 2.6 head & body, CAD prompt
2026-10-30 docs: X2D + AMS as printer, PETG and PLA only (PLA for support interfaces, jigs, cosmetics), no TPU
    [params.scad]
2026-10-31 feat(game): Riftbound card data, code parser and decklists (5.1, #19)
    fetch-cards.sh pulls Riftcodex onto the Pi (newest entry per printing,
    pruned). riftbound lib: printed-code parser, CardDb (printings grouped
    by name, home printing, tags merged, stat conflicts flagged, OPP promos
    told apart by /total), Piltover Archive decklists checked against Core
    Rules 103. Vi (Unleashed) and Zed (Vendetta) precon lists. buddy-game
    --deck/--check/--code; deploy.sh installs game without a unit until 5.6.
2026-10-31 feat(game): Riftbound turns, runes and costs, Burn Out, random games (5.2, #22)
    Turn structure 315-317 as tasks (Awaken, Beginning, Channel 2 (+1 on turn 2,
    487.7), Draw, Main, Ending), rune pools 165-167, canonical payment from pool
    and runes with a Recycle decision only for the domain, units and gear played
    to base (359.2), Burn Out 432 incl. the immediate win 432.3.c, win check in
    cleanups 323.1, concede 649. play_random() + buddy-game --random checks the
    invariants after every action.
    [engine.cpp, engine.hpp, main.cpp, pay.cpp, pay.hpp, random_game.cpp, random_game.hpp, state.cpp]
2026-10-31 feat(game): Riftbound chain, priority, timing and cleanups (5.2, #23)
    Cards go on the chain as pending items and are finalized oldest first; units
    and gear resolve at once, spells wait until both players pass in a row and
    resolve newest first. Priority goes to the newest item's controller plus the
    passes in turn order. Timing: Closed takes only Reaction, Showdown Action or
    Reaction (Card::timing from the leading keyword). Cleanups follow 323's order:
    win check, lethal damage, battlefield control, recall, hidden cards; the
    Ending Special Cleanup kills before it heals. Random games play spells and
    reactions.
    [card_db.cpp, card_db.hpp, engine.cpp, engine.hpp, main.cpp, random_game.cpp, random_game.hpp, state.cpp]
2026-10-31 docs: 5.2 chain, priority and cleanups as built (#23)
2026-10-31 feat(game): Riftbound abilities, targeting, costs and layers (5.2, #24)
    CardRules hooks via Card::rules: activated, triggered (incl. reflexive and
    delayed), replacement and passive abilities; generic Choose decision for
    targets, may, optional costs, cost cards, trigger order and choices while
    resolving; finalize and resolve as step machines; game actions with events
    and replacements (actions.hpp); layers 479 as a fixpoint; cost modifiers
    356; new choices 750. Test card per ability kind, random games with them.
    [actions.cpp, actions.hpp, card_db.hpp, engine.cpp, engine.hpp, pay.hpp, random_game.cpp, random_game.hpp]
2026-10-31 feat(game): Riftbound movement, showdowns, combat and scoring (5.2, #25)
    Standard Move per destination with a unit choice (144, Ganking), units
    played to controlled battlefields (355.2), Contested and derived staging
    in the cleanup (323.2-323.13), showdown focus (341-348), combat as tasks
    after each chain with canonical damage assignment (467: lethal first, no
    overkill, Tank), Combat Special Cleanup, control and conquer (468),
    Hold and the final point (469-474). Assault and Shield in layer 4.
    Random games now end on points in ~17 turns.
    [actions.cpp, actions.hpp, engine.cpp, main.cpp, random_game.cpp, random_game.hpp, state.cpp, state.hpp]
2026-10-31 feat(game): Riftbound game actions and the decks' keywords (5.2, #26)
    Game actions banish, return to hand, burn, predict, add, pay, attach/detach and
    token plays (Bird, Shadow Clone, Gold). Keywords Accelerate, Ambush, Deflect,
    Vision, Repeat, Empower, Flow and Equip; Might Bonus of attached Equipment.
    Choices follow 355's order (optional costs, location, targets) and are offered
    only if the play can still be completed and paid (355.16). Costs gain [A],
    Burn, discard a spell and banish me.
    [actions.cpp, actions.hpp, engine.cpp, pay.cpp, pay.hpp, random_game.cpp, rules.cpp, rules.hpp]
2026-10-31 feat(game): Riftbound hidden information, replay and the 1000-game gate (5.2, #27)
    - Object::known tracks who knows each card (128); view() hides the rest,
    determinize() refills hidden cards from the decklists for search (5.4)
    - setup creates deck objects in shuffled order: ids carry no card information
    - replay text format (seed, decklists, actions), buddy-game --replay; a failing
    random game writes its replay; GameChecks shared by play_random and replays
    - RiftboundGate: 1000 seeded vi vs zed games; ctest label riftbound on all game
    tests, deploy/test.sh --riftbound runs them
    - buddy-game --random prints games/s, sizeof(GameState) and copy time
    [engine.cpp, hidden.cpp, hidden.hpp, main.cpp, random_game.cpp, random_game.hpp, replay.cpp, replay.hpp]
2026-11-01 docs: Serrated Dirk and Hextech Gauntlets as printed (Might Bonus, effect text)
2026-11-01 feat(game): card registry and the decks' simple units (5.3.1, #28)
    cards/ holds one CardRules per deck card, attached by CardDb::parse by name.
    First 13: Rengar Unseen, Inferna, Sharkling, Towering Pairofant, Arena
    Kingpin, Loyal Poro, Carrion Dredger, Crimson Pigeons, Shadow Assassin,
    Shadowblade Lurker, Kinkou Lifeblade, Shadow Fiend, Punching Poro; one test
    each plus 40 random games per deck file. buddy-game --check shows which
    cards have rules, --random --rules plays with them.
2026-11-01 feat(game): the decks' spells and gear, Equipment effect keywords (5.3.2, #29)
    Vault Breaker, Square Up, Right of Conquest, Tactical Retreat, Upstage
    Comedy, Soul Harvest, Divining Shells, Serrated Dirk, Hextech Gauntlets,
    Ruthless Strike, Perfect Execution, Twilight Step, Wind and Ghosts, Death
    Mark; one test each. CardRules::effect_keywords(): an Equipment's effect
    text keywords join its unit's own (718.3), for Serrated Dirk's [Assault].
2026-11-01 feat(game): the decks' legends and battlefields, battlefield ability control (5.3.4, #31)
    Vi Piltover Enforcer, Zed Master of Shadows, Trapping Grounds, Star Spring,
    Valley of Idols, Zaun Warrens, Shadow Temple, Threshold of the Gray; one
    test each. Every card of both decks now has rules: they load without
    vanilla mode.
    190.6: a battlefield's abilities are controlled by its controller, else the
    turn player; AbilitySpec::event_player hands one to the player who acted
    ("they may pay", "when you conquer here").
    fix(game): Awaken readies the legend too (315.1.b). GameChecks checks the
    readied board at each turn's first state: a Reaction played in a
    Beginning-phase chain may enter exhausted bef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
    [actions.cpp, actions.hpp, engine.cpp, random_game.cpp, random_game.hpp, rules.hpp]
2026-11-01 feat(game): Twilight Step picks its destination as it's played
    Dev's ruling: the destination is chosen on cast, not on resolution.
    TargetSpec::location: a picked (not targeted) slot over the battlefields and
    the base, filled while finalizing like any target and rechecked on
    resolution (Resolution::location). Unit already there by then: no move.
2026-11-01 docs: Star Spring and Mageseeker rulings confirmed by Dev
2026-11-01 docs: arm shopping list
2026-11-01 perf(game): engine 2.6x faster on the Pi, same games (#36)
    - active_rules checks the object's zone before the card; drop the unused
    CardRules::active_in hook
    - apply checks the one action (is_legal) instead of rebuilding
    legal_actions; a test probes both against each other
    - GameState::active: ascending ids in board and legend zones, kept by
    move_to/create, checked by check_invariants; the rules' object loops
    walk it instead of every object
    - --random prints a digest of all games and the engine-only speed
    Pi Release, seeds 0-999 with rules: 55k -> 143k actions/s with checks,
    64k -> 244k engine only. Digest unchanged (rules 3fa44f83335b8657,
    vanilla d04c2a02e1c41238), greedy vs rando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
2026-11-01 fix(game): Gust Monk picks its card on the chain; rulings confirmed
    Dev confirmed every 5.3 ruling. The one change: Gust Monk's banished card
    is picked with the unit as the trigger goes on the chain, not while it
    resolves; a card gone from the trash by then gives no Assault. Notes for
    the AI: Zed, Without a Sound at the same location is a wasted play,
    Vi, Piltover Enforcer rarely targets an enemy.
2026-11-01 feat(game): v2 ISMCTS, tuned and timed on the Pi (#37, #38)
    SO-ISMCTS over action keys: a determinization per iteration, UCB1 with
    availability counts, truncated playouts scored by eval, iteration or time
    budget, root-parallel threads. buddy-game --match takes ismcts with
    --iterations/--budget-ms/--threads/--tune.
    Tuned c 0.4, playout 10: 160/200 vs greedy at 1000 iterations (fresh
    seeds 325/400), 8000 iterations 184/200. Pi with services running: 2 s,
    3 threads, ~78k iterations, p95 2.003 s. 5.4 done.
    Closes #37, closes #38
2026-11-04 feat(table): sim faults and property tests (#41)
    Seeded faults per op (misread, unreadable, double/missed feed, double take,
    double deal) and per command (disturbed pile). Random command sequences with
    each fault alone and all together: what leaves the hand is what was reported,
    the hand is true after every recovery, all of it after a final rescan.
    What the tests changed: reads vote (confirm_reads of one code), a failed read
    puts the dealt card back, recovery passes and the retry after a mismatch take
    every card through the scan spot and read it (blind feeds can skip a card).
    Closes #41
    [sim.cpp, sim.hpp, tracker.cpp, tracker.hpp]
2026-11-04 feat(game): engine moves to table commands, table workload (#42)
    riftbound: a thread-local move log in move_to/create, installed only around
    the referee's new_game/apply (a state diff can't order a Burn Out between
    two draws). game_core: TableMoves turns one step's log into table commands
    (chain and set-aside hops collapse, deals merge, Vision = peek, exhaust from
    the state), nearest_copy picks the copy nearest the pile's bottom, and
    buddy-game --table-workload writes games as JSON lines for the soak.
    table: plays exactly the asked copy (game picks the nearest), so the engine's
    hand order stays the pile's; StandIn plays a workload against the sim.
    Test: 40 random and 8 greedy games, both de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
    [main.cpp, soak.cpp, soak.hpp, state.cpp, state.hpp, table_moves.cpp, table_moves.hpp]
2026-11-04 feat(table): table service, deploy and docs (#44)
    buddy@table: sim backend, buddy/table/cmd → buddy/table/event, the belief
    retained on buddy/table/debug (not /state: web streams those to the browser
    and this one holds Buddy's hand); --cmd offline mode, --soak. setup may carry
    the sim's deck codes. New-service checklist: topics, deploy.sh, logs.sh,
    buddy.env.example, panel chip. pytest no longer collects build dirs.
    Docs: services/table/CLAUDE.md, skeleton and game notes, README, plan (5.5
    as built), progress table: 5.5 done. On the Pi: 643 tests green, the gate
    pipeline 0 unrecovered.
    Closes #44
    [main.cpp, sim.cpp, sim.hpp, table_protocol.hpp]
2026-11-06 3d: first print
    [tray-box.stl, tray-lid.stl, tray.scad]
2026-11-06 3d: tray directory
    [tray-box.stl, tray-lid.stl, tray.3mf, tray.scad]
2026-11-06 build(parts): pinned CAD toolchain, Manifold backend
    - parts/tools/setup.sh: OpenSCAD nightly 2026.10.22 (extracted AppImage), BOSL2 v2.0.784 and
    NopSCADlib v21.43.1 as submodules in parts/lib, uv project with trimesh/manifold3d/pyvista
    - arm/build.sh: --backend=manifold, binary STL, OPENSCADPATH=parts/lib
    - arm STLs re-exported: same geometry (volumes equal, 0.000 mm max deviation), 4.9 -> 1.4 MB;
    upper-arm-top builds in 0.13 s instead of 17.5 s
    - parts/CLAUDE.md: toolchain and conventions
    Refs #54
    [couplers.stl, forearm-bottom.stl, forearm-top.stl, shoulder-mount.stl, upper-arm-bottom.stl, upper-arm-top.stl]
2026-11-06 feat(parts): cad build and cad render
    - parts/cad wrapper → cad CLI (uv project in parts/tools, src layout); modules are folders with cad.toml
    - build: parallel, Manifold, binary STL; any OpenSCAD WARNING/ERROR fails; per-part size, volume, PETG mass,
    bed/overhang/roof areas
    - render: 3x3 part sheet (orthographic views with mm scales, print classes coloured, x-ray of the downward
    problem faces), 2D sections with a mm grid, assembly sheet from OpenSCAD's preview (colours, ghosts, -D poses);
    headless on EGL
    - arm: cad.toml replaces build.sh; STLs unchanged
    - tests: bracket fixture with planted defects (round hole, shelf, missing hole, 45° chamfer), 11 pytest cases;
    blind check: a ra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
    [bracket.scad, warns.scad]
2026-11-07 feat(parts): add dispenser
    [dispenser.stl]
2026-11-07 feat(parts): dispenser roller (belt conveyor under the left pile)
    Belt conveyor that moves the bottom card of pile H either way: out of the
    open left side (take) or through the divider slot onto the lift (feed).
    - 3 NBR O-rings 80x3 on printed drive/idler drums (MR105ZZ on fixed 5 mm
    rods), sliding on a flat bed so a pile can't sag them
    - 4023 turned 90 deg (shaft to the front) behind the back plate, 20:16
    printed gear pair puts the drive drum 1 mm from the divider
    - two swappable gates (1.5 card thicknesses) under the left wall and in
    front of the divider, belt top = divider block - gap
    - front plate separate so the closed O-rings slide on from the front
    - make_copy.py: dispenser-rol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
    [assembly.scad, box.stl, dispenser-roller.stl, drive-drum.scad, drive-drum.stl, front-plate.scad, front-plate.stl, gate.scad]
2026-11-07 fix(parts): tighter tray lid (rim gap 0.15 -> 0.10 per side)
    [tray-lid.stl]
2026-11-07 fix(parts): tighter tray lid (rim gap 0.10 -> 0.07 per side)
    [tray-lid.stl]
2026-11-07 feat(parts): dispenser pusher (stack B onto H) on the 17HS4401 lead screw
    Carriage on two 5 mm rods in the front strip, TR8 nut ahead of the coupling,
    35 mm plate that rests in a notch of the right wall. Mount on the wall's
    outer face holds the motor and closes the pocket. Box cuts for Dev in the
    copy and the README; check_pusher.py checks the stroke for collisions.
    Refs #55
    [assembly.scad, dispenser-roller.stl, lib.scad, params.scad, pusher-mount.scad, pusher-mount.stl, pusher.scad, pusher.stl]
2026-11-07 refactor(parts): simpler dispenser pusher, lift-like carriage without rods or coupling
    The carriage (plate + bar + nut tab) rests on the lift by its weight, which
    also keeps the nut from turning. The 17HS4401 with integrated TR8x8 screw sits
    half in the box in a cradle Dev adds to the right wall; the screw runs to a
    hole in the left wall. Drops the rods, the coupling, the screwed-on mount and
    its 8 wall holes. Refs #55.
    [assembly.scad, dispenser-roller.stl, lib.scad, params.scad, pusher-mount.scad, pusher-mount.stl, pusher.scad, pusher.stl]
2026-11-07 fix(parts): dispenser pusher with coupling on the wall, lift motor under the floor, 35 mm piles
    Both lead screws get the 8/5 flexible coupling. The pusher motor screws onto
    the right wall's outer face (wall extended forward around it) instead of a
    cradle; the notch is 4 mm deep so its 1 mm skin is the home stop. Piles go up
    to 35 mm (30 loose cards): plate 35 high, screw raised to z 154. The lift's
    coupling would block its nut at the bottom of travel, so its motor moves under
    the floor. Refs #55.
    [assembly.scad, dispenser-roller.stl, lib.scad, params.scad, pusher.stl]
2026-11-07 feat(parts): dispenser right gate with a lip between drum and divider, slit narrowed to the card
    [dispenser-roller.stl, gate-left.scad, gate-left.stl, gate-right.scad, gate-right.stl, gate.scad, lib.scad, params.scad]
2026-11-07 feat(parts): dispenser slot ends filled in the divider, one 45° funnel with the right gate
    [dispenser-roller.stl, gate-right.stl, lib.scad, params.scad]
2026-11-07 refactor(parts): dispenser 8.5 mm back, 4023 connector down in the back wall on a hold, pusher motor hold
    [assembly.scad, dispenser-roller.stl, gate-left.stl, gate-right.stl, lib.scad, params.scad, pusher.stl, roller-frame.stl]
2026-11-07 feat(parts): dispenser printed compact lift, cards 10 mm further back, shorter roller, pile B front border
    [assembly.scad, dispenser-roller.stl, drive-drum.stl, front-plate.stl, gate-left.stl, gate-right.stl, idler-drum.stl, lib.scad]
2026-11-07 docs(parts): dispenser lift assembly order
2026-11-07 fix(parts): dispenser lift nut back under a top tab (Dev's), riser and front border leaning ~10° to lead dropping cards
    [dispenser-roller.stl, drive-drum.stl, front-plate.stl, gate-left.stl, gate-right.stl, idler-drum.stl, lib.scad, lift.stl]
2026-11-07 fix(parts): dispenser lift nut tab back to Dev's (round end, 5 holes, flange under it), slope from the tab to the plate; drop Dev's old lift nut from the copy
    [dispenser-roller.stl, drive-drum.stl, gate-left.stl, gate-right.stl, idler-drum.stl, lib.scad, lift.stl, params.scad]
2026-11-07 fix(parts): dispenser lift slope with straight sides
    [dispenser-roller.stl, lib.scad, lift.stl, params.scad]
2026-11-07 fix(parts): dispenser lift plate top 92 mm long again (Dev's), pusher plate and front border with it
    [dispenser-roller.stl, lift.stl, params.scad, pusher.stl]
2026-11-07 feat(parts): dispenser borders for pile H: front and back in the box, wedge at the divider on the right gate
    [dispenser-roller.stl, gate-right.stl, lib.scad]
2026-11-08 feat(parts): dispenser right gate part of the box (joined to the divider and pile H's borders), sleeved cards 66.5 x 91
    [assembly.scad, dispenser-roller.stl, drive-drum.stl, front-plate.stl, gate-left.scad, gate-left.stl, gate-right.scad, gate-right.stl]
2026-11-08 feat(parts): dispenser case as one printable piece (on its back, no supports), front borders as slide-in parts, feet
    The gate gap's chain (floor, divider, right gate) stays one piece. Printed on its back the slot and the gate gap lie in
    the XY plane; upright the slot's roof would be a 103 mm bridge 1 mm over the divider. For that orientation: the right
    gate's bar runs into the back wall, pile H's back border is solid to it, the pusher motor hold gets a 45° back, the 4023
    hold ends at the wall's outer face, holes are teardrops towards the front. The front borders of H and B would be roofs
    on their card faces, so they are separate parts with a stop and 2 M3 each. Rails 42 mm under the floor f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
    [assembly.scad, border-b.scad, border-b.stl, border-h.scad, border-h.stl, case.scad, case.stl, dispenser-roller.stl]
2026-11-08 fix(parts): dispenser build fails when the right gate's lip drops below the divider; cad build takes -D
    The lip top is belt_top - 0.5 = 66.04 - 1.5 card_t - 0.5: above the divider's lower part (z 65) only up to card_t 0.35.
    Sleeved cards are thicker, so the case must wait for the measured thickness. cad build -D was documented in the
    dispenser README (gate tuning) but not implemented.
    [lib.scad]
2026-11-08 docs(parts): dispenser card_t must be measured before the case is printed
2026-11-08 feat(parts): dispenser for sleeved cards 0.5 mm pressed: gap 0.75, lip a card + 0.2 under the belts, divider cut under it
    Dev: sleeved cards are under 0.5 mm pressed flat, over 1 mm loose (bow, air). card_t = 0.5, the upper bound, so the
    printed case suits anything thinner: the slot bottom follows the lip (case cuts the divider's lower part from z 65 to
    64.53 in the funnel), and the right gate's legs leave 0.5 over the frame plates so a thinner card only means a new frame
    (-D gap=...). The lip-above-divider assert becomes slot_bot <= div_low.
    [border-b.stl, case.stl, dispenser-roller.stl, front-plate.stl, gate-left.stl, lib.scad, lift.stl, params.scad]
2026-11-08 feat(parts): dispenser gate gap 0.65 mm (Dev), belts at z 65.39, lip and slot bottom with them
    [border-b.stl, case.stl, dispenser-roller.stl, front-plate.stl, gate-left.stl, lift.stl, params.scad, roller-frame.stl]
2026-11-08 feat(parts): dispenser case walls and floor 3 mm, 5 mm pads at the pusher's notch, motor face and screw bearing
    Thinned from the outside (inner faces unchanged); the divider stays 5. Pad back ends at 45° for the print on its back.
    Lift motor face moves up to the floor's underside at z 2 (M3x6 now), rails 42 under it. Solid volume 732 -> 550 cm3,
    printed ~40 g less with 4 walls.
    [border-b.stl, case.stl, dispenser-roller.stl, lib.scad, params.scad]
2026-11-08 feat(parts): dispenser case walls and floor 4 mm (Dev), lift motor back on M3x8
    [border-b.stl, case.stl, dispenser-roller.stl, params.scad]
2026-11-08 docs: dispenser shopping list with the missing parts linked, cart items ticked; set screw M3x5
2026-11-08 fix(speakers,brain): reset stuck Bluetooth connect, split bare "in … speaker"
    A failed connect left bluetoothd's a2dp-sink for the Main speaker in
    "connecting": every later Connect failed with InProgress until a
    Disconnect. connect() now disconnects before its retry and logs why it
    failed. brain splits "play spotify in bathroom speaker" off as a device.
    Closes #56
    [commands.tsv]
2026-11-09 feat(parts): dispenser walls and divider 3 mm, gate gap 0.55 mm, box top cut to the pusher motor pad (Dev)
    Divider thinned at its right face (x 72..75): shorter slot, gates and roller unchanged, lift plate 2 mm wider.
    Box top z 200 -> 177.19. Lift motor on M3x6 again, lift screw 151 mm.
    [border-b.stl, case.stl, dispenser-roller.stl, front-plate.stl, gate-left.stl, lib.scad, lift.stl, params.scad]
2026-11-09 feat(parts): dispenser right of the divider moved 2 mm left, lift plate back to 67 mm (Dev)
    The box part right of the divider (floor, back wall, right wall) moves left by what the divider lost (b_shift), and with
    it the lift, both motors, the pusher and border B. Box 2 mm narrower, pusher stroke 71 mm, pusher screw 128 mm.
    [border-b.stl, case.stl, dispenser-roller.stl, lib.scad, lift.stl, params.scad, pusher.stl]
2026-11-09 feat(parts): dispenser drum axles as 4 short pins, drums solid (#57)
    Dev can't cut the 119.9 mm rods. Each bearing now sits on its own ready-made
    dowel pin 5 x 12: back pins in the existing blind holes, front pins through the
    front plate behind the existing keepers. The drums lose their through bore and
    are solid between two pin pockets. Shopping list: pins instead of the shaft,
    other grub screw sources.
    Closes #57
    [assembly.scad, dispenser-roller.stl, drive-drum.stl, idler-drum.stl, lib.scad, params.scad]
2026-11-09 feat(parts): dispenser drum pins 5 x 28 (RS PRO), deeper pin pockets (#58)
    Dev's pick from Galaxus. Same 5 mm as the MR105, so the bearings stay; the
    longer pins reach deeper into the drums, the middle stays solid.
    Closes #58
    [dispenser-roller.stl, drive-drum.stl, idler-drum.stl, params.scad]
2026-11-09 feat(parts): dispenser drum bearings 685ZZ 5 x 11 x 5 (#59)
    Dev orders from Bastelgarage. Same 5 mm bore, so the pins stay; seats 11.1 wide
    and 5 deep. Walls get thinner (idler ends 1.7 mm, ~1.2 mm under the drive gear's
    roots): noted for the press-fit test print.
    Closes #59
    [dispenser-roller.stl, drive-drum.scad, drive-drum.stl, idler-drum.scad, idler-drum.stl, params.scad]
2026-11-09 feat(parts): dispenser drum pins 5 x 20 (RS PRO, 20 pcs) (#60)
    Dev's pick from Galaxus. Still 8-9 mm past the 685ZZ into the drum; shorter
    pockets, the drum gets a bit more solid.
    Closes #60
    [dispenser-roller.stl, drive-drum.stl, idler-drum.stl, params.scad]
2026-11-09 docs(parts): dispenser lift and pusher print in PLA, orientation reasons
2026-11-09 docs: PLA allowed for low-load functional parts away from heat
2026-11-09 docs: PLA near a motor only at moderate current (pusher at home)
2026-11-09 feat(parts): dispenser pusher guide ridge against turning (#61)
    Ridge on the tops of border H, the divider and border B (grown to the
    divider's top) in a groove in the carriage's bar: the plate's far end
    can rise ~0.4 mm at most instead of tipping at ~2.5 N. Free in Z, so
    the plate still rests on the lift. The carriage now goes in halfway
    along, not straight into the notch.
    [border-b.stl, border-h.stl, case.stl, dispenser-roller.stl, lib.scad, params.scad, pusher.stl]
2026-11-09 feat(dispenser): thin lift and pusher to 3 mm walls
    Lift: plate 4 -> 3, slope a 3 mm leaning wall instead of a 12 mm wedge,
    nut tab 5 -> 3. Pusher: plate 4 -> 3, tab 5 -> 3, bar and gusset an
    upside-down U of 3 mm walls with the guide ridge inside. New design
    rule: walls 3 mm max unless the part takes real load.
    [case.stl, dispenser-roller.stl, lib.scad, lift.stl, params.scad, pusher.stl]
2026-11-09 feat(dispenser): drop the case's 5 mm pads, thin ribs and feet to 3 mm
    Side walls are 3 mm everywhere. The pusher motor sits on the thinned right
    wall (face x 146, M3x6) and on a 2 mm skin that closes the pusher's notch,
    which now goes through the wall; the motor rises 1.65 mm to sit on it.
    Roller frame ribs 5 -> 3 with a teardrop boss for the front plate's screw,
    feet 5 -> 3. The notch skin joins before the front cut, so its front face
    and the wall's come from one cut (flush faces added later missed by an
    ulp: case not watertight).
    [case.stl, dispenser-roller.stl, front-plate.stl, lib.scad, params.scad, pusher.stl, roller-frame.stl]
2026-11-09 docs(parts): flush faces after a cut miss by an ulp
2026-11-09 fix(parts): tray.mf fix
    [tray.3mf]
2026-11-09 feat(dispenser): printed TR8x8 nut replaces the brass nut
    PETG, 4-start thread with 0.2 mm per side (nut_slop, to tune), body 11 so
    1.3 mm stays under the thread root. Pusher's nut hole gets a flat-topped
    teardrop: the tip cut into the upper M3 pilot hole. Shopping list: no
    brass nuts, 2 limit switches, inserts and insert tips from 3DJake.
    [dispenser-roller.stl, lib.scad, params.scad, pusher.stl, tr8-nut.scad, tr8-nut.stl]
2026-11-09 feat(dispenser): lead screws 200 mm uncut
    Dev can't cut metal and no Swiss shop has 100 mm TR8x8. Both screws go
    into their couplings up to the shaft tip; the pusher's sticks 75 mm out of
    the left wall, the lift's 47 mm above the box top. Both clear the case.
    [dispenser-roller.stl, params.scad]
2026-11-09 feat(parts): cad plate packs a module's parts into one STL per print job (#62)
2026-11-09 feat(dispenser): print plates and a built-in support under the lift's tab (#62)
    [1-petg-fine.stl, 2-petg.stl, 3-pla.stl, lib.scad, lift-support.scad, lift-support.stl, lift.scad, params.scad]
2026-11-09 fix(parts): section render falls back to closed rings when polygons_full is empty
    [tr8-nut.scad, tr8-nut.stl]
2026-11-09 feat(dispenser): printed joints instead of screws, fit test plate (#63)
    [0-fit-test.stl, 1-petg-fine.stl, 2-petg.stl, 3-pla.stl, border-b.stl, border-h.stl, border-pin.scad, border-pin.stl]
2026-11-09 docs(printing): PLA press fit 0.07 per side from the tray lid
2026-11-09 docs(dispenser): fit test plate at 10 % infill
2026-11-09 feat(dispenser): pile H borders down to under the belt top, slant from there (#64)
    Front and back border of pile H from z 70.5 down to belt top - 0.4 (65.09):
    no card slides out under them. Lean starts at the new bottom (5.3 mm).
    Back border: below the left wall only between the gates, channel for the
    drum gear. Border H goes in last (gear and O-rings pass under its place).
    [2-petg.stl, border-h.stl, case.stl, dispenser-roller.stl, lib.scad, params.scad]
2026-11-10 fix(dispenser): drop the lift's built-in support, Bambu Studio generates it
    Plate 3 now holds only the pusher and the lift; its note and README row turn
    auto supports on (tree, build plate only). parts/CLAUDE.md: parts get no
    support in the file when the slicer can generate it.
    [3-pla.stl, lib.scad, lift-support.scad, lift-support.stl, lift.scad, lift.stl, params.scad]
2026-11-10 feat(dispenser): case-spares, the case with ~93 cm³ less PETG (#65)
    Rear top cut behind the pusher motor, back wall windows on the bed (closed
    under pile H, post behind the lift tab's path), floor window under the
    lift, truss feet. Still on its back without supports; case.stl unchanged.
    [case-spares.scad, case-spares.stl, lib.scad, params.scad]
2026-11-10 feat(dispenser): case-spares, X-braced back wall beside the lift tab's post (#65)
    Crossbar under the post, the slots beside it X-braced: stiffer back wall
    behind pile B for 4.8 cm³.
    [case-spares.stl, lib.scad, params.scad]
2026-11-11 fix(dispenser): commit the STLs rebuilt with the measured fits
    The fit-test values went into params.scad in 11feb5e, but border H, border B,
    the roller frame, the pusher, plate 2 and the combined copy were never
    committed with them. Plate 2 on GitHub still had the pre-test fits: border H's
    pin holes Ø3.0 (too tight), border B's Ø3.1 (pins slide out).
    README: which of the case's 8 holes take a border pin and which an M3×12.
    [2-petg.stl, border-b.stl, border-h.stl, dispenser-roller.stl, pusher.stl, roller-frame.stl]
